songgagav/spiral_soft_arm/related-papers/README.md

# Reference paper

The PDF in this folder is an unchanged copy of:

Wang, Z., Freris, N. M., and Wei, X. “SpiRobs: Logarithmic spiral-shaped robots for versatile grasping across scales.” *Device* 3(4), 100646 (2025). https://doi.org/10.1016/j.device.2024.100646

The article is distributed under the [Creative Commons Attribution-NonCommercial-NoDerivatives 4.0 International license](https://creativecommons.org/licenses/by-nc-nd/4.0/). It is provided for non-commercial research reference and is not relicensed by this repository's `LICENSE` file. See the [publisher's article page](https://www.sciencedirect.com/science/article/pii/S2666998624006033) for the published version and license details.
