songgagav/spiral_soft_arm/hardware/reference/README.md

# Third-party hardware references

The STEP models and C610 user guide in this folder are reference material for component fit and system planning. They remain subject to their original vendor copyright and terms. The repository's root `LICENSE` does not grant rights to redistribute or modify these third-party files; check the source vendor terms before reuse.
