songgagav/spiral_soft_arm/local/spiral-soft-arm/hardware/README.md

# 本地样机硬件资料

本目录记录 B32 水下软体机械臂的硬件接口方案、监测接线和单台执行器验证流程。

## 当前资料

- [硬件拓扑图（PNG）](硬件连接拓扑图_2026-10-22.png)：用于快速查看岸上供电、脐带缆、头端电子仓、CAN、PWM、电机和监测支路。
- [硬件拓扑图（SVG）](硬件连接拓扑图_2026-10-22.svg)：可缩放的源图。
- [硬件拓扑与接口补充清单](硬件拓扑与接口补充清单_2026-10-22.md)：已确认参数、逐接口说明、建议补充的硬件、压降粗估和上电验证顺序。
- [4092 单台样机验证流程与记录模板](4092_单台样机验证流程与记录模板.md)：采购到货、PWM、带载、温升与水下测试记录。

## 图纸状态

图纸采用用户确认的 4S1P、每节 8 Ah、配套 mini ESC 双向 PWM 和 4 mm² 脐带动力线。电池侧电压/电流、UPS 输出母线电压/电流及电池、ESC、电源模块温度监测已加入接线拓扑。

图纸用于连接评审。实物连接器针脚、保险和接触器额定值、压力穿舱件、散热、UPS 再生回灌和整机运行时间需要按实际器件与样机试验核对。图纸不代表打印件、水密或 5 m 压力测试已经通过。
