songgagav/spiral_soft_arm/local/spiral-soft-arm/solidworks/electronics_enclosure_v24_selected_hardware/README.md

# B32 v24：选定硬件电子仓布置

## 范围

v24 沿用 v23 的 B32 三段机械臂、250 mm 六边形顶盘、三路 M3508/C620、直角传动、线轮和轴封候选。只重布直径 136 mm 的中央电子仓及其硬件占位，另存模型，不修改 v23。根据用户 2026-11-06 的确认，电池仍为 **21700 × 4**，4S1P；本轮所写的“12700”不用于模型。

电子仓外径 Ø136 mm、名义内径 Ø126 mm、仓体 Z=-230 至 -20 mm。内部件沿底盖检修方向分层：顶部为四节电芯与三只 C620；中部为主控、UPS 和原供电方案中的 9–35 V→24 V/15 A 稳压器；底部为 PD1002、理想二极管和 4S40A 保护板。M28 两芯 50 A 岸电口位于底盖中心，M12 Type-C 辅助供电口位于靠 PD1002 的侧壁。理想二极管布置在 Type-C 辅助输入后的短走线区域；实际电路连接仍须按模块端子核对。

## 按模型使用的外形尺寸

| 部件 | 数量 | 外形或安装代理，mm | 布置 |
| --- | ---: | --- | --- |
| 21700 电芯 | 4 | Ø21.55 × 70.21，沿用上一版包络 | 上层四并排座，电气为 4S1P |
| DJI C620 | 3 | 49.4 × 25.8 × 11.5，依据官方手册 | 沿三处电机线缆穿仓位置竖向贴壁 |
| 正点原子 STM32F407ZGT6 | 1 | 83 × 52 × 10，用户提供 | 右侧竖装，留可拆托板 |
| 后背式 UPS | 1 | 100 × 50 × 15，用户提供 | 中右竖装 |
| 原 24 V 稳压器 | 1 | 100 × 80 × 39，沿用之前确认的尺寸 | 左侧竖装，保留 4S 电池到 24 V 的转换空间 |
| PD1002 充放电板 | 1 | 48 × 34 × 5，用户提供 | 底层，靠 Type-C 口 |
| 理想二极管板 | 1 | 30 × 16 × 3，用户提供 | 底层，邻近 Type-C→PD 路径 |
| 4S40A 均衡保护板 | 1 | **暂按 60 × 30 × 10 占位** | 底层，独立于输入板 |
| M28 两芯 50 A 后装面板电源口 | 1 | **暂按 Ø29 开孔、Ø28 内伸 19 mm** | 底盖中心；实际安装图待核 |
| M12 防水 Type-C 母座 | 1 | **暂按 Ø15.4 开孔、内伸 18 mm** | 侧壁靠近 PD 区；实际安装图待核 |

STM32 使用用户提供的 83 × 52 × 10 mm；正点原子产品有不同尺寸的核心板/开发板，最终孔位和接口朝向须以手中那块板子的实测为准。每块板目前以实心包络建模，未虚构 PCB 固定孔、插头高度或排线半径。托板和边轨为位置候选，仍需在实物测量后增加可靠的紧固与拆装结构。

## 几何检查与使用界限

- 已生成中央电子仓 STEP、整机 STEP、半透明预览、分层俯视图和 `装配空间审查.json`。
- 13 个主要硬件包络及 14 个托板/轨道代理全部位于仓内，未与仓壁实体相交；主要硬件之间未发生实体重叠。
- 电子仓和整机 STEP 均已回读为有效 BREP，分别含 33 和 227 个实体。该检查仅证明当前代理几何可摆放，并未证明端子、插头、导线、螺丝和装配工具能进出。
- 三只 C620 的尺寸来自[大疆官方手册](https://cdn-hz.robomaster.com/robomasters/public/document/RoboMaster%20C620%20Brushless%20DC%20Motor%20Speed%20Controller%20V1.0.pdf)。M28 后装结构参考[50 A 产品系列](https://www.sunshineconnector.com/product/ew-m28mpr/)，M12 Type-C 的 Ø15.4 面板孔仅参考[同类产品说明](https://www.kinsun.com/zh-CN/product/Waterproof-M16-USB-C-90-degree-PCB-mount.html)，均不能替代所购物料的正式机械图纸。

## 打印前仍需解决

1. 实测 4S40A 板的外形、最高元件和端子位置；核对 PD1002、理想二极管、UPS、STM32、稳压器的固定孔和插头弯线空间，再定可拆托架。
2. 获取确切 M28/M12 料号和面板安装图，按实物修改开孔、壁厚、O 形圈压缩与内伸深度；当前 Ø29/Ø15.4 仅为占位，尚未证明 5 m 防水。
3. 两芯 M28 只能传送岸电正负极。岸端 CAN 通信还缺一条确定的密封走线；不得把 CAN 线无密封地从电源孔挤入。
4. STM32F407 板不能直接接 24 V，还需在仓内明确 24→5 V 降压模块、走线和接地。当前模型没有这块模块的外形和插头空间。
5. PD1002 的具体充放电协议、4S 16.8 V 充电路径、Type-C 供电能力、4S40A 保护板电流余量、UPS 切换与回灌行为都需拿到接线图并做台架验证。Type-C 仍只作为辅助输入。
6. 托架的最终螺钉、接线应力释放、三只 C620 的散热及整仓水压/漏水测试尚未完成。

## 文件

- `B32_v24_选定硬件电子仓.step`：中央电子仓和硬件占位，可单独审核。
- `B32_v24_三路M3508与选定电子仓总装.step`：整机装配候选。
- `B32_v24_电子仓半透明装配预览.png`：透视和侧视。
- `B32_v24_电子仓分层布局图.png`：分层俯视位置。
- `parameters.json`、`generate_selected_hardware.py`、`render_layout.py`：参数与再生成脚本。
- `装配空间审查.json`：这次运行的几何检查结果。
