songgagav/spiral_soft_arm/docs/superpowers/specs/2026-11-07-v26-arm-electronics-integration-design.md

# B32 V26 原机械臂与 V25 电子仓整合设计

## 意图

建立独立的 V26 整机候选，把当前 V25 电子仓与原 B32 机械臂、燕尾分段、根部顶盘和三路 M3508 驱动明确整合为一套可审查总装。V26 用于整机空间与接口复核，不取代原机械臂、V23 机械接口基线或 V25 电子仓候选。

## 目标

- 保留原 B32 机械臂的五个实体、现有燕尾分段和坐标系，机械臂根面继续位于 `Z=0 mm`。
- 完整复用 V25 的电子仓、M28 后装接口、21700×4、STM32、UPS、稳压器、PD1002、BMS、理想二极管和 5 V 降压模块。
- 保留三路 M3508、直角传动、轴封、湿侧线盘及现有直线拉索入口。
- 输出独立的 V26 整机 STEP、全高半透明预览、根部接口近景和整合审查 JSON。
- 验证机械臂、根部顶盘、三路拉索入口、驱动干仓和电子仓仍处于同一坐标系，新增整合不产生非预期体积干涉。

## 非目标

- 不修改原 B32 软臂单元、燕尾榫尺寸或拉索通道。
- 不重新设计 V25 电子仓内部硬件位置。
- 不把 STEP 可回读或静态无干涉描述成打印、水密、承载或运动验证。
- 不覆盖现有 V23、V25 STEP、预览和审查记录。

## 方案选择

1. **新建 V26 独立整机候选（已选择）**：版本边界最清楚，可单独审查和回退；代价是新增一套约 85 MB 的整机 STEP。
2. 在 V25 内增加整机预览：文件较少，但电子仓版本与整机整合证据混在一起。
3. 覆盖原机械臂总装：文件最少，但会破坏原始基线和追溯关系，因此排除。

## 结构与文件

新目录：`local/spiral-soft-arm/solidworks/integrated_assembly_v26_arm_and_v25_electronics/`

- `parameters.json`：记录 V26 来源、坐标约束和验证边界。
- `generate_integrated_assembly.py`：调用 V25 `build_v25_components()`，筛除仅用于观察的服务包络，构建并导出 V26 总装。
- `render_integrated_assembly.py`：生成整机全高预览和根部接口近景。
- `test_v26_integration.py`：检查必需部件、原机械臂边界、坐标关系、接口空间和 STEP 回读。
- `B32_v26_原机械臂与V25电子仓整合总装.step`：独立整机装配。
- `B32_v26_整机半透明预览.png`、`B32_v26_根部与电子仓接口近景.png`：审核图。
- `整机整合审查.json`：实体数量、边界、接口和未验证项。

## 验证方法

- 原机械臂部件必须为 `B32_v10_arm_sections_and_dovetails`，保持 5 个实体，包围盒约 `59.445×66.656×550.014 mm`，根面 `Z=0 mm`。
- V25 电子仓、M28、三路驱动及根部顶盘的必需命名部件必须全部存在。
- 机械臂与电子仓必须分处顶盘两侧，电子仓最高点不得进入机械臂主体空间。
- 三路拉索入口仍按 60°、180°、300°对应原机械臂三路通道；不改变既有切线出线与斜孔几何。
- V26 STEP 导出后必须重新导入为有效 BREP，并记录实体数量与整机包围盒。
- 审查结果必须继续列出：M28实物端子、PCB孔位、线束、散热、O形圈、水压、拉索动态摩擦和燕尾受力均未通过实物验证。

## 成功边界

V26 完成表示“原机械臂、三路驱动和当前电子仓已形成坐标一致、STEP 可读的静态总装候选”。它不表示可直接打印，也不表示机构运动、密封、供电或5 m水深运行已经验证。
