songgagav/spiral_soft_arm/docs/superpowers/specs/2026-11-06-v25-power-input-and-m28-design.md

# B32 v25 电源输入与 M28 接口设计

## 目的

在 v24 电子仓基础上加入 42×24×5 mm、输入 5–35 V、额定 20 A 的 STM32 降压模块，并按用户提供的 M28-2 芯/50 A 后装面板插座图更新底盖接口。模型继续沿用 v23 的三路 M3508 机械结构和 v24 的选定电子硬件。

## 已确认约束

- 电池为 21700×4、4S1P。
- PD1002 支持 4S 16.8 V 充电、Type-C 双向充放电、岸电与 Type-C 同时接入，以及外部供电时同步给电池充电。
- 30×16×3 mm 理想二极管用于阻止输入支路回灌。
- STM32 降压模块外形为 42×24×5 mm，输入 5–35 V，额定 20 A；模型将其作为 24 V 母线至 STM32 5 V 支路的模块包络。
- M28 插座采用用户图片尺寸：面板异形孔 26.2×28 mm、安装圆柱名义 Ø27.8 mm、后装内侧法兰名义 Ø36 mm、安装面板厚度不超过 5 mm、插座轴向包络按 38.5 mm、配套公插头按 Ø33×71.5 mm。

## 设计

建立 `electronics_enclosure_v25_power_input_and_m28`，不覆盖 v24。M28 保持在底盖中心；在原 10 mm 底盖内侧加工局部沉台，使连接器夹持区剩余 5 mm，Ø36法兰位于仓内侧，沉台外围保留原厚材料作为承力环。开孔用 Ø28 mm 圆与 26.2 mm 宽平面相交形成异形孔。模型加入插座、保护盖系带和外接公插头包络，用于检查插拔与电缆空间。

降压模块放在 STM32 与 UPS 邻近的独立托架上，避免占用 M28、PD1002、理想二极管和 BMS 的底层接线区。更新分层布局图和说明，固定以下逻辑：岸电与 Type-C 经各自防回灌路径进入 PD1002/UPS 电源路径；外部供电可同时带载和给 4S 电池充电；24 V 控制母线经新增降压模块向 STM32 提供 5 V。

## 验证边界

几何检查需证明新增降压模块、托架、M28 插座和公插头包络不与仓体及既有硬件发生非预期干涉，沉台剩余厚度为 5 mm，电子仓和整机 STEP 均可回读。用户图片没有给出 M28 密封圈沟槽、螺母精确外形和端子尾部尺寸；这些仍需用到货件测量后定型。额定 20 A 仅按用户提供信息记录，不在本轮证明温升或持续输出能力。
