songgagav/spiral_soft_arm/local/spiral-soft-arm/hardware/M3508_C620_供电拓扑重规划_2026-10-25.md

# M3508 / C620 供电拓扑重规划

日期：2026-10-25；修订：2026-10-26（增加 Type‑C 电池充电输入）。本文配套[供电拓扑图 PNG](硬件供电拓扑图_M3508_C620_2026-10-25.png)和[SVG 源图](硬件供电拓扑图_M3508_C620_2026-10-25.svg)。它针对当前三台 DJI M3508 P19、三只 C620、岸上隔离 24 V、5 m 双芯电缆、4S1P 8 Ah 电池、24 V/15 A 电池升压器和 UPS 候选重新安排供电路径，并加入岸电与 USB‑C PD 两种电池充电输入。

## 设计目标与采用的结构

采用**岸电直供电机主路、UPS 单独保持控制、备电限流后提供可选低功率电机动作**的分级结构。这样电机额定电流不必穿过额定值未知的小型 UPS 板；UPS 只承担控制母线及限流应急支路。

```text
岸上隔离 24 V (+ / 0 V)
  └─ 5 m 脐带缆 → 水密入口 → F_MAIN / 反接与浪涌保护 → 24 V 主输入
       ├─ K1 常开直流接触器 → 电机配电母线 → F1/F2/F3 → C620 ×3 → M3508 ×3
       ├─ UPS MAIN → UPS OUT 控制母线 → F_LOGIC → 24→5 V 降压 → STM32 / CAN / 传感器
       └─ J12 输入 A（24 V）┐
                            ├→ 岸电优先选源 → 单级 16.8 V CC/CV → BMS 充电端
USB‑C PD → J7 / 20 V 受电 → J12 输入 B ┘

4S1P 8 Ah → BMS → F_BAT → 9–35 V→24 V/15 A 升压（EXT_PWR_GOOD互锁，备电总限流 ≤10 A）
       └─ UPS BACKUP → UPS OUT
                └─ K2 互锁 + ≤5 A 限流 → 电机母线（可选单台低功率应急动作）

USB‑C PD → PD 受电协商 20 V → 限流分支 ┬→ UPS AUX（电压匹配后接入）
                                        └→ J12 输入 B（作为 4S 备用充电源）
```

岸电存在时 K1 闭合、K2 断开，电机由岸上 24 V 直接供电；UPS 同时维持 STM32 和传感器。岸上 24 V 与 Type‑C PD 都能给 4S 电池充电：两路分别进入带反灌隔离和限流的选源级，优先选岸电，岸电不可用时选 Type‑C，然后共用一个 16.8 V CC/CV 充电级接 BMS。两路输入不直接并联，也不把 24 V 或 USB‑C VBUS 直接接到电芯。Type‑C PD 还可分一路给 UPS AUX，但 AUX 与充电器合计功率不得超过 PD 合同额度；充电电流应随 AUX 负载限额。

同一时刻禁止“电池充电”和“电池升压给 UPS 供电”：J12 的 EXT_PWR_GOOD 检测到岸电或有效的 Type‑C PD 输入时关闭备电升压；两个外部输入都失效后才启用电池升压。J12 选源不将两路输入并联；岸电与 Type‑C 同时接入时岸电承担充电，Type‑C 可为 UPS AUX 供电。这样避免电池一边充电、一边升压回供 UPS。岸电主路电流或 Type‑C PD 总功率接近限值时，先降低或暂停充电，控制和动力负载优先。

岸电消失后 K1 释放，UPS 接管控制母线。只有在电池、BMS、UPS 余量满足时才允许 K2 接通，且备电总输出保持在 10 A 以内，K2 支路限制在 5 A，并一次只驱动一台电机。K1/K2 必须有电气或机械互锁，避免电池备电回灌到岸电主路。若总电流、低电压或温度越限，K2 断开，控制与监测继续运行。

## 接口与走线

| 编号 | 连接 | 线与保护要求 |
|---|---|---|
| J1 | 隔离岸上 24 V ↔ 脐带缆 | 两芯分别为 +24 V 和 0 V 回流；两根都走水下线缆。岸上 AC PE 按电源说明接 FG/机壳，不接水体。 |
| J2 | 4S1P 电芯组 → BMS | B−、B1–B3、B+ 电压采样；电池温度探头接 BMS。 |
| J3 | 脐带缆 → 头端输入保护 | 正极设置总保险；加入反接、浪涌/瞬态保护和岸电电压/电流采样。保护后分给 K1、UPS MAIN 与 J12 输入 A。 |
| J4 | BMS P+/P− → 电池升压器 | 正负线都经 BMS；电池正极按升压器输入和线径配置 F_BAT；J12 输出的 EXT_PWR_GOOD（岸电或 PD 有效）控制升压器使能。 |
| J5 | 24 V/15 A 升压器 → UPS BACKUP | 岸电或 Type‑C PD 任一有效时升压器关闭，二者都失效后启用；备电总输出限在 10 A，禁止充放电循环。约需 20–24 A 电池侧电流，需确认 BMS、电芯与导线持续能力。 |
| J6 | UPS OUT → 控制电源 | UPS 输出经 F_LOGIC 到 24→5 V 降压模块，再到 STM32G474VET6；控制地接本机 DC 0 V。 |
| J7 | Type‑C PD → UPS AUX 与 J12 输入 B | PD 受电端请求 20 V；经过独立支路保护与总功率限流，分别供 UPS AUX 和 4S 充电选源输入。若 AUX 接受 PD 电压则直入，否则只增加一块匹配电压的 DC/DC。 |
| J8 | 电机主母线 → C620 电源支路 | K1 为岸电主路；K2 是互锁的备电支路。母线设置总电流采样，C620 各自设置 F1–F3。 |
| J9 | 配电母线 → C620 ×3 | 24 V 正负电源分别到三只电调；按所购线束、接插件和 C620 输入要求制作。 |
| J10 | C620 ×3 → M3508 ×3 | 每台同时接三相 U/V/W 与配套 7‑Pin 数据线；三相线与信号线分束固定。 |
| J11 | 岸上 NC 急停回路 → K1/K2 线圈 | 急停、断线或控制电源故障时释放动力接触器，UPS 控制输出继续供电。接触器触点需为直流额定。 |
| J12 | 岸电保护 24 V / Type‑C PD 20 V → 4S 充电级 → BMS 充电端 | 双输入选源，岸电优先、PD 备用并防反灌；共用 16.8 V CC/CV 输出。J12 同时给出 EXT_PWR_GOOD；PD 总功率由 AUX 与充电支路分配，充电电流按输入余量、电芯和 BMS 规格设定。 |
| J13 | 电压、电流、温度 → STM32/BMS | 采集岸电、主母线、备电、电池电流/电压；测电池、升压器和三只 C620 温度。电芯温度优先接 BMS。 |

岸上隔离电源的 0 V 是 +24 V 回流线，不需要另找水下地线。不得让水体、拉索、屏蔽层或塑料舱体承担回流。若使用屏蔽通信缆，屏蔽层与 PE 的接法按接口隔离方案处理；岸端 CAN 应与本机电源地隔离。现有两芯动力缆不含 CAN 双绞线，岸端 CAN 需另走通信双绞线，或另选复合脐带缆。

## 减少变换级与电力损耗

- 电机动力直接使用岸上 24 V 主路，不经过 24→12→24 或 UPS 输出级。
- 逻辑电源从 24 V 控制母线通过单级 24→5 V 降压供电，不再串接 12 V 中间级。
- 岸电 24 V 与 Type‑C PD 20 V 经反灌隔离和岸电优先选源，共用一个 4S CC/CV 充电级；不安装两套并联充电器，也不把输入电源直接并接。充电器应能承受实测岸电最高输入电压。
- Type‑C PD 受电端请求 20 V，以便单级降压至 4S 满充 16.8 V；若 PD 电源只能提供低于充电器所需的电压，则必须用升降压充电器，会增加转换损耗。USB‑C PD 同时供 UPS AUX 和电池充电时，按 PD 合同总功率限流，优先保证控制负载。
- UPS AUX 能直接接受所协商 PD 电压时不再转换；不能接受时只增加一块匹配电压的 DC/DC，不串接多级模块。控制板仍从 24 V 控制母线经单级 24→5 V 降压供电。
- 主动力、充电、逻辑三路分开；电源总线采用短粗线、单点 0 V 星形回流和匹配电流的接插件。岸电高负载或 Type‑C AUX 负载增大时降低充电电流，任一外部电源有效时关闭备电升压以减少静态损耗。

若要把 4S 充电级与 4S→24 V 备电升压级合成一个双向 DC/DC，模块必须同时支持 4S CC/CV 充电、24 V 反向输出、输入优先与反灌保护，并满足备电功率。当前备电上限 24 V/10 A 为 240 W 连续功率；常见小功率双向充电板不能直接视为满足该额定值。先核对现有 UPS/转换器铭牌，不用低功率板替代已确认的 24 V/15 A 升压级。

USB‑C 方案要求带 PD 受电协商的输入模块，而非只引出 5 V 的 Type‑C 插座板。USB‑IF 的 PD 资料列有 20 V 固定电源档；TI 的 [TIDA‑050047 参考设计](https://www.ti.com/tool/TIDA-050047)示例了 20 V/5 A PD 输入为 2–4 串电池充电。该参考设计仅说明可实现性，并不代表当前已经选定其板卡；实际 PD 电源须支持所请求的档位，UPS AUX 与充电支路还要共用该 PD 功率预算。[USB‑IF PD 说明](https://www.usb.org/usb-charger-pd)。

## 粗略功率预算

大疆 M3508/C620 手册的参考额定点为 24 V、3 N·m 时约 10 A/台，三台同时工作约 30 A、720 W，尚未计控制和监测负载。[官方手册](https://rm-static.djicdn.com/robomasters/public/document/RoboMaster%20M3508%20P19%20Brushless%20DC%20Gear%20Motor%20V1.0.pdf)。因此建议岸上隔离 24 V 电源和 K1 主电机路径至少按 35 A 连续能力设计，并以 C620、电机、连接器和实际电流中最低的额定值作为最终上限。

现有 4 mm² 铜导体、5 m 单程形成约 10 m 回路。按铜电阻率约 0.0175 Ω·mm²/m 粗算，回路电阻约 0.0438 Ω：

- 30 A 时压降约 1.31 V，线缆发热约 39 W，未计接插件；
- 若保留 4 mm² 线，建议先把岸电主路总电流限制在约 15 A，并实测线温与端电压；
- 若要支持三台约 30 A 的额定点，建议将动力缆提升到约 10 mm²，并重新确认柔性、浮力、接插件和弯曲半径。

4S1P、14.8 V、8 Ah 标称能量约 118.4 Wh。备电总输出限制为 24 V/10 A 时，15 分钟约消耗 60 Wh（不计损耗）；这为 UPS 控制负载和少量低功率动作留出能量空间，但仍须用实际电池、BMS 和变换器验证。三台电机在额定点连续运行 15 分钟约需 180 Wh，当前电池不能支持这一满负载备电工况。当前 UPS 的输出电流与切换时间、BMS 放电电流、各保险/接触器、导线温升均须按实际铭牌确认。

## 保护与运行策略

1. 岸电与电池备电正极分别保护；电机三路分别保护；保护器件按线材、接插件、电调和测得峰值电流选择，不在本候选图中预设保险丝安培数。
2. K1/K2 执行先断后合，阻断主路与备电路之间的反向电流。急停硬接线切断电机动力，STM32 与记录数据由 UPS 保持。
3. 岸电有效时优先用岸电充电；岸电失效但 Type‑C PD 有效时，由 Type‑C 在 UPS AUX 负载预算之外给电池充电。任一外部输入有效时备电升压关闭；两路都失效时才启用。断岸电后固件切换为低功率模式：默认停止电机，仅在有明确安全动作时单台低速点动；全系统备电输出不超过 10 A。
4. 监测过流、低电压、升压器过温、C620 过温与电池温度。触发阈值按电芯、BMS、UPS 和电调资料设定，并在台架测试中验证。
5. C620 电机制动可能造成母线能量回灌；按 C620 手册确认回灌处理和过压保护方案后再定型。

这是供电结构候选，不代表现有 UPS、BMS、充电器、线缆或接插件已经满足目标额定值，也不构成 30 分钟运行或 15 分钟备电的试验结论。
