songgagav/spiral_soft_arm/local/spiral-soft-arm/hardware/M3508_C620_干式驱动拓扑候选_2026-10-25.md

# M3508/C620 干式驱动连接拓扑候选

本页对应 CAD v16。电机改为大陆可采购的 DJI RoboMaster M3508 P19，原厂 19:1 减速箱与电机作为一件维护；电调改为与之配套的 C620 ×3。电机、电调、STM32、UPS 和电池位于共用干仓，湿侧仅有线盘和穿过轴封的短段轴。

## 最新供电拓扑

供电改为主动力与备电控制分级，避免让外形较小、额定值待核对的 UPS 板直接承受三路电机主电流。请看[供电拓扑图 PNG](硬件供电拓扑图_M3508_C620_2026-10-25.png)、[SVG 源图](硬件供电拓扑图_M3508_C620_2026-10-25.svg)和[供电设计说明](M3508_C620_供电拓扑重规划_2026-10-25.md)。旧 4092/mini ESC 图仅作历史记录。

核心连接关系：

```text
岸上隔离 24 V → 双芯脐带缆 → 输入保险/反接与浪涌保护 → 24 V 电机主母线
                                                     ├─ K1 主电机接触器 → 三路保险 → C620 ×3 → M3508 ×3
                                                     └─ UPS MAIN → 控制与监测母线
                                                     └─ J12 双输入选源（岸电优先）→ 16.8 V CC/CV → BMS
4S1P 电池 → BMS → 保险 → 24 V / 15 A 升压（任一外部电源有效时关闭）→ UPS BACKUP → 控制母线
USB-C PD → 20 V 受电 / 限流分支 ┬→ UPS AUX（电压匹配）
                                └→ J12 第二充电输入（岸电失效时）
岸电故障 → K1 断开；控制、CAN 和监测继续由 UPS 供电；可选 K2 仅允许限流的单电机应急动作
```

岸电和 USB‑C PD 都可为电池充电：两路经反灌隔离与选源功能进入同一充电级，岸电优先，岸电断开后由 Type‑C 作为充电输入；两种电源不可直接并联。单级 16.8 V CC/CV 输出接 BMS 充电端。岸电有效时电机主路仍由 24 V 直接供电。任一外部输入有效时关闭电池升压器，仅在岸电与 Type‑C 均失效时启用备电，避免一边充电一边从电池升压供电。

USB‑C PD 输入同时分支给 UPS AUX 和电池充电选源级；建议请求 20 V，且两个支路之和不得超过 PD 协商的功率。充电器应动态限流，避免 UPS AUX 启动或负载上升时 USB‑C 过载。20 V 可用单级降压充到 4S 的 16.8 V；若 PD 源不给 20 V，则改用升降压充电级，会增加损耗。UPS AUX 可直收协商电压时不再加 DC/DC，否则只加一块匹配电压的模块。STM32 控制电源从 24 V 控制母线经单级 24→5 V 降压供电，省去 24→12→5 V 级联。

C620 接收 CAN 指令，也支持 PWM；当前建议用本地 CAN，因为 C620 可返回电机温度、位置和转速。电机与电调之间必须同时连接三相功率线和 7-Pin 数据线，不能仅连接 CAN。C620 的 49.4 × 25.8 × 11.5 mm 尺寸不含线束，CAD 中三块电调是本体包络；接插件朝向和线束弯曲半径需要拿到实物后补画。[大疆 M3508/C620 产品页](https://www.robomaster.com/zh-CN/products/components/general/M3508)、[M3508 官方手册](https://rm-static.djicdn.com/robomasters/public/document/RoboMaster%20M3508%20P19%20Brushless%20DC%20Gear%20Motor%20V1.0.pdf)。

**功率约束：** DJI 手册给出的 M3508/C620 额定工作点约为 24 V、10 A/台；三台约 30 A、720 W，另需计入控制器等负载。[M3508 官方手册](https://rm-static.djicdn.com/robomasters/public/document/RoboMaster%20M3508%20P19%20Brushless%20DC%20Gear%20Motor%20V1.0.pdf)。因此岸上电源及电机主路径按至少 35 A 连续能力预留；现有 5 m、两芯各 4 mm² 铜线在 30 A 时往返压降粗估约 1.31 V（未计接插件），建议若保留该线缆先把主路限在约 15 A，若需要 30 A 工况则换更粗线并复核水下柔性、接插件和温升。

4S1P、14.8 V、8 Ah 的标称能量约 118.4 Wh。即使忽略损耗，三台在额定工作点运行 15 分钟需要约 180 Wh；所以当前电池不应被画成三台电机满额备电源。默认断岸电策略为 K1 断开、控制/通信/监测继续运行，备电总输出限流至 10 A；只有 UPS/BMS 实际额定值和温升允许时，才启用 K2 单台电机低功率动作，且电机动作电流包含在 10 A 总预算内。电池侧升压输入约需 20–24 A（随电池电压和效率变化），需核对电芯、BMS、导线与保险的持续能力。

4S 电池可由岸上 24 V 或 USB‑C PD 充电：两路分别接入带反灌保护的选源充电级，岸电优先、Type‑C 备用，随后共用 16.8 V CC/CV 和 BMS。USB‑C PD 请求 20 V，并将协商总功率分配给 UPS AUX 与电池充电；PD 电流不足时优先控制负载、降低充电电流。电池升压器由岸电或 PD 任一有效信号关闭，两个外部输入都失效时才开启。

本拓扑仍未冻结保险丝、K1/K2 线圈与触点额定值、UPS 直通电流、主电源型号、接插件、BMS 型号和 STM32 引脚号。若现有 UPS 的 24 V 主路不能连续通过 35 A，电机主路应旁路该 UPS，UPS 只带控制母线；装配前按实物手册核对端口，单台验证电流和温升，再接入三机与拉索。
