songgagav/spiral_soft_arm/docs/superpowers/specs/2026-10-23-b32-shared-dry-motor-chamber-design.md

# B32 共用隔水电机仓设计

## 目的

将三台不防水的 DJI M2006 完全置于一个与水隔离、可检修的干侧空间。三只线盘留在湿侧，拉索从线盘切线出口直达六边形顶盘和机械臂线孔。

## 约束与边界

- 保留 250 mm 六边形顶盘、三条径向拉索路线、关节内部燕尾榫分段、根部固定区护罩和半透明外罩预览。
- 电机水平放置，电机轴线可在俯视面内旋转；线盘切线与对应拉索孔、机械臂牵引方向共线。
- 仅线盘及拉索路线允许接触水；M2006、C610、电池和主控均在干侧。
- 共用密封仓可在打印机 350 × 350 × 320 mm 平台上分件制造；机械臂分段仍按 250 mm 有效成型高度约束。
- 本轮产物是几何和装配候选，不代表 5 m 水深下的压力认证或可打印放行。

## 考虑的方案

1. 三个独立密封电机筒：每台电机单独检修，但有三套端盖和静密封接口，仓间布线复杂。上一版外伸筒体也使干湿边界不直观。
2. 共用干侧电机仓：三台电机收拢于顶盘下方，三处轴封通向各自的开放湿侧线盘区；后盖通过干侧管路连通中央电子仓，清楚显示干湿分界。用户选择此方案。

## 布局

- 将线盘中心从约 96 mm 径向位置向内移动到约 55 mm，缩短其至顶盘线孔的直线路径。
- 三台水平 M2006 沿各自线盘轴线向外/切向放置，全部位于半透明保护外罩及共用干仓投影内；每处由独立轴承承担线盘载荷，再穿过骨架油封与迷宫前室。
- 中央电子舱下移，腾出顶盘下的电机层；干侧电机层与中央电子舱连通，不通过开放孔暴露于湿侧线盘凹位。
- 共用仓体的三个电机舱瓣采用可拆检修后盖，标示静密封界面、三处旋转轴封界面以及开放湿侧线盘区。外部面板仍保留观察和排水开口，但这些面板不作为隔水边界。

## 交付与检查

- 新版本参数、生成脚本、STEP 总装、半透明预览、俯视/剖视图、布局说明和几何审计；保留 v11 文件作为前一候选。
- 核对电机包络与仓壁、顶盘、线盘、电子舱及外罩的相交/间隙；核对三条出线路径的共线性、线盘至线孔长度和主要分件打印包络。
- 油封型号、旋转轴表面、仓盖 O 形圈、螺栓和受压性能仍须依据实物及台架验证选定，不在本轮宣称已验证防水。
