songgagav/spiral_soft_arm/local/spiral-soft-arm/hardware/M2006_C610_干式驱动拓扑候选_2026-10-23.md

# M2006/C610 干式驱动的连接拓扑候选

更新：2026-10-23。此文件替代 4092/mini ESC/PWM 作为**当前驱动设计方向**；旧拓扑文件保留为历史版本。器件仍需按实际接口和供电能力定型。

```text
岸上隔离 24 V + / 0 V ── 脐带缆 ── UPS 主输入
4S1P 电池 14.8 V 标称 ── BMS ── 9–35 V→24 V 稳压/升压 ── UPS 备用输入
USB-C PD ── 辅助升压与防反灌 ── UPS 辅助输入
UPS 24 V 输出 ── 总保险/急停接触器 ┬─ 支路保险 1 ─ C610-1 ─ 三相线+编码器线 ─ M2006-1
                                ├─ 支路保险 2 ─ C610-2 ─ 三相线+编码器线 ─ M2006-2
                                └─ 支路保险 3 ─ C610-3 ─ 三相线+编码器线 ─ M2006-3
UPS 24 V 输出 ── 逻辑支路保险 ── 降压模块 ── STM32G474 控制板
STM32 ── 本地 CAN 收发器 ── CANH/CANL ── C610-1/2/3（各自 ID）
岸上隔离 USB-CAN ── 脐带 CANH/CANL/CAN_REF ── STM32 岸端通信接口
```

三台 C610 位于中央密封电子仓，三台 M2006 位于各自干式电机筒。**每台电机的三相线和编码器线**须从中央仓经过静态密封穿舱件、水下额定电缆、再经过电机筒静态穿线件；不能让线束从敞孔穿过。各轴只有线盘处于湿侧，轴穿出处由迷宫和骨架油封组件处理。电机筒后盖、中央仓穿线口、油封座的静密封以及润滑均尚未选定实物。

DJI 将 M2006 P36 与 C610 列为配套系统：24 V 额定，C610 采用 CAN 指令，单台最大持续电流标称 10 A。三台驱动不能凭现有 24 V/15 A 稳压模块的铭牌直接判定满载可用；需要在设定 C610 电流限幅后测量岸电、UPS 和电池支路的实际输入峰值。岸上通信 CAN 与 C610 本地 CAN 的物理总线、速率和终端应分别设计；若板卡只有一路可用 CAN，需要增加另一接口或网关，不应直接把两路未经核对地并线。

来源：[DJI RoboMaster M2006 动力系统](https://www.robomaster.com/en-US/products/components/general/M2006)。
