songgagav/spiral_soft_arm/local/spiral-soft-arm/hardware/4092_单台样机验证流程与记录模板.md

# ApisQueen 4092 单台样机验证流程与记录

**状态：** 未执行；当前项目目录未提供样机或供应商尺寸图。此模板不代表已经采购或通过验证。

**目的：** 在决定从 1 台扩展到 3 台前，记录实际接口、带载能力、温升、闭环控制与水下验证证据。

## 安全与适用边界

- 测试前固定电机和线轮，给旋转部件加防护；用限流电源和已校准的测力/扭矩装置。不得徒手约束输出轴或腱线。
- 水下测试只使用适用于该电压和环境的电源/接插件。记录水温、水体、深度/压力、持续时间、线缆和密封边界。
- 5 m 表压约 49–50 kPa。普通水桶浸泡不能作为 5 m 验证；5 m 测试须在经核验的压力设备中进行，先完成整个安装组件的结构审查。MuJoCo 结果不作压力舱或密封通过证据。
- 海水测试后按供应商说明以淡水冲洗并记录腐蚀/残留检查。

## 测试顺序与通过门槛

1. **来料检查：** 记录型号、序列号、包装、铭牌、线缆、Mini ESC 版本、照片和供应商批次；发现损伤即停止。
2. **接口测量：** 测量主体外廓、安装面/孔位、输出轴直径与伸出量、允许径向/轴向载荷、电缆出线与弯曲空间。与安装件图逐项对照；没有书面公差或实测记录时标为未确认。
3. **空载基线：** 在 12 V、24 V（以铭牌范围和驱动器限制为准）测正反转转速、停止/反转响应、空载电流、噪声/振动和温升。保留原始采样数据。
4. **带载曲线：** 用制动器/测功机测输出端扭矩、转速、电压、电流和温度；分开标记短时峰值和连续稳定工况，逐点记录持续时间、环境温度与冷却状态。不能用齿轮箱宣传峰值替代连续曲线。
5. **反馈与限幅：** 验证输出角度编码器、位置/速度闭环、限流/限矩、急停与线轮 `0…20π rad` 行程保护。若 Mini ESC 不支持，另记驱动器、传感器和接口成本及待集成项。
6. **水下检查：** 先按批准的 1 m 工况做淡水与海水试验，检查进水、绝缘、温升和输出变化；5 m 压力测试单独安排并记录压力设备校准和总装状态。任何渗水、异常电流或温度超限均为失败。
7. **拆检与复测：** 记录轴承/减速器阻力、锈蚀、润滑和密封变化；淡水冲洗海水样机后复测空载转速与电流。

**通过原则：** 接口图/实测尺寸相符；带载曲线覆盖仿真需求并留有明确裕度；连续温升、限流/限矩、编码器闭环、线轮全行程和规定水下试验均通过。任一项缺资料、未测或失败，候选仍保持“未通过单台验证”，不得直接按三台采购或标为最终选型。

## 单台记录表

| 项目 | 记录 |
|---|---|
| 样机型号/序列号/批次 | 待填写 |
| 测试日期/人员/仪器校准编号 | 待填写 |
| 外形与安装接口测量/图纸版本 | 待填写 |
| 电压/ESC/控制信号 | 双向 PWM（用户确认）；实物刷新率、中位与失控默认值待记录 |
| 正反转空载转速、电流与温升 | 待填写 |
| 带载输出曲线文件及连续/峰值定义 | 待填写 |
| 编码器型号、分辨率、闭环误差 | 待填写 |
| 限流/限矩/急停/行程测试 | 待填写 |
| 淡水 1 m 测试装置、深度、时长、结果 | 待填写 |
| 海水 1 m 测试装置、深度、时长、结果 | 待填写 |
| 5 m 压力设备、压力、时长、总装审查编号 | 待填写 / 未执行 |
| 进水/绝缘/腐蚀/拆检照片或数据 | 待填写 |
| 总结：通过 / 失败 / 待补测 | **待测** |

## 供应商待确认项

- 0–100 rpm 与 0–200 rpm 的具体型号/电压条件；网页“2V: 54 rpm”是否为录入错误。
- 8 N·m、24 V 最大 4.5 N·m 与速度—扭矩表的关系；输出测试位置、持续时间和连续/峰值定义。
- 310 g 对应的电机+减速器+线缆/ESC范围；外形尺寸、轴端公差和允许轴载荷。
- 电流、温升、占空比、寿命、Mini ESC 限流/闭环能力及海水维护要求。
- 单台样机的淡水/海水与 5 m 压力测试条件和书面记录。
