songgagav/spiral_soft_arm/docs/superpowers/specs/2026-10-10-spiral-soft-arm-prototype-design.md

# 550 mm 三缆对数螺旋软臂 V2 几何与样机设计说明

**状态：** 阶段 A 本地几何已冻结为 B32 `cut_off`；首轮打印前机械包已由 Blender 5.2.2 LTS 生成并完成网格/STL往返检查。TPU 工艺、真实装配间隙、材料强度和抓取性能仍需实物验证。  
**目标：** 形成可参数化建模、可外包打印、可由三台 M2006 驱动并进行轻型物体抓取试验的三缆连续软臂方案。

## 1. 设计目标与暂定输入

| 项目 | V2 起点 | 状态/说明 |
|---|---|---|
| 机构 | 三根腱线相隔 120° 的连续软臂 | 三路独立输入；按欠驱动系统处理，不预先声称末端有三个独立可控转动自由度 |
| 名义长度 | 550 mm | 无载直线状态下软臂主体中心线长度；不含刚性底座和端部附件；装配总长另报 |
| 基部直径 | 68 mm 目标值 | 指软臂本体基部截面的最大实体外接直径，不含安装法兰、电机座和电缆 |
| 软端直径候选 | 5 mm、7 mm | Blender 实测后首打样选 B32；软端约 7.359 mm，端部帽为独立低轮廓件 |
| 主体材料 | TPU 95A | 外包打印；记录品牌、型号、批次和工艺 |
| 弹性轴 | 参考三缆论文的局部厚度比约 10% | 现有工具的 `elastic_percent` 不是该厚度比，必须测量生成实体截面 |
| 腱线 | 约 0.5 mm UHMWPE | 参考原论文；确认供应线实际直径、强度与伸长率 |
| 腱线孔 | 1.2 mm 名义起始值 | 仅为穿线样条候选值，须同时检查壁厚、孔间距、磨损和弯曲卡线 |
| 电机与电调 | 3× DJI RoboMaster M2006 P36 + 3× C610 | 保留论文原型依据；每根腱线由一路驱动 |
| 收线轮 | 单层螺旋线槽，有效半径约 6.5 mm | 理论单层收线约 408.4 mm；实际行程由运动学和打样校准确定 |
| 负载目标 | 首轮不超过约 100 g | 试验目标，不构成承载保证；记录物体尺寸、表面和保持时间 |
| 主体制造 | 一体式 TPU 95A，名义长 550 mm | 外包厂须确认有效成型高度≥560 mm；先打短样条，不合格再考虑分段 |

CAD 几何目标按中心线长度 550±5.5 mm、基部最大实体外接直径 68±1 mm、候选尖端直径 ±0.5 mm、整数单元数精确匹配设定；Blender 网格验收已完成，实际打印件公差仍需外包厂确认。最小可制造壁厚、收线行程、工作张力和抓取性能需由工艺样条及实测确定。

## 2. 文献结论、计算值与工程假设

### 2.1 原论文能够直接支持的结论

Wang 等人的 SpiRobs 论文报告了一种 1 m 三缆样机：软端/基部直径约 5/120 mm，42 个离散单元，三根腱线沿周向均匀分布，中心弹性轴厚度为 10%；样机因超出打印机工作空间而分为四段，并用燕尾连接。论文使用 TPU 95A，并展示了三缆样机沿物体表面展开、缠绕和抓取的行为。这些信息支持机构路线，但不能直接证明本设计 550 mm TPU 样机的负载能力或制造质量。

原论文给出对数螺旋关系 `r(θ)=a·exp(bθ)`、相邻单元比例 `β=exp(b·Δθ)`，并说明螺旋几何、锥度和可变形性彼此耦合。论文的三缆样机与双缆抓取演示应分开看待，不能将双缆实验中的负载成绩直接当作本机性能。

### 2.2 550 mm 几何初算与整数单元审查

以下估算令名义中心线长度 `L=550 mm`、基部直径 `D_b=68 mm`，并采用理想锥体近似：

`φ = 2·atan((D_b − D_t)/(2L))`

再用论文的螺旋参数—锥角关系反求 `b`：

`φ = 2·atan(b·tanh(πb)/sqrt(1+b²))`

| 软端直径 `D_t` | 连续模型锥角 `φ` | 连续模型 `b` | 连续等效单元数 | 整数候选单元数 |
|---:|---:|---:|---:|---:|
| 5 mm | 约 6.56° | 约 0.139924 | 35.625 | 35 或 36 |
| 7 mm | 约 6.35° | 约 0.137524 | 31.574 | 31 或 32 |

连续公式的等效单元数不能四舍五入后直接当作离散模型尺寸。追加审查按原论文理想中心线公式，为四组整数单元候选重新求得以下输入。第一轮固定 `p=0.5` 和 `Δθ=30°`，将它们作为 Blender 建模种子：

| 候选 | 尖端目标 | 单元数 `N` | `a` (mm) | `b` | `theta_max_pi` 起始值 | 理论尖端直径 | 理论长度 / 基部直径 |
|---|---:|---:|---:|---:|---:|---:|---:|
| A35 | 5 mm | 35 | 3.74959 | 0.139608 | 7.9 | 5.265 mm | 550 mm / 68 mm |
| A36 | 5 mm | 36 | 3.43438 | 0.140105 | 8.0 | 4.848 mm | 550 mm / 68 mm |
| B31 | 7 mm | 31 | 5.37465 | 0.137107 | 7.3 | 7.345 mm | 550 mm / 68 mm |
| B32 | 7 mm | 32 | 4.90484 | 0.137820 | 7.4 | 6.755 mm | 550 mm / 68 mm |

用原论文的理论式 `D_tip=a·(e^(2πb)−1)`、`D_base=D_tip·e^(bNΔθ)` 和中心线弧长式复核，四组参数在表中精度下均给出约 550 mm 长度、68 mm 基部直径和表列尖端直径。这是理论计算，不是 Blender 网格测量或打印结果；实际模型必须逐项重新测量，并按几何公差判断是否通过。

在仓库当前 `DesignTool.py` 中，`theta_end=π·theta_max_pi`，有效截止角为 `theta_end−2π`；`Δθ=30°` 时，正常采样下单元数关系为：

`N = floor(6·(theta_max_pi − 2))`

因此 `theta_max_pi=7.3` 或 `7.33` 生成 31 个单元，`7.4` 生成 32 个，`7.9` 生成 35 个，`8.0` 生成 36 个。每个候选都要导出并核对实际单元数，避免浮点边界和轮廓裁切造成偏差。

上表 A35/A36/B31/B32 是理想理论种子，不等于当前实际候选 JSON。为使本地离散轮廓满足目标，已将 `p=0.5`、`Δθ=30°` 固定，并对 `a,b,N` 作本地轮廓拟合；Blender 实测如下：

| 实际候选 | 目标尖端 | 单元数 | `a` (mm) | `b` | `theta_max_pi` | 实测尖端 (mm) | 基部×高度 (mm) | 估算最小壁厚 (mm) | 结论 |
|---|---:|---:|---:|---:|---:|---:|---:|---:|---|
| A36 | 5 mm | 36 | 3.77948 | 0.139610 | 8.00000 | 5.564 | 68×550.026 | 0.48 | 尖端超 ±0.5 mm，且薄壁较弱 |
| A37 | 5 mm | 37 | 3.45919 | 0.140130 | 8.25000 | 5.355 | 68×550.027 | 0.39 | 尺寸通过，壁厚低于 0.8 mm 目标 |
| B32 | 7 mm | 32 | 5.43678 | 0.136990 | 7.40000 | 7.359 | 68×550.014 | 0.80 | **首轮打印候选；尺寸/网格通过** |
| B33 | 7 mm | 33 | 4.95625 | 0.137740 | 7.58333 | 6.764 | 68×550.001 | 0.79 | 尺寸通过，壁厚略低于 0.8 mm 目标 |

上述壁厚为解析截面估算，不能替代打印工艺试验。首轮主体 STL 使用 B32 `cut_off`（关闭额外第三腱切除构造），外壳最小几何厚度目标为 0.8 mm。B32 理论 100% 实体质量约 840.6 g（按 1200 kg/m³ 假设密度）；这不是切片质量，禁止乘填充率估算实物质量。

第一阶段实际使用 A36/A37/B32/B33 四份 JSON。不得直接使用工具默认 `a=4.95 mm`、`b=0.1764` 或 `theta_max_pi=6.0`。

候选 5 mm 和 7 mm 软端需比较小物体缠绕能力与制造强度。若 5 mm 方案不能满足孔边或弹性轴最小实体厚度要求，优先评估 7 mm 方案和局部低轮廓加强，不直接把软端扩大为 10–12 mm 刚性端帽。

### 2.3 弹性轴与现有生成器的差异

原论文给三缆结构的弹性层厚度参考为单元局部宽度的约 10%，即检查 `s(θ)/d(θ)`。现有 `DesignTool.py` 的 `elastic_percent` 参与弹性轮廓角度计算：

`elastic_angle = (elastic_percent / 100) · (taper_angle / 2)`

所以将工具值设成 10 并不能证明生成实体满足论文的 10% 厚度比。CAD 必须在多个代表性单元截面上报告局部弹性厚度、单元宽度和比值；还要检查末端实际最薄处的绝对厚度、层间受力方向和打印疲劳风险。最小可制造厚度由供应商工艺样条确定，不能只靠比例缩放。

### 2.4 三腱通道与最小剩余材料

孔径 1.2 mm、软端 5 mm、孔中心半径约 1.25 mm 时，简单圆截面估算的外侧名义材料约 0.65 mm；这只是示意估算，实际结果须用各截面 CAD 截面计算。每个截面至少报告：

- 腱孔到外表面的最小壁厚；
- 腱孔到弹性轴的最小距离；
- 腱孔之间的最小实体宽度；
- 生成的螺旋缺口、斜截面及末端锚固对壁厚的影响；
- 完全卷曲和代表性三维弯曲状态下是否出现孔边碰撞、挤压或夹线。

通道在直臂状态下连通，不足以证明卷曲时不会卡线。最小壁厚阈值由短段样条、外包工艺和静态拉伸/循环试验共同确定。

### 2.5 Blender 模型和三缆模式参数追踪

Blender 是本方案三维建模、装配、网格检查和 STL 导出的主环境；本机使用 Blender 5.2.2 LTS。设计参数以版本化 JSON 为输入，Blender Python 脚本据此生成模型。阶段 A 已生成四组主体候选，首轮机械包以 B32 为主，另含独立刚性底板、轴承座、线轮、C610 托架、导向轮支架、末端锚固件和工艺短样。现有 OpenSpiRobs 生成器只用于公式与数据交叉核对，不替代本地 Blender 主模型。

参数 JSON 使用明确带后缀的单位字段：长度用 `_mm`，角度用 `_deg`，孔位置及切除比例用 `_pct`，质量用 `_kg`，腱线行程用 `_mm`。例如 `tip_hole_pos_pct: 50.0` 表示 50%，只在生成器入口转换为归一化小数 0.5；内部统一用无量纲小数，禁止同名字段跨模块分别表示百分数和小数。每个候选还记录 `p=0.5`、`delta_theta_deg=30`、整数单元数、`two_cable=false`、派生 `cable_count=3`、`tip_hole_diameter_mm`、`base_hole_diameter_mm`、`tip_hole_pos_pct`、`base_hole_pos_pct`、`cone_angle1_deg`、`cone_angle2_deg`、`cable3_cut_enabled`、`cable3_cut_pos_pct`、`cable3_cut_size_pct`、弹性层参数、坐标轴、单位制和脚本版本。

本地工作目录没有 `.git` 元数据，不能声称有本地 Git 提交号。生成清单需记录本地关键源文件的 SHA-256、Blender 版本和 Blender 生成脚本版本；当前上游 `main` 参考提交为 `f563e69f292a6b8cac1946dc45ad9e60d8795391`。本地副本与该上游版本存在差异，必须分别记录，不能将上游提交号冒充本地版本号。`cone_angle1_deg/2_deg` 是三维切割参数，与整体螺旋锥角 `φ` 分开记录；当前本地代码三缆额外切除默认启用、`cable3_cut_size_pct` 默认 14%，第一阶段比较开/关两种结果并检查薄弱截面。

本地 `DesignTool.py` 未找到 `teardrop_holes`，而记录的上游版本含该字段且默认 `false`。上游另有 `num_cables` 字段；本地副本没有，且 `cable3_cut_pos` 的本地/上游默认值分别是 25%/0%。首打样 STL 使用 `cut_off` 变体，不含额外第三腱切除，参数清单注明版本差异，避免误用上游功能。

坐标和单位约定为：Blender 场景及 JSON 的几何坐标使用 mm，STL 按 mm 坐标导出；STL 重新导入 Blender 后，三轴包围盒相对导出前误差不超过 0.1 mm。MuJoCo 等 SI 模型将 mm 转为 m（乘 `0.001`），例如 550 mm 必须成为 0.550 m；质量使用 kg、转动惯量使用 kg·m²、腱线行程用 mm 记录并在写入 SI 模型时转换为 m。所有转换需由自动检查报告覆盖。

## 3. 三缆驱动、行程和力的闭环

### 3.1 M2006/C610 接口

每根腱线对应一台 M2006 和一块 C610，电源标称 24 V，CAN 速率按官方资料配置。M2006 规格页给出 6 mm D 形输出轴、36:1 减速比和 1 N·m 持续最大扭矩；输出轴不应承受较大轴向力。线轮前设置导向轮或轴承支承，使腱线偏转产生的载荷由刚性机架承担。电机编码器为转子端增量式传感器，软件位置控制需在启动时校准参考位置。

C610 的电流/力矩指令本身不构成上层速度闭环。上位控制器要限制电流和速度，并处理 CAN 失联超时、软件行程限制、卡线/松线、过流与急停释放。编码器角度只代表电机侧转动，不代表腱线张力或软臂末端姿态。

工作张力采用分级边界管理：电机侧理论张力、腱线实测允许张力、TPU 弹性连接/孔壁实测允许张力、系统正常工作张力和软件限值分别记录；软件上限不得超过已验证的正常工作范围。在腱线、锚固和 TPU 结构强度尚未由样件试验确定前，只允许低速、低电流调试，并串接物理测力计/拉力传感器逐根监测，不根据电机理论扭矩设置工作张力。

### 3.2 可换线轮的理论上限与行程

忽略损耗时，线轮理论张力 `T=τ/r`，每转收线量为 `Δl=2πr`。按电机 1 N·m 持续最大扭矩估算：

| 有效半径 | 理想张力上限 | 每转收线量 |
|---:|---:|---:|
| 6.5 mm（当前首打样线轮） | 约 154 N | 40.8 mm |
| 8 mm | 125 N | 50.3 mm |
| 10 mm | 100 N | 62.8 mm |
| 12 mm | 83.3 N | 75.4 mm |

这些是理想传动上限，不是工作张力或 TPU 安全张力。当前线轮为有效半径约 6.5 mm、单层 10 圈，几何收线容量约 408.4 mm；B32 直臂 CAD 腱线路径约 550.765 mm。最大弯曲时三根路径差值尚未由运动学模型求出，不能把线槽总容量当作工作行程。正式工作限值须由电机指令—实测线张力标定、腱线强度、锚固强度、摩擦、弹性恢复力和温升共同确定。100 g 物体在水平伸臂、距基部 550 mm 的简化静态重力矩约为 0.54 N·m，尚未计入软臂自重、运动惯性、接触几何和摩擦；它不能直接换算成单根腱线的力。

### 3.3 必须计算的腱线行程

要确定工作行程，对三根腱线分别计算直臂、最大允许卷曲、典型平面弯曲和典型三维弯曲状态下的路径长度：

`Δl_i(q)=l_i(straight)−l_i(q)`

当前直臂通道中心路径和线轮容量已按 CAD 报告。最大允许弯曲下的路径差、收放量、线轮转数 `n_i=Δl_i/(2πr_eff)` 和电机转角仍待建立运动学/接触模型及实测；路径长度必须考虑弯曲接触和潜在松线，不能只用“每个单元乘一个理论弧长”替代 CAD 路径检查。

### 3.4 初步运动分配与抓取动作

三根腱线均匀布置并不自动等同于三个独立可控的末端转动自由度。V2 将系统描述为三路腱线输入的欠驱动三维连续体软臂。不同输入可能产生平面弯曲、空间弯曲或扭转；可控运动模式、扭转刚度和重复精度需运动学建模及实验辨识。

低速方向性控制可先试验简化张力分配：

`T_i = T_0 + A·cos(φ_i − ψ)`, 且 `T_i ≥ 0`

其中 `φ_i` 为三根腱线安装角（0°、120°、240°），`ψ` 为目标弯曲方向，`T_0` 为共同预张力，`A` 为差动幅度。这是标定起点，不是完整逆运动学。抓取动作可参考“预卷曲—伸展接近—沿物体表面缠绕—增张力保持”的阶段，但原论文这套完整定量策略是双缆实验；本机需建立并验证三缆三维状态机，不直接复用双缆张力曲线。

## 4. 打印、锚固与摩擦

### 4.1 主体一体式与分段备选

550 mm 一体式主体已作为首打样路线输出。送厂前要求供应商确认有效成型高度≥560 mm、TPU 长件的变形稳定性、打印方向和内部孔道质量；若无法稳定一体打印，需另开分段设计，不得直接拿 `splitter_generator.py` 的裁切结果当作可装配接头。

### 4.2 外包工艺记录

由外包厂针对选定 TPU 95A 品牌和结构提供可行工艺，并记录：品牌/型号/批次、喷嘴直径、层高、壁数、填充方式与比例、打印方向、干燥与送丝方式、实测关键尺寸、孔道通畅度及穿线摩擦。2026 年小型 SpiRob 研究中记录的 0.2 mm 层高、30% 填充、220°C 喷嘴和 60°C 热床只能作为该研究的工艺记录，不能直接指定给本机 550 mm 结构。

正式打印前先做局部工艺样条，包含 5/7 mm 软端、弹性轴、三腱孔和一个锚固节点；测量尺寸、拉伸/循环损伤、孔道摩擦和通线情况。若供应商不能稳定打印一体件，再冻结分段版本。

### 4.3 低轮廓腱线锚固

首打样取消 10–12 mm 实心端帽，改用外径约 9.6 mm 的低轮廓可拆式末端锚固帽，三根 0.5 mm 腱线分别穿过锚固孔。STL 已生成，但腱线打结、端帽配合和弯曲干涉仍要用工艺样条检查。基座电机和线轮载荷由独立刚性件承受，TPU 法兰通过三个 M3 螺钉与底板连接。

### 4.4 区分外部和内部摩擦

外部电机到基部的导向路径应减少且稳定可控的摩擦。内部腱线与螺旋单元孔壁的摩擦可能影响逐段展开和运动轨迹，因此先测量线力、位移和形态滞后，再决定是否改变孔道材料或增加衬管；不在首版全长腱道默认加入 PTFE 内衬，以免改变原结构的摩擦行为。

## 5. 仿真、测量与安全

- 现有 XML 生成器默认 `gravity="0 0 0"`。若做自重验证，必须设置与模型坐标一致的重力向量；至少比较零重力、水平安装自重和不同腱线张力三类工况。
- Blender 对每个候选自动报告封闭网格体积、假设 100% 实体时按 TPU 数据表密度估算的理论质量、各单元质量分布和重心；密度来源与估算不确定度一并记录。该值不代表切片打印件质量；实际打印质量使用供应商切片器报价或实物称量，不得将理论质量直接乘以填充率。实验比较垂直悬挂、水平伸出及弯曲状态的自重下垂。
- 仿真刚度、阻尼和摩擦参数不能沿用默认值来宣称验证成功。先由短段和整臂试验辨识材料与摩擦，再用于仿真，并报告参数来源。
- 设计中为三根腱线的张力测量、软臂姿态标记/视觉记录和后续末端传感器预留接口。至少在标定时能够逐根测量拉索张力；整臂测试记录姿态、位移、回弹、滞后和自重下垂。
- 三块电调与线轮设置防护罩，电源设总断开和支路保护；软件包含上电校准、速度/行程限制、通信超时、过流/卡线处理和可恢复的急停逻辑。

## 6. 验证里程碑与验收输出

| 阶段 | 工作内容 | 记录/验收输出 |
|---|---|---|
| A. Blender 几何候选冻结 | **已完成**：使用 A36/A37/B32/B33 本地离散轮廓参数；首打样选 B32 `cut_off` | 四候选生成/验证完成；B32 实测 550.014×68×7.359 mm、32 单元、三腱道贯通、CAD/STL 网格闭合；估算最小壁厚 0.80 mm。报告位于本机工作区 `local/spiral-soft-arm/stage-a/` |
| A2. 打印前机械装配包 | **已完成 CAD**：三电机 radial drive、支承轴/轴承、单层线轮、导向轮、C610 托架和低轮廓末端锚固 | Blender `.blend`、10 个 STL（含两种工艺短样）、中文 BOM/打印/装配调试文件、装配图和 STL 往返闭合检查；C610 及电机为简化外形包络，购买后仍要试装 |
| B. 打印工艺样条 | 打印末端、薄弹性区、三腱孔和锚固样段 | 实测尺寸和供应商工艺记录；孔道可全程穿线且不堵塞；测量穿线力、张力/位移、循环后裂纹/磨损和残余变形。打印尺寸公差及最小可制造壁厚依据样条确定 |
| C. 腱线与结构测试 | 静态拉伸、逐步卷曲和重复循环 | 张力—位移曲线、磨损/卡线情况、回弹与失效位置 |
| D. 驱动验证 | 逐个标定线轮、归零、限速限力、测试急停与失联 | 电流/力矩指令—腱线张力、行程、保护动作和温升记录 |
| E. 整臂形态测试 | 无载三维弯曲、水平自重下垂、重复弯曲 | 标记点轨迹、重复定位误差、姿态滞后、回弹和自重变形；重复试验先统一测量方法，再用样机基线确定性能阈值 |
| F. 抓取试验 | 对候选物体尺寸与形状逐级测试 | 每种条件记录物体质量/尺寸/表面、尝试次数、成功率、保持时间、滑移和失效模式 |

首轮物体矩阵建议包含直径 20、40、60 mm 圆柱体，直径 40–60 mm 球体，以及后续选定的不规则物；各物体尽量不超过约 100 g。每个测试条件可先做 10 次抓取，并记录是否保持 10 s、成功次数和失败模式。这是实验方法建议，不代表机械臂已具有该工作范围或性能。短段循环次数与允许残余形变需在样条阶段定义为筛查指标，不把筛查结果表述为寿命保证。整臂自重下垂试验应先于抓取实验。

## 7. 建模与制造交付物

阶段 A 与打印前机械包已交付至 `local/spiral-soft-arm/preprint/v1/`：

- Blender Python 参数化生成脚本、版本化候选参数 JSON，以及可编辑 `.blend` 场景；
- 四份独立 JSON、记录本地文件哈希和上游参考提交的版本清单；
- A36/A37/B32/B33 四组主体 `.blend`/STL 和报告；首打样包含 B32 主体、刚性机械件、末端锚固件以及 tip/base 两个 80 mm TPU 工艺短样 STL；全部已导出零件重导入后均为闭合单体，尺寸回读与清单一致；
- 可编辑整机 `.blend`、总装预览、底部传动细节图、中文验收报告、BOM、打印说明和装配/低电流调试流程；
- 已打包为 `local/spiral-soft-arm/preprint/B32_打印前交付包_v1.zip`，含 10 个 STL、可编辑 Blender 场景、冻结参数、源文件哈希和全部中文制造资料；压缩包完整性与内部文件数已核对；
- Blender 场景和 STL 均按 mm；B32 主体高度回读 550.0136 mm；MuJoCo XML、控制固件、MuJoCo 动力学和实际切片质量估算尚未包含。

### 实物打印后阶段

打印前 CAD 机械包已生成；实物打印后再修订尺寸配合并开展 TPU 性能验证。控制固件、三路 CAN 电流/位置控制、MuJoCo 动力学模型及 STEP/3MF 制造交付不在本轮包内。Blender 5.2.2 当前默认有 STL 导出操作，不把 STL 改扩展名冒充 STEP/3MF；STEP 如需要需使用专用 CAD 工具并与 Blender 尺寸核对，3MF 可由外包厂按实际设备生成。

阶段 A 几何和打印前机械包均在用户本机 `D:\SteamLibrary\steamapps\common\Blender\blender.exe` 执行。生成脚本及测试已保存在 `design-tool/blender/`；外包下单前按交付包中的验收清单让供应商确认成型空间与切片保持所有薄壁和通道。

## 8. 风险与边界

- `a,b,Δθ,theta_max` 联立影响锥度、软端/基部尺寸、单元数和弯曲包络；当前固定 `p=0.5` 与 `Δθ=30°`，若改变 `p`，须重新推导对应几何公式并作为独立研究变量。
- 5 mm 软端可能让孔边和弹性连接过薄；7 mm 可能牺牲小物体缠绕范围。通过两套候选、逐截面检查和样条打印再选。
- 当前 6.5 mm 线轮对应的理想电机最大扭矩线拉力约 154 N，远高于未知的 TPU/腱线安全值；必须用测力计校准，不能按电机最大扭矩运行。
- 一体式长 TPU 打印依赖供应商设备和工艺，须保留模块化备选。
- 三缆摩擦、重力和材料滞后会使电机侧角度不能直接预测末端形状；需进行形态和张力测量。
- Blender 可提供可复现的建模、网格和质量属性报告，但本身不能验证 TPU 的材料强度、摩擦、疲劳寿命或实际抓取能力。
- 仓库 `hardware/` 当前没有电机座/线轮 CAD；已有 `splitter_generator.py` 不负责生成接头。
- 仓库设计工具声明 PolyForm Noncommercial 1.0.0。样机研究使用前仍应保留许可证要求；商业使用或分发前需另行核对许可。

## 9. 参考资料

1. Z. Wang, N. M. Freris, X. Wei, “SpiRobs: Logarithmic spiral-shaped robots for versatile grasping across scales,” *Device*, 3(4), 100646, 2025. [DOI 页面](https://doi.org/10.1016/j.device.2024.100646)，并见本地论文 PDF。用于螺旋方程、锥角关系、三缆 1 m 样机、弹性轴和抓取动作依据。
2. H. Huang et al., “Grasping by spiraling: reproducing elephant movements with rigid-soft robot synergy,” *npj Robotics*, 3, 18, 2025. [DOI 页面](https://doi.org/10.1038/s44182-025-00038-z)。可参考前向运动学、重力姿态与形态测量；其机器人/复合刚柔平台和模型假设与本机不同。
3. Z. Wang, N. M. Freris, “Exploiting Frictional Effects to Reproduce Octopus-Like Reaching Movements with a Cable-Driven Spiral Robot,” RoboSoft 2024. [OpenReview 页面](https://openreview.net/forum?id=Y3Yb366MEH)。用于理解腱线—结构摩擦、张力分布及分阶段运动；其研究对象以双缆行为为主。
4. M. Ramalho, L. Silva, “Kinematic Modeling of a Tendon-Driven Soft Spiral Manipulator,” CBA preprint, 2026-10-05. [会议论文页面](https://ojs.sba.org.br/index.php/cba/article/view/6261)。其 20 段 PVC 样机报告较大的仿真—实物位置差异，只作为建模误差提醒，不向 TPU 结构转移误差数值。
5. P. Cavadas, “Characterization of Deformation and Pressure Fields in SpiRob Soft Grippers for Delicate Manipulation,” *Engineering Proceedings*, 145(1), 9, 2026. [论文页面](https://www.mdpi.com/2673-4591/145/1/9)。该研究的材料、尺寸、线材和打印机与本机不同；其打印参数只作为制造记录案例，不作为本机默认设置。
6. D. Sanin-Villa, V. Botero-Gómez, A. F. Martínez Pérez, “Contact-Aware Predictive Control of a Logarithmic-Spiral Soft Gripper: A Control-Oriented Reduced-Order Numerical Study,” *Robotics*, 15(8), 153, 2026. [DOI 页面](https://doi.org/10.3390/robotics15080153)。该研究明确为降阶数值研究，不视为真实样机的实验验证。
7. DJI RoboMaster [M2006 动力系统官方规格](https://www.robomaster.com/zh-CN/products/components/general/M2006)。用于电机轴、供电、扭矩、C610 通信和轴向载荷边界。
8. 本地 Open-Spiral-Robots 仓库：`design-tool/DesignTool.py`、`design-tool/xml_generator.py`、`design-tool/README.md`、`fabrication/README.md` 与根目录 `LICENSE`。
