songgagav/spiral_soft_arm/docs/superpowers/specs/2026-10-11-b32-paper-physical-simulation-design.md

# B32 论文式三缆软臂物理仿真与打印前复核设计

## 目标

以 Wang 等人的 SpiRobs 三缆构形作为打印几何基线，修正旧卷曲预览，并增加可复现的驱动仿真。用户要求的三轴机构在本设计中解释为三根相隔 120° 的腱索输入，不宣称三个独立末端自由度。

## 采用的模型

- 打印实体：沿用 B32、550 mm、32 个离散螺旋单元、三腱孔和中央弹性轴的一体 TPU 95A 实体；刚性底座和电机支架另件打印。
- 仿真实体：32 个刚体计算单元，用三维转动弹簧—阻尼关节等效中央弹性轴，三根空间腱索通过各单元的导向点连接末端锚点并由独立执行器拉动。
- 渲染：仅从仿真求得的单元姿态生成直立与受力姿态图。禁止沿理想对数螺旋中心线直接摆放零件并称为物理结果；不使用 Blender。
- 输出：SolidWorks 可导入的中性 STEP 保持为未受力打印实体；卷曲姿态图和仿真结果明确标为计算姿态，不作为打印 STL。

## 物理边界

当前没有该批次 TPU 95A 的打印后应力—应变曲线、滞回、线缆摩擦或锚点强度数据。仿真须把关节刚度、阻尼、腱索力和接触摩擦作为显式假设，并做参数范围敏感性分析；不能据此认证强度、疲劳寿命或 100 g 抓取能力。几何无碰撞结论仅对仿真碰撞代理有效，需另外对 STL 网格做尺寸、闭合和局部壁厚检查。

## 验收

1. MuJoCo 模型可加载，包含 32 个单元、31 个柔顺关节、3 条独立腱索和 SI 单位重力。
2. 三个单缆驱动方向均可复现，数值积分稳定；腱索长度随收线单调减小。
3. 记录模型输入、软件版本、关节刚度/阻尼、控制力、每步状态、接触及几何检查结果。
4. 渲染图能清楚对照未驱动直臂和至少一个受力卷曲姿态，且不把理论姿态冒充仿真。
5. 更新中文打印说明和机器可读清单；旧 Blender/刚体摆位文件标为历史无效文件，新的仿真渲染不能放进打印 STL 清单。

## 已查明的旧问题

旧刚体摆位代码直接将各段对齐到解析中心线，没有计算腱索力、关节弹性、材料恢复或接触，因此出现穿模。论文式 STEP 是单一未受力实体，只有几何闭合检查，没有仿真。当前 STEP 回读尺寸也记录为 66.656 × 59.500 × 550.014 mm，不能把三向切削前 68 mm 的目标值写作最终实测尺寸；打印前复核必须分别报告三轴包围盒和径向外接直径。
