songgagav/spiral_soft_arm/docs/superpowers/specs/2026-10-11-b32-underwater-simulation-design.md

# B32 三缆软臂水下仿真与参数推导规格

**状态：** 待用户审阅  
**日期：** 2026-10-11  
**范围：** MuJoCo 水下运动仿真、B32 参数复核与 v3 推导论文

## 1. 目标

在现有 B32 三缆软臂模型上加入静水浮力、流体阻力、目标物浮力，以及有扭矩和行程约束的电机—线轮驱动。覆盖淡水/海水和 1 m/5 m 四种环境标签，复核并筛选一组满足几何、仿真任务和驱动边界的参数。保存可复现的输入、结果、参数表和中文论文。

仿真引擎采用 MuJoCo。其多刚体、关节、腱索和执行器机制可以表示本任务；浮力由每个刚体的排水体积显式计算并施加，流体阻力使用 MuJoCo 的现象学流体力模型。仿真不是连续体 TPU 有限元，也不包含压力舱结构校核、密封结构验证或渗漏试验。

## 2. 已知基线与待复核参数

| 参数 | B32 当前基线 | 说明 |
|---|---:|---|
| 对数螺旋初始半径 `a` | 5.436777 mm | 本地离散轮廓拟合参数；连续理论参数不可直接代替 |
| 螺旋增长系数 `b` | 0.136990 | 无量纲；中心线按 `ρc(θ)=ac·exp(bθ)` |
| 每单元角步长 `Δθ` | 30° = π/6 | 32 单元 |
| 总离散角跨度 | 16π/3 = 5.333π | `N·Δθ`，约 2.667 圈 |
| `theta_max_pi` | 7.4π | 生成器截止参数，不是总离散圈数 |
| 螺距/剖面形状参数 `p` | 0.5 | 项目代码用 `c=(1-p)+p·exp(2πb)` 插值构造中心螺旋尺度；它控制单元剖面形状，不是标准螺纹的轴向螺距 |
| 单元数、主体高度 | 32；550.014 mm | 来自 B32 打印实体/仿真配置 |
| 主体体积 | 357146.451 mm³ = 0.357146 L | 网格名义体积；按 TPU 1200 kg/m³ 估算主体质量 0.428576 kg |
| 弹性层 | 开启，占比 10% | 几何基线；仿真用中央锥形弹性轴等效为关节柔顺性 |
| 尖端腱孔 | 半径位置 50%；孔径 1.2 mm | 位置百分比相对局部半径，沿用 CAD 定义 |
| 根部腱孔 | 半径位置 90%；孔径 3.0 mm | 同上 |
| 缆绳数 | 3 | 方位角 0°、120°、240° |
| 第三缆局部切割 | 开启；轴向位置 25%；尺寸 14% | 沿用 B32 参数；几何变化后重新做壁厚/碰撞代理检查 |
| 关节刚度、阻尼 | 由 TPU 名义参数推导，逐关节输出 | 当前 E=33.6 MPa、ν=0.49、阻尼比 ζ=0.8 均非本批打印件实测值 |

连续对数螺旋参数和本地裁切实体尺寸采用不同测量定义。参数推导须同时记录连续解、离散拟合解和打印网格读数，不得把三者混作同一组“实测值”。对任一候选，保存每个关节的弯曲/扭转刚度和阻尼，而不只给单一平均值。当前候选关节刚度模型沿用 `k=Eπr⁴/(4L_eff)`；扭转刚度沿用各向同性近似 `GJ/L_eff`、`G=E/[2(1+ν)]`，阻尼按约化惯量和指定阻尼比计算。上述关系是模型假设，待打印 TPU 试片标定。

## 3. 水体和深度工况

以 20°C、静水、淡水/典型海水作为名义对照。海水采用标准海洋盐度附近的代表值，实际海域的温度、盐度和压力会改变物性，必须在配置中可替换。

| 工况 | 密度 `ρ` | 动力黏度 `μ` | 表压 `p=ρgh`，`g=9.81 m/s²` |
|---|---:|---:|---:|
| 淡水，1 m | 998.2 kg/m³ | 1.002 mPa·s | 9.79 kPa |
| 淡水，5 m | 998.2 kg/m³ | 1.002 mPa·s | 48.96 kPa |
| 海水，1 m | 1025 kg/m³ | 1.08 mPa·s | 10.05 kPa |
| 海水，5 m | 1025 kg/m³ | 1.08 mPa·s | 50.28 kPa |

对每个运动刚体按从网格获得的体积 `V_i` 施加 `F_b,i=ρgV_i`，方向竖直向上；刚体重力按其材料质量计算。目标球使用 40 mm 直径、100 g 质量的现有 v2 基线，按球体积单独施加浮力。该球体完全浸没时，淡水名义表观重量约 0.65 N，海水约 0.64 N。

主体总量只作初步核算：0.357146 L、TPU 密度 1200 kg/m³ 时质量约 0.4286 kg；淡水浮力约 3.50 N、净向下约 0.71 N；海水浮力约 3.59 N、净向下约 0.61 N。实现阶段必须从各仿真刚体网格重算质量和排水体积，核对分配总和与 STL 总体积一致。

5 m 表压作为工况元数据和报告值记录。对于当前不可压缩刚体近似，深度不会直接改变浮力；因此同一水体在 1 m 与 5 m 的运动差异预计为数值噪声范围。仿真显式比较该预期。均匀静压导致的壳体应力、软臂压缩/渗水、密封腔进水、材料随压力变化等均不在 MuJoCo 模型范围内，必须另做压力舱结构校核和渗漏试验。

## 4. 流体阻力和接触

- 设定 MuJoCo 流体密度和黏度，开启其椭球/惯量近似的现象学阻力与黏性阻力；采用适用于阻尼系统的隐式积分选项，并记录 MuJoCo 版本和实际求解器设置。
- 给细长各段和目标球设置合理的流体形状代理。保存代理尺寸/惯量与源网格的对应关系；不得将结果描述为高保真 CFD。
- 对流体系数、流速（名义静水为 0）、材料刚度和阻尼执行敏感性分析。名义模型以静水为主，不把未测海流悄悄并入结果。
- 保持目标球/软臂的接触几何、摩擦系数和初始条件明确，并对摩擦系数做范围扫描。目标球/支架和软臂间接触须可从日志区分。

## 5. 电机、线轮和缆索边界

沿用项目中的 3 × RoboMaster M2006 P36 + C610 作为驱动候选，不声称电机组件可直接浸水。仿真默认电机和控制器位于干燥密封舱，外部仅有线轮、腱索和软臂；密封舱的水压设计不在范围内。

- 每路驱动建立线轮转动自由度，模型控制量为线轮轴扭矩。使用官方规格中的 1 N·m 连续最大扭矩作为绝对扭矩上限，并以官方空载转速和 1 N·m 负载转速构造可配置的近似转矩—转速包络；标注其是简化规格包络，不是实际控制器电流闭环模型。
- 基准有效线轮半径取已有设计的 6.5 mm，基准单层 10 圈，行程 `0…20π rad`，理论收放线长度 `2πr·10≈0.408 m`。行程通过关节限位实施；需要给出缆索张力、卷线角、剩余行程和限位触发时间序列。
- 线轮扭矩产生的理论腱力为 `F=τ/r`；1 N·m / 6.5 mm 约 154 N，远高于既有 0.15 N 理想力执行器试验。不得把电机扭矩上限误当作 TPU/缆索安全张力。模型另设独立可调腱力上限，并在输出中标为未由实物拉伸/破坏试验标定。对安全张力未知的候选只可做数值筛选，不能给物理放行结论。
- 腱索长度与线轮角用可审计的约束/映射关系耦合。验证收线、放线方向、力矩符号、行程边界和三路独立性；避免只有理想恒力执行器而无卷线器约束。
- 同时输出线轮扭矩、角速度、线速度、电机包络是否限幅、张力和行程余量。初始参数不能直接转成真实 C610 电流命令，实机前需张力计与位移标定。

## 6. 参数筛选定义

B32 是目前四个打印几何候选（A36、A37、B32、B33）中唯一通过原几何筛选条件的候选，不称为全局最优。第一轮搜索在本地生成器和已有验证范围内开展：保留 3 缆、`p=0.5`、30° 离散角和 550 mm × 68 mm 尺寸目标；比较当前可复建的整数单元候选，并对 `a,b` 重新拟合；凡改变尖端/根部孔、弹性层比例或第三缆切割参数，必须重做轮廓、最小壁厚、体积及腱索通道检查。

筛选顺序：

1. 几何门槛：轴向高度 550±5.5 mm、基部参考直径 68±1 mm、尖端目标 7±0.5 mm、几何最小壁厚不小于 0.8 mm，三缆通道贯通且无网格退化。
2. 物理任务门槛：在四种水环境标签的名义模型中，从相同初始姿态完成目标球接触/保持任务；明确任务成功定义、保持时间、末端误差、目标滑脱和仿真失稳判据。
3. 驱动门槛：全过程不超过电机扭矩—转速包络、线轮角行程和单独设定的仿真张力上限；报告每个门槛的裕度。
4. 在满足以上条件的候选中，以较低峰值扭矩、张力和收线行程为优先目标；通过材料、阻尼、摩擦与流体阻力敏感性分析排序。如果没有候选达到全部门槛，结论须是“当前搜索范围内无可行解”，不得人为挑选为最佳。

任务默认沿用 v2 的 40 mm / 100 g 目标球、2 s 时长和目标位姿。若具体目标物密度、尺寸、抓取方向或最低保持时间与 v2 假设不符，需在最终论文中把当前结果标作该基准工况，而不能外推。

## 7. 实施交付物

实施获批后，保留 v1/v2 历史，在下列位置添加独立 v3 结果：

- `local/spiral-soft-arm/simulation/v2/`：可生成/加载的 MuJoCo 模型、四工况配置、运行脚本、每步 CSV/JSON、参数敏感性与约束检查报告。
- `local/spiral-soft-arm/preprint/v3/`：中文参数推导与水下仿真论文 `.docx`、可审阅 Markdown、机器可读最终参数表和图表；论文写明仿真与实物试验边界、软件版本、输入散列/来源和参考文献。
- `docs/superpowers/plans/`：规格审阅通过后再添加实施计划。

最终参数表必须逐项回答：初始半径、增长系数、每单元角步长、总圈数（同时列 `N·Δθ/π` 与生成器截止 `theta_max_pi`）、螺距相关参数、是否启用弹性层及其占比、尖端/根部孔位置和孔径、缆绳数量、每个关节的刚度和阻尼、第三缆切割位置和尺寸、电机转矩限制、线轮半径及最大行程、淡水/海水 1 m/5 m 的工况结果。

## 8. 验收

1. 模型与配置可在固定 MuJoCo 版本下加载，四种环境都能自动运行并留下输入配置、每步状态和摘要结果。
2. 逐段浮力、目标物浮力、重力、拖曳与网格体积/质量守恒检查通过；浮力总和能由 `ρgV` 独立复算。
3. 三路线轮均有有界扭矩和 10 圈行程，腱索收放方向正确；触发任何扭矩/速度/张力/行程限制时日志指出对应通道和时间。
4. 同一水体 1 m/5 m 的运动结果相符，除非输入显式引入与压力相关的模型；淡水/海水差异可由物性变化解释。
5. 最终结论将现有筛选候选和新搜索得到的候选区别开，报告最佳可行候选的适用搜索范围；不将数值可行性称作打印强度、寿命、密封或实机抓取认证。
6. 论文与图表完成文档渲染检查；可复算公式和参数有单位、来源和不确定性说明。

## 9. 数据与参考依据

- 本地冻结基线：`local/spiral-soft-arm/preprint/v1/B32参数.json`、`三缆软臂参数推导论文.md`，以及 `local/spiral-soft-arm/simulation/v1/B32参数.json`。
- MuJoCo 官方流体力说明：<https://mujoco.readthedocs.io/en/3.15.0/computation/fluid.html>。其中阻力/黏性项为简化的现象学模型，不能等同于 CFD。
- MuJoCo 官方 MJCF 参考：<https://mujoco.readthedocs.io/en/latest/XMLreference.html>，用于核对关节限位、腱索、等式约束和执行器表达。
- RoboMaster M2006 官方产品页：<https://www.robomaster.com/en-US/products/components/general/M2006>；型号参数仍须以实际采购批次和电调配置核对。
- NIST 水物性参考：<https://nvlpubs.nist.gov/nistpubs/jres/048/jresv48n1p1_A1b.pdf>；淡水名义参数以约 20°C 为参考。
- 海水热物性相关式：<https://web.mit.edu/lienhard/www/Thermophysical_properties_of_seawater-DWT-16-354-2010.pdf>；海水名义盐度约 35 g/kg。
- TEOS-10 海水状态方程手册：<https://www.teos-10.org/pubs/TEOS-10_Manual.pdf>；用于说明海水密度会随盐度、温度和压力而变。
