songgagav/spiral_soft_arm/docs/superpowers/specs/2026-10-11-b32-wet-side-actuator-redesign.md

# B32 湿侧电机与水下驱动重构规格

**状态：** 已获用户批准（2026-10-11）
**日期：** 2026-10-11  
**设计决策：** 采用湿侧水下电机架构；ApisQueen 4092 减速电机作为成本优先的单台验证候选，Blue Robotics M200 作为规格资料较完整的后备候选。两者都须通过接口、载荷和驱动验证后才可冻结为最终选型。  
**依据：** 用户批准方案 C，并授权按性价比选择具体路线。

## 1. 目标

将 B32 三缆软臂的三路驱动改为湿侧水下电机，移除电机压力舱假设，重做电机座、减速传动、线轮和走缆布局，并更新 MuJoCo 模型。对淡水/海水、1 m/5 m 四种工况重新执行运动仿真。保存可复现的配置、模型、结果，以及包含电机与安装推导过程的新版中文论文。

该工作验证运动学/动力学模型和驱动边界，不构成承压结构、密封或实机性能认证。5 m 对应约 49–50 kPa 表压；MuJoCo 运动仿真不能替代压力舱结构校核或渗漏试验。

## 2. 性价比选型决策

### 2.1 成本优先样机候选：ApisQueen 4092

先评估一台 ApisQueen 4092 12–24 V 低速减速无刷电机，不直接按页面宣传采购三台。供应商页面声称其为 IP68、适用淡水和海水、标称可用于 100 m 水深，内置 50:1 减速器；页面列出 310 g、80 W、约 0–100/0–200 rpm 等数据，并提供电机单体或电机加 mini ESC 选项。页面所示价格为电机约 118.46 美元、含 ESC 约 138.46 美元；三路带 ESC 的页面价合计约 415.38 美元。供应商页当次显示缺货，价格和供货状态须在实施前复核。

此候选的成本优势来自现成低速减速组件，可能省去 M200 路线的定制减速器。现有任务的线轮目标为 8 rad/1 s，平均线轮速度约 76.4 rpm；供应商给出的 24 V 空载速度为 108 rpm，理论上有约 1.4 倍空载速度余量，但是否能在实际张力下达到目标须实测。按旧线轮半径 6.5 mm，108 rpm 对应理想线速度约 73 mm/s，8 rad/1 s 的平均收线速度约 52 mm/s。

页面数据必须视为供应商声明，不是已验证的连续工作能力。其标题出现 0–100 rpm 与 0–200 rpm 两种表述；页面“扭矩测试”列出 24 V 下 20 rpm / 4.5 N·m 至 100 rpm / 0.23 N·m，但未说明测试时长、温升、效率或连续/峰值定义。页面的 80 W 也不能替代经核实的负载曲线。供应商只说明 mini ESC 为 PWM 双向调速，未说明线轮位置闭环、输出力矩闭环或可配置电流上限；页面也没有提供可直接采用的 CAD/STEP 接口数据。该电机必须先做单台来料、尺寸、输出轴支承、转速/力矩/电流/温升及水下测试，再决定是否扩展到三路。

### 2.2 低价但高集成风险选项：F3130 SeaDrive

另记录 F3130 170 KV 水下无刷电机作为最低电机单价的台架备选：零售页价格约 35.90 美元，标称 IP68、5 m/24 h、214 g、3.17 mm 轴径和 2480–3200 rpm。它没有集成适合线轮的减速器；另需减速器、轴承支承、输出角度反馈和合适驱动。公开页面未给出可核验的连续扭矩曲线和海水腐蚀测试资料。因此它只用于做价格下界比较，不作为本规格的默认湿侧样机。

### 2.3 规格更完整的后备：Blue Robotics M200

若 ApisQueen 单台样机的负载、温升、寿命或浸水验证不合格，改用 M200 作为水下电机后备。制造商说明其为浸水式三相无刷电机，定子封装并与水隔离，转子有防腐涂层并用水润滑衬套，最大测试深度标为 300 m。规格为 7–20 V、470 RPM/V、理论堵转力矩 0.5 N·m、外形 Ø40 × 73.6 mm、空气中含 1 m 电缆质量 282 g、水中质量 217 g。理论堵转力矩不得当作连续额定力矩；M200 仍需减速器、反馈和有约束的驱动器。

按 2026-10-11 页面价格，三台 M200 约 555–585 美元；三只 Basic ESC 另约 120 美元。Basic ESC 只作为价格参照，不纳入合格的闭环力矩驱动方案：它公开为 PWM 调速器，没有给出满足本项目要求的线轮位置闭环或力矩闭环保证。M200 路线金额不含减速器、编码器、合格驱动器、电缆接头、机加工/打印、运输和税费，不能表述为整套执行器成本。

按页面单价，4092 的三路“电机+ESC”合计约 415.38 美元；M200 加 Basic ESC 的三路电机/电调合计约 675–705 美元，前者页面价约低 260–290 美元（约 39–41%），且 4092 已含 50:1 减速器，M200 尚未计入外置减速器。这是当前可查网页价对比，不是整机 BOM 报价；编码器、张力/电流约束、安装件、物流和税费尚未计入，且 4092 页面当次显示缺货。

### 2.4 完整驱动结构

- 三台通过样机验证的水下电机直接位于水体中，不为电机本体建干式压力罐。
- 4092 候选使用其集成的 50:1 减速器驱动独立腱线线轮；如选 M200，则每台另配湿侧减速器。两种路线都须按负载实测确认减速后的线轮速度和力矩，不得把电机空载转速/理论堵转力矩直接作为线轮能力。
- 每路线轮提供角度反馈。驱动器使用可限流/限矩的闭环方案，电调、控制器与电池先放在干燥电子舱，通过额定穿舱件接出电机线。控制器仍需闭环速度/位置或张力控制；湿侧电机方案不意味着未额定电气件也可浸水。
- 减速器、轴封/轴承、紧固件和接插件应适用于淡水与海水。优先评估浸水/压力平衡的机械结构；任何保留干燥空腔的部件都需单独声明耐压与密封方式。
- 以实测或制造商负载曲线构造力矩—转速—电流/热约束。经过减速比和效率映射后，对线轮轴施加连续/峰值力矩、转速、行程及温升/占空比边界；没有数据的量标成待测输入并做范围分析。

### 2.5 备选比较

保留 maxon 水下驱动作为工程集成备选。成本比较须基于含减速器、编码器、驱动器和安装件的完整 BOM 与供应商报价；不能只比较电机单价。所有候选的扭矩值须核实连续/峰值定义、测试条件和对应转速，实测曲线与样机数据未获得前不用于最终参数冻结。

## 3. 对 B32 几何和浮力的影响

沿用既有 B32 几何参数作为软臂基线：`a=5.436777 mm`、`b=0.13699`、32 单元、每单元 30°、总离散跨度 `5.333π`（约 2.667 圈）、`p=0.5`、主体长度约 550.014 mm、主体体积约 0.357146 L、弹性层开启且占比 10%、三缆、尖端孔位置/孔径 50% / 1.2 mm、根部孔位置/孔径 90% / 3.0 mm、第三缆切割位置/尺寸 25% / 14%。这些值是几何基线，不表示湿侧驱动已通过验证。

旧布局按 M2006 P36 的 Ø24.4 × 64.8 mm 占位设计，电机中心半径 55 mm、切向轴线、中心高度 z=-25 mm，不能直接沿用。底板下表面为 z=-8 mm。4092 页面没有提供可直接用于 CAD 的 STEP/接口图，必须先向供应商取得尺寸图/轴端和安装接口，或对单台样机实测，再完成三座安装、轴线和线轮接口设计。若转入 M200 后，其 Ø40 × 73.6 mm 外形在旧中心高度会与底板相交，也须重做布局。所有方案均须检查电机/减速器互相干涉、电机与底板/软臂/腱线、紧固件、电缆最小弯曲半径的间隙；不得把外廓占位描述为已验证的接口装配。

浮力模型需包括三台电机/减速器、线轮、支架、电缆可见段和软臂。4092 页面列出 310 g，但未给出对应排水体积或水中重量，先用实测外形排水体积和称重数据建模；不得把标称 310 g 当作水下表观重量。若转用 M200，则页面的空气质量/水中重量可作初始浮力代理，但也要以实物复核。B32 TPU 主体仅约 0.06–0.07 kg 净负浮力，因此必须报告完整驱动组件的整机配平，不能继续只报告裸软臂浮力。

## 4. 新版 MuJoCo 模型

保留现有 `simulation/v2`、v3 论文和 `motor_mount_v1` 作为历史基线；新工作放在 `simulation/v3`、`preprint/v4` 与 `solidworks/motor_mount_v2`，避免覆盖已交付结果。确切目录可在实施计划中拆分，但版本边界不得混用。

新 MuJoCo 模型应包括：

1. B32 的 32 个单元、31 个柔顺关节、3 条独立腱索，以及淡水/海水浮力和流体阻力。
2. 三套湿侧电机/集成减速器和线轮的质量、转动惯量、浸水排水体积与阻力代理；干侧控制器与电池留在水下压力环境模型之外，线缆穿舱点作为明确边界。按 4092 建模时使用实测数据；M200 备选模型需显式增加独立减速器。
3. 每个电机实际可用的速度/力矩/电流限制映射到线轮侧。4092 若没有可信的输出端曲线，则用实测的减速器输出曲线；M200 路线按外置减速比和效率换算。分别记录连续和峰值限制、限幅发生时刻、线轮角度、速度、剩余行程、腱线张力、估算电流和占空比。
4. 线轮有效半径与卷绕层数/有效行程。旧基线 `r=6.5 mm`、10 圈、`0…20π rad`（理论线长约 0.4084 m）作为对照输入；若新线轮结构改变，应以 CAD 和实际腱线重新定义半径、层间变化和限位。
5. 目标物质量、几何排水体积和浮力；继续输出 1 m 与 5 m 的表压元数据。未建立压力影响材料/密封的验证模型时，同一水体的 1 m/5 m 运动差异应仅来自明确声明的输入，不得人为添加压力效应。
6. 使用真实执行器约束重新运行四种水环境工况和既定抓取/保持任务，并对摩擦、材料刚度/阻尼、拖曳、电机曲线、减速效率、张力上限进行敏感性分析。若仍无候选通过任务门槛，结论继续为“当前搜索范围内无可行解”。

驱动器的控制接口按可实现的硬件闭环方式建模，禁止沿用 v2 的理想线轮力矩控制并仅替换电机名称。仿真可用经标定的电流—力矩近似，但必须公开公式、限幅和数据来源。线轮扭矩除以线轮半径得到的腱力不能当作 TPU、腱线或锚点的安全许用力；许用张力未通过拉伸/破坏试验确定前，只能用于数值敏感性分析。

## 5. CAD 与装配推导

先获取 4092 供应商尺寸/轴端资料，或对通过初测的单台样机进行尺寸测量，再重做底板下方三路减速电机安装件和线轮装配。若 4092 未通过样机验证，切换为 M200 并在 CAD 中加入外置减速器。输出参数化源文件、独立零件 STEP/STL、总装 STEP、干涉/间隙报告、零件质量与浮力核算、线缆/腱线走向图，以及与模型对应的配置快照。

布局优化次序：先确保 B32 根部固定、三路腱线从线轮到根部导向孔无交叉/磨边；再满足电机/减速器/线轮互不干涉与装配工具可达；最后控制外径、轴向长度、重心和浮心偏置。底板可在 180 mm × 8 mm 旧基线附近调整，但修改必须写明尺寸、打印/机加工方式和结构验证边界。不得只按电机外径开一个孔就判定装配完成。

## 6. 参数与筛选结果

新版参数报告必须逐项保留原用户要求的参数：对数螺旋初始半径、增长系数、单元角步长、总圈数（同时区分 `N·Δθ/π` 与 `theta_max_pi`）、螺距相关参数、弹性层开关和占比、尖端/根部孔位置和孔径、缆绳数量 3、各关节刚度与阻尼、切割位置和尺寸，并新增电机/减速器型号、安装姿态、传动比、效率、力矩/速度/电流限制、编码器和线轮行程、整机质量/排水量/净浮力。

几何候选仍按尺寸、最小壁厚、通道贯通和网格有效性筛选。物理候选须先达到定义清楚的目标接触/保持判据，再同时满足电机连续/峰值包络、转速、线轮行程、张力上限和热/占空比约束。参数排序要列出搜索空间、可行性和裕度；不可将仿真最优外推成材料强度、寿命或实物抓取认证。

## 7. 交付物

- 新版可复现 MuJoCo 输入、模型生成器、仿真运行脚本、测试、四工况 CSV/JSON、敏感性结果和约束/浮力审计。
- 新版参数化 CAD 源文件、可导入装配 STEP、打印/加工零件文件、间隙及质量/浮力报告。
- `preprint/v4` 中文推导论文 Markdown 与 DOCX，记录从旧基线到新驱动架构的筛选过程、假设、失败候选、成本比较、来源、版本和可复算数据。DOCX 需渲染并检查页面布局。
- 独立的 5 m 结构/密封风险清单和后续实物验证建议；明确压力舱结构校核与渗漏试验尚未由本次仿真完成。

## 8. 验收

1. 三套水下驱动的电机、减速器、线轮和支架几何可在 CAD 中装配；无未解释干涉，腱线走向和线轮行程明确。
2. MuJoCo 可加载新 MJCF，并自动运行淡水/海水 1 m/5 m 四工况；刚体质量、排水体积和浮力可独立复算。
3. 电机模型使用有来源的负载/连续数据或明确标记的参数范围；不会把理论堵转值当作连续扭矩。驱动器的扭矩、速度、电流/张力、线轮行程和控制限制均有日志。
4. 电机与附件浮力进入整机配平，模型结果能区分裸软臂和完整湿侧驱动装配。
5. 四工况的任务结果、参数裕度和敏感性报告完整；1 m/5 m 的差异可由显式建模输入解释。
6. 中文 v4 论文和图表渲染检查通过；论文区分供应商标称深度、实测/额定条件与整机部件验证，不把电机页面深度声明误当作总装耐压认证。
7. 不以 MuJoCo 结果替代打印件强度、材料标定、压力舱结构校核、连接器密封或渗漏试验。

## 9. 来源与历史基线

- 原水下仿真规格与 B32 基线：[`2026-10-11-b32-underwater-simulation-design.md`](2026-10-11-b32-underwater-simulation-design.md)、`local/spiral-soft-arm/simulation/v2/configs/B32水下基线.json`。
- 原底侧电机安装：`local/spiral-soft-arm/solidworks/motor_mount_v1/README_电机底侧布局.md`、`parameters.json`。其 Ø24.4 × 64.8 mm 占位、中心半径 55 mm、z=-25 mm 布局仅对应 M2006 P36。
- ApisQueen 4092 产品页（供应商标称深度、传动比、转速/扭矩表及当前售价）：<https://www.waterproofmotor.com/products/apisqueen-12-24v-0-200rpm-4092-ip68-brushless-dc-waterproof-motor-gear-motor-for-rov-boat-underwater-thruster>。页面标价可能变化，页面规格相互不一致且当前显示缺货；规格冻结前必须取得供应商书面确认并完成样机测量/测试。
- ChatRobotic, F3130 SeaDrive 产品页（低单价、5 m/24 h 声明和转速/轴径数据）：<https://www.chatrobotic.com/product/detail/f3130-170kv-seadrive-waterproof-brushless-motor.html>；只作为价格下界参考，不作最终湿侧选型。
- Blue Robotics, M200 Motor 产品页（后备规格、测试水深、价位、外形和水中质量）：<https://bluerobotics.com/store/thrusters/t100-t200-thrusters/m200-motor/>。
- Blue Robotics, Basic ESC 产品页（M200 后备路线的参考价、PWM 输入和电流规格）：<https://bluerobotics.com/store/thrusters/speed-controllers/besc30-r3/>。
- maxon, Underwater Drives 产品页（替代架构调研入口）：<https://www.maxongroup.com/en/market-solutions/mobility-solutions/underwater-drives>。
- MuJoCo 官方流体力说明：<https://mujoco.readthedocs.io/en/3.15.0/computation/fluid.html>；该模型是现象学流体模型，不等同 CFD。
- 历史水下报告和参数论文保留在 `local/spiral-soft-arm/preprint/v3/`，本规格不覆盖这些文件。
