songgagav/spiral_soft_arm/local/spiral-soft-arm/solidworks/electronics_enclosure_v20/README_轴套与线轮驱动模组.md

# B32 v20：M3508 D 轴套双轴封与线轮模组

v20 是 M3508 单通道传动布局的后续评审模型。它保留 v19 的官方电机参考、直角齿轮包络、水平线轮轴、线轮 D 孔、端面压片和直线切线出线，并按本轮澄清新增电机 D 轴套外圆油封及配套座孔。v19 文件不覆盖；本目录仍是本地候选，不代表打印、加工或水下运行放行。

## 本轮更改

电机输出轴为 D 形。D 轴先插入 D 孔轴套，轴套的圆柱外圆作为油封工作面；油封不直接压在裸露 D 平面上。v20 将 16 × 22 × 7 mm 骨架油封包络放在轴套 Ø16 mm 外圆，位置为轴向 Z = -80.5 至 -73.5 mm，并在透明驱动舱下部加入 Ø22 mm 座孔及环形支承隔板。

湿侧线轮仍位于舱外，因此横向线轮输出轴处原有的 10 × 22 × 7 mm 主油封、轴承和迷宫结构保留。v20 表达两个不同轴线位置的密封界面：电机 D 轴套外圆处的电机侧密封，以及横向线轮轴处的主干湿隔离密封。

## 主要接口

- M3508 官方 STEP 沿用 v18 references/official 中的 DJI_M3508_P19_official.stp；生成报告记录了参考文件 SHA-256。
- 电机 D 轴套：D 孔套在 Ø10 mm、AF9.0 mm 的电机轴上；轴套外径 Ø16 mm，轴套总长 20 mm，其中电机 D 轴插入 12.3 mm，延长轴插入 7.7 mm。配合间隙仍是初始值，须按实物测量和试片确认。
- 电机侧油封：16 × 22 × 7 mm 尺寸包络候选；油封唇口对准轴套圆柱外径，不接触 D 平面。型号、唇形、材料、弹簧、过盈及压力方向尚未选定。
- 横向输出侧：KHK MMSA1.5-20R/L 依据目录尺寸建立无齿形包络，输入和输出轴为 Ø10 mm。该齿轮包络不能用于确认真实啮合、背隙或齿面强度。
- 线轮：Ø10.3 / AF9.8 mm D 孔配 Ø10 / AF9.5 mm 输出轴，端面压片与 M4 螺钉限制轴向脱出。配合间隙是打印拟合初值。
- 拉索沿线轮外层切线直达倒角导孔；本模型的理想中心线长度约 12.641 mm。线轮外挡边与迷宫环的模型间隙为 0.35 mm。

## 本轮 CAD 检查

- 36 个命名零件通过 CadQuery 实体有效性检查。
- STEP 模型导出为毫米单位；请在实际 CAD 软件中继续复核分组件、座孔和紧固件可达性。
- 电机 D 轴套与新增油封包络最短距离为 0 mm、交叠体积为 0；油封外径与驱动舱座孔也是 0 mm 间隙、0 交叠体积，表示名义贴合。
- 横向输出轴与现有骨架油封包络名义间隙为 0.02 mm；该环形包络没有实际唇形，不能视为真实油封的工作间隙或密封结果。
- 线轮切线至导孔长度及既有齿轮、轴承、迷宫相关几何结果记录在装配审查.json 和物理合理性审查.md。

## 文件

- B32_v20_M3508_轴套线轮双轴封传动模组.step：评审装配 STEP。
- B32_v20_M3508_轴套线轮双轴封效果图.png：总装效果图。
- B32_v20_线轮切线近景.png：线轮切线和导孔近景。
- B32_v20_D形线轮与压片剖视.png：线轮 D 孔与端面压片剖视。
- B32_v20_电机D轴套油封剖视.png：电机 D 轴、轴套外圆与油封的剖面说明图。
- generate_shaft_sleeve_reel.py：可复现的 CadQuery 生成脚本。
- parameters.json：名义尺寸、假设与未确认项。
- 装配审查.json、物理合理性审查.md：几何检查数据和边界。

## 尚未验证

1. 16 × 22 × 7 mm 只是尺寸包络候选，尚未选定可采购的油封，也未确认是否有适合 5 m 水深、淡水/海水和 30 分钟运行的产品。
2. 真实油封唇口接触、轴套表面粗糙度/硬度、轴跳动、偏心、润滑、压力方向及材料耐水性没有建模或试验。
3. 电机侧底盖与完整电机压力壳、M3508 引线出线和电缆密封结构仍需纳入完整总装；本单通道模型没有证明电机整体已处于水密仓内。
4. 横向主油封、迷宫、隔板及壳体支承的最终连接、装配公差和维修拆装空间仍须按实体方案检查。
5. KHK 齿轮齿形、扭矩、轴/轴承强度、线缆实际直径和弯曲半径、卷绕行程、打印配合及 5 m 水压测试均未完成。

因此，v20 适合评审轴套外圆与油封的相对位置，不能作为加工图、打印放行件或水下密封证明。

## 资料来源

- DJI M3508 官方产品资料与 STEP：[RoboMaster M3508 产品页](https://www.robomaster.com/zh-CN/products/components/general/M3508)。
- KHK 2025 Miter Gears 目录：[目录 PDF](https://khkgears.net/pdf/2025/miter-gears.pdf)，用于 MMSA1.5-20R/L 尺寸、安装距与孔位说明。v20 仍未取得该齿轮的真实齿面 STEP。
