songgagav/spiral_soft_arm/local/spiral-soft-arm/solidworks/electronics_enclosure_v23_cable_and_seal_interfaces/README_拉索过渡与轴封接口.md

# B32 v23 拉索过渡与轴封接口审查

## 本版状态

v23 从 v22 另存，未覆盖 v22。此版重做了三路输出轴的密封跑道和共用干仓的轴封座，并做了 BREP 几何检查、总装 STEP 导出与回读。当前仅为接口几何候选，尚不是打印发布、压力容器或水下运行放行。

## 轴封与轴套

| 接口 | 当前设计 | 核查结果 |
| --- | --- | --- |
| 电机 D 轴轴套 | v21 CNC 轴套，内孔配 M3508 输出轴，外圆 Ø16；在 v23 中作为扭矩联轴套保留 | 其 Ø16 外圆不再当作水下密封跑道。M3508 与该轴套都在共用干仓内，原 16×35×7 浮动密封圈没有配合座，也不是干湿边界，已从功能总装移除 |
| 水侧输出轴封 | SKF HMSA10 RG，10×22×7 mm 尺寸候选，位于三路水平输出轴 | 密封唇下方的 Ø10 圆柱跑道连续完整；原 v22 的长 D 平面会削掉约 1.87% 的截面，已缩短到线轮和齿轮需要的传扭区 |
| 轴封座 | 直接集成到干仓隔板的 Ø25.8 加厚座体 | Ø22 H8 名义孔，深 7.3 mm；相对 7 mm 密封宽度多 0.3 mm；入口倒角为 0.6 mm 轴向、0.3 mm 径向；密封由干侧肩部限位 |

为避开中部电子筒，三路驱动及线轮中心相对 v22 外移 0.8 mm。轴封座外径缩到 Ø25.8，密封座周边名义材料厚度为 1.9 mm；CAD 中座体与电子筒保持至少约 1 mm 间距。这里需在打印后精加工，孔壁强度、压装变形和制造公差仍要用材料样件确认。

SKF 对该系列给出的壳体孔建议为 H8，Ø22 的范围为 22.000–22.033 mm；金属骨架密封座深至少为密封宽度加 0.3 mm。轴封座要在打印后加工到尺寸和表面要求，打印出的 Ø22 孔不能直接当作 H8 成品。轴表面要求需按所购密封的当前资料执行；SKF 资料给出的典型建议是 Ø10 h11、低粗糙度并要求较高表面硬度。模型使用自制输出轴的名义 Ø10 圆柱面，尚无实物轴的公差、硬度、粗糙度和跳动测量结果。

## 水下适用性限制

HMSA10 RG 产品资料将用途描述为油或脂润滑，并给出最大工作压力 0.05 MPa。按 5 m 水深估算，淡水静压约 0.049 MPa，海水约 0.050 MPa；海水已略高于该上限，淡水也没有留出设计裕度。当前尺寸候选不能据此认定为适用于 5 m 淡水或海水运行。采购前需要 SKF 对连续旋转、海水介质和压力差给出书面确认；若不能确认，应更换有明确水下旋转工况额定值的密封形式，再改座孔尺寸。

模型验证只说明密封环占位与整体轴封座名义几何相容：三路密封环与干仓实体无体积干涉，密封跑道均为完整圆柱面。它没有证明压装量、密封摩擦、寿命、耐盐雾、干仓强度或 5 m 不漏水。

## 拉索进入顶盘线孔

三路线轮选择上侧切线放线。拉索从线轮最外层切点到机械臂根部入口始终处于同一条直线，其俯视投影保持对应拉索的径向方向，线轮转轴与该直线垂直。每路切点到根部入口的轴线长约 55.25 mm。线轮中心仍处于半径 81.8 mm 的工位；向内继续移动会消耗线轮与直径 136 mm 电子筒之间的间隙。

原顶盘的竖直孔已在 v23 几何中封闭，改切一条 Ø4.2 mm 的斜向直通孔，孔口按 Ø5.8 mm 名义直径倒角。直线在 8 mm 厚顶盘底面的入口位于半径约 62.61 mm，顶面的出口位于原软臂根部腱道中心半径 30.6 mm；孔轴在顶盘内约长 33.0 mm。Ø4.0/Ø2.2 mm 的独立导管沿直线进入斜孔，距根部入口中心 9 mm 处结束，给根部转向留出空间。选择上侧切线后，拉索越过电子筒外径半径 68 mm 处的高度约为 Z=-9.35 mm，高于电子筒顶面 Z=-20 mm，名义竖向净距约 10.65 mm。

原 B32 软臂内腱道接近轴向，与从线轮来的斜向直线不能共轴。v23 只在第一段机械臂根部切出三条平滑导入通道：从顶盘出口接入，在 Z=60 mm 处与原腱道相切衔接；导入通道名义直径 Ø4.2 mm，拉索模型直径 Ø1.6 mm。进入根部后中心线方向累计改变约 73.0°，曲线最小弯曲半径按参数化中心线约 9.06 mm。这仅说明几何上连续，不代表所购拉索允许该弯曲半径。拉索从线轮切点穿过顶盘保持直线，进入软臂根部后才开始平顺转向。

顶盘斜孔为浅角度长孔，需做单独打印样件检查孔壁、导管穿入及倒角品质。根部曲面导入段需要拉索样件在张力下做往复运动和磨损检查，确认不会卡在与原腱道的交接处。

## 检查记录

- v23 定向几何检查：通过，三路 Ø10 密封跑道完整，三只 10×22×7 占位环与集成座孔无实体干涉。
- 继承的干仓几何测试：通过。
- STEP：已导出并回读为有效 BREP；173 个命名组件、273 个实体；总装边界沿用 B32 外形。
- 全局实体干涉审查：14,878 对组件中 959 对包围盒相交并作精确计算；新增部分只有 9 对预期紧固/拉索接触，无新旧结构穿透。三路线盘仍完全位于湿侧凹位，电子筒与上方包覆板无新增实体干涉。
- 预览：外观图与 Y=0 剖视图，1600×1120 px。
- 尚待完成：拉索导入段与线缆最小弯曲半径的实物确认；打印后精加工验证；材料、固定件、密封压缩、旋转寿命和压力舱试验。

## 交付文件

- `B32_v23_M3508三路拉索与轴封接口总装.step`
- `B32_v23_M3508三路总装预览.png`
- `B32_v23_轴封与拉索接口剖视.png`
- `B32_v23_拉索直线与根部过渡尺寸图.png`
- `parameters.json`
- `装配审查.json`
- `装配冲突审查.json`

## 官方尺寸依据

- [SKF HMS5/HMSA10 产品资料](https://cdn.skfmediahub.skf.com/api/public/0901d196802a343c/pdf_preview_medium/6234_5_EN_Maximizing_performance_pdf_preview_medium.pdf)
- [SKF Industrial Shaft Seals 目录](https://cdn.skfmediahub.skf.com/api/public/09433a92e9164581/pdf_preview_medium/09433a92e9164581_pdf_preview_medium.pdf)
- [Freudenberg B2PT 16×35×7 产品页](https://products.fst.com/global/en/categories/radial-shaft-seal-simmerring-b2pt/products/40412791)（只用于核对原电机侧密封候选尺寸；该密封未作为 v23 水下密封使用）
