songgagav/spiral_soft_arm/docs/superpowers/plans/2026-10-23-m2006-sealed-drive.md

# M2006 干侧电机与湿侧线盘候选

本计划依据用户确认的 M2006 P36、迷宫结构加骨架油封、仅线盘处于湿侧的方案。沿用 v10 的三段软臂、250 mm 六边形顶盘、线盘切线出线与线孔倒角。

1. 建立独立的 `electronics_enclosure_v11` 参数及生成脚本，引用 v10 的软臂与顶盘几何，不修改 v10 基线。
2. 每轴建立 M2006 外形、干侧电机筒、端盖、独立 Ø8 mm 圆轴、联轴器、支承轴承、可更换油封座、迷宫间隙及湿侧线盘的几何代理。电机筒的静密封、轴封型号和实物公差均标为待定。
3. 保留三轴切线出线与顶盘孔对齐，输出总装 STEP、俯视与轴封剖面预览、参数与状态说明。审阅基本实体和明显干涉，不作打印、水密或耐压放行。
4. 将硬件连线候选由 4092/mini ESC/PWM 更新为 M2006/C610/CAN，并列出需按实物复核的接口。

本轮不选择采购用骨架油封尺寸或宣称打印件本身可承受 5 m 水深。CAD 中的 Ø8 mm 独立轴、8×16×5 mm 油封包络等只用于布置评估。
