songgagav/spiral_soft_arm/docs/superpowers/plans/2026-10-10-spiral-soft-arm-preprint-package.md

# 550 mm 三缆软臂打印前交付计划

**状态：** 本计划的 CAD、STL、装配和文字交付已完成；进入外包厂确认、短样打印和实物验证阶段。未把任何 TPU 性能写成已验证结果。

## 目标

按已批准的 V2 基线，完成一套可送外包厂询价和首轮打印的机械设计包：冻结本地 Blender 实测几何、设计刚性三电机/线轮支架与 TPU 软臂接口，输出 STL、装配场景、采购清单、打印说明、装配及低风险调试流程。当前工作不把未打印 TPU 的力学性能或抓取成功率写成已验证指标。

## 冻结输入

- 550 mm 主体，三腱、`p=0.5`、单元角 30°；实际候选为 A36/A37/B32/B33。
- 首打样选 B32 `cut_off`（7 mm 目标尖端、32 单元）；其余候选留档对比。B32 Blender 实测：高度 550.0136 mm、基部直径 68 mm、尖端直径 7.359 mm，解析估算最小壁厚 0.80 mm。
- TPU 95A 一体主体；电机和底座由独立刚性件承载；首轮实验负载目标不超过约 100 g。
- 驱动选三套 M2006 P36 + C610；工作张力上限必须由后续样条/测力标定决定。
- 软臂基部直径、尖端及长度按本地 Blender 网格尺寸验收，不把连续论文公式的输出等同于实物尺寸。

## 执行和验收

1. [x] 更新候选输入并拟合本地离散轮廓，固定 `p=0.5`、`Δθ=30°`。
2. [x] 使用 Blender 5.2.2 生成四候选；阶段 A 验证通过，首选 B32 `cut_off`。
3. [x] 构造 B32 三电机径向驱动装配；含 M2006/C610 简化包络、支承轴/轴承、线轮、腱线导向、刚性底板及末端锚固。
4. [x] 导出 10 个 STL（含主体、7 种刚性件和 2 个 TPU 短样）；重导入后尺寸回读，均为闭合单体。
5. [x] 写入中文 BOM、打印要求、装配/调试步骤、供应商前置核对项和性能边界。
6. [x] 刷新源文件指纹；生成 `.blend`、总装预览、传动细节图和机器可读 STL 清单；新建 STL 往返验收测试并运行通过。

## 首轮打印放行门槛

- B32 主体满足 CAD 尺寸范围，三腱孔可贯通，STL 单体闭合且按 mm 导入无缩放错误。
- 刚性支架、夹环、线轮/轴承支座、马达包络和线缆路径在 Blender 装配中没有几何穿插；商业件尺寸有官方来源或明确标注为包络近似。
- **待供应商/实物验证：**确认 TPU 95A 550 mm 长件的成型空间、方向、薄壁保留、孔道和切片质量；先打短样条检查孔道、壁厚、摩擦及锚固，再决定是否下单打全长臂。
- 未完成 TPU 样条测试前不宣称安全张力、长期寿命、100 g 负载能力或抓取成功率；电机调试采用外部测力和低速/限力策略。
