songgagav/spiral_soft_arm/docs/superpowers/plans/2026-10-11-bottom-motor-mounts.md

# 底侧三电机预留位与装配预览实施计划

> **执行说明：** 用户已选择三台电机安装在底板下侧并按 120°均布。本文只覆盖可审阅 CAD 与预览；预览确认后再更新物理仿真和打印放行资料。

**目标：** 在不改动论文式 B32 软臂本体的前提下，生成三台 M2006 候选电机的底侧预留装配、固定孔位及 SolidWorks 可导入 STEP，并输出供用户检查的渲染图。

**结构：** 在独立目录创建 CadQuery 生成器和验证脚本；读取原始 B32 STEP 与 DJI 官方 M2006 STEP 作为参考。可打印的刚性底板/夹座、非打印电机外形包络和软臂分别作为装配组件，三电机围绕软臂根部按 0°、120°、240°布置。只有官方电机文件含可用实体和安装孔时才将其用于配合；若文件是爆炸曲面或无实体，则用官方总包络作占位，并明确标注固定接口待实物核对。根部保持件按 B32 首个螺旋单元的实际截面采样留隙，采用浅分体压边，避免用高夹环跨过论文单元间隙。

**技术栈：** Python、CadQuery、现有 B32 STEP/STL、DJI 官方 M2006 STEP；不使用 Blender。

**依据：** `local/spiral-soft-arm/solidworks/paper_v1/` 中的冻结 B32 几何和 `preprint/v2/驱动与装配安全说明.md`。

## 全局约束

- 软臂仍为论文式 B32 一体几何，名义长度 550 mm；不得添加刚性假铰链或修改其 STEP/STL。
- 参考电机为 M2006 P36，官方外形规格 Ø24.4 × 64.8 mm；电机仅作装配参考，不并入打印 STL。
- 新增电机固定结构为独立刚性打印件；孔型、间隙和孔位都必须在参数文件中明示。
- 电机相位为 0°、120°、240°；底板位于软臂根部的下侧。
- 在用户审阅并确认装配预览前，不更新抓取仿真或声明整机达到打印放行状态。

## 重点检查

- Motor 官方 STEP 为爆炸曲面或无法提供封闭实体时，不得静默退回“已验证实物”表述；可生成标注为包络占位的版本。
- 三台电机包络、相邻夹座、螺钉头和底板边缘必须无几何干涉。
- 三条腱道需能通过底板；孔位必须与 B32 基部三腱位置同相位。
- 新装配 STEP 回读有效，软臂组件数量和包围盒与基准一致。
- 可打印刚性件 STL 必须闭合；装配参考电机不得进入打印 STL。

---

### 任务 1：先建立验收测试

**文件：**
- 新建 `local/spiral-soft-arm/solidworks/motor_mount_v1/test_motor_mount.py`
- 参考 `local/spiral-soft-arm/solidworks/paper_v1/论文构形几何验收.json`

- [x] **步骤 1：** 编写测试，断言配置中恰有 3 台电机、角度为 0°/120°/240°、候选电机规格为 Ø24.4 × 64.8 mm。
- [x] **步骤 2：** 运行测试，确认因新生成器/配置不存在而失败。
- [x] **步骤 3：** 后续实现生成器接口 `build_motor_mount(config) -> AssemblyGeometry`，供测试读取电机中心、孔位和部件清单。

### 任务 2：生成底侧支架与装配 STEP

**文件：**
- 新建 `local/spiral-soft-arm/solidworks/motor_mount_v1/parameters.json`
- 新建 `local/spiral-soft-arm/solidworks/motor_mount_v1/generate_motor_mount.py`
- 读取 `local/spiral-soft-arm/solidworks/paper_v1/B32_550mm_SpiRobs_打印实体.step`
- 读取 DJI 产品页关联的官方 M2006 P36 STEP，记录来源 URL 与 SHA-256

- [x] **步骤 1：** 配置软臂基准、120°布局、电机外形、安装板、腱道通孔、螺孔/槽尺寸及打印间隙。
- [x] **步骤 2：** 运行验收测试，确认缺少生成器时按预期失败。
- [x] **步骤 3：** 实现底板、三个独立电机托座/抱箍和按首个 B32 螺旋单元实际截面留隙的浅分体根部压边；保留三条腱线穿孔和测试台固定孔。
- [x] **步骤 4：** 导出装配 STEP、安装件 STEP、九个单件闭合 STL（另打 ZIP 包）与几何验收 JSON；电机和软臂仅作为装配参考组件。
- [x] **步骤 5：** 回读 STEP，检查实体数、位置、间隙、螺孔数量、尺寸单位；检查 STL 闭合及打印件清单。
- [x] **步骤 6：** 运行测试和模型生成命令，记录实际输出及失败项。

### 任务 3：渲染并更新本轮说明

**文件：**
- 新建 `local/spiral-soft-arm/solidworks/motor_mount_v1/README_电机底座.md`
- 输出 `local/spiral-soft-arm/solidworks/motor_mount_v1/电机底侧布局预览.png`

- [x] **步骤 1：** 用 CadQuery 导出的网格生成论文式 B32 自然基态总装与底板底视合成预览；清楚标记三电机、安装板、固定螺孔、腱线孔。
- [x] **步骤 2：** 检查图片可读性、三个电机均可见、软臂显示为论文式螺旋单元外观且未被直杆占位替代。
- [x] **步骤 3：** README 记录打印件/参考件区别、孔位假设、仍需实物核对的接口及 SolidWorks STEP 导入方式。
- [x] **步骤 4：** 将 STEP 和预览交给用户审阅；用户确认前不把支架标记为最终放行件。

**审阅后续项：** 用户确认预览后，再将电机质量和底座固定关系纳入 MuJoCo 多刚体仿真，并重跑接触、干涉和打印放行检查；这些不属于本轮预览验收。
