songgagav/spiral_soft_arm/local/spiral-soft-arm/solidworks/user_3_0/几何审查与B32对比.md

# 用户自建 3.0 整体打印候选

**当前路线：** 按用户决定，先尝试整体单件打印。原始 STEP 保留不变，另有布尔融合 STEP 和经网格检查的试打 STL。资料属于几何评审/试打候选；打印机适配、三缆功能、材料强度与水下性能尚未验证。

## 文件

- 原始模型：[`spi_rob_20261012_131147.step`](spi_rob_20261012_131147.step)
- 单实体融合 STEP：[`spi_rob_20261012_131147_整体融合.step`](spi_rob_20261012_131147_整体融合.step)
- 单件试打 STL：[`spi_rob_20261012_131147_整体试打.stl`](spi_rob_20261012_131147_整体试打.stl)
- 融合/网格审计：[`融合导出审计.json`](融合导出审计.json)
- 可复现导出脚本：[`fuse_monolithic.py`](fuse_monolithic.py)
- 导出依赖：[`requirements-cad.txt`](requirements-cad.txt)
- 对照基线：[`../paper_v1/B32_550mm_SpiRobs_打印实体.step`](../paper_v1/B32_550mm_SpiRobs_打印实体.step)

重生成命令：在本目录安装 `requirements-cad.txt` 中的依赖后运行 `py fuse_monolithic.py`。脚本只读原始 STEP，输出融合 STEP、STL 和审计 JSON。

## 来源与追溯

- 用户提供压缩包：`3.0.zip`
- 压缩包内模型：`3.0/spi_rob_20261012_131147.step`
- STEP 单位：mm
- 压缩包 SHA-256：`9CDA4A6F495421BD822767270CEB905D3C60AB09F045D3EE8AFAF3B7519813AE`
- 原 STEP SHA-256：`E5870759E9A1338843797E61D72DB2CE2A285865A1657FE6D952B9022024EAF1`
- 压缩包只有 STEP 几何，没有设计说明或操作指令。

## 几何和导出检查

| 项目 | 结果 |
| --- | ---: |
| 原始实体 | 29（28 个渐变锥形单元 + 1 个轴向细长实体） |
| 融合后 STEP | 1 个有效实体；往返导入仍为 1 个有效实体 |
| STEP 包围盒 | 508.127 × 105.177 × 118.333 mm，主轴 X |
| 融合 STEP 体积 | 928,811.365 mm³ = 0.928811 L |
| 试打 STL 三角面 | 414,132 |
| STL 拓扑 | 单连通、封闭、法向一致；边界边 0，非流形边 0 |
| STL 与 STEP 包围盒最大差 | 0.000002 mm |
| STL 网格体积误差 | 0.045739% |
| 导出时清除的零面积面 | 2 个；体积变化约 7×10⁻¹⁰ mm³ |

原始 STEP 共有 29 个实体；相邻锥形单元无正间隙，细长轴向实体与单元相交。融合输出适用于先观察/试打单件几何。**封闭 STL 只说明三角网格拓扑闭合，不代表壁厚、打印强度、缆索功能或成品质量已合格。**

## 与 B32 基线对比

| 项目 | 用户 3.0 | 本地 B32 打印实体 |
| --- | ---: | ---: |
| 文件 | 本目录融合 STEP/STL | `../paper_v1/B32_550mm_SpiRobs_打印实体.step` |
| 主轴方向 | X | Z |
| 包围盒 | 508.127 × 105.177 × 118.333 mm | 66.656 × 59.500 × 550.014 mm |
| 主体体积 | 0.928811 L | 约 0.357146 L |
| 体积比 | 约为 B32 的 2.6006 倍 | 基线 |

外形较宽且主轴方向不同，不是与 B32 或现有湿侧装配接口兼容的替换件。输出模型没有旋转到 B32 的 Z 轴，保持用户原始坐标方向。

## 打印前仍需确认

1. 打印机有效成型空间至少要容纳约 **509 × 106 × 120 mm** 外包络，且还要留底板、裙边/支撑余量；若设备放不下，就需分段或缩放并重新验证，不应强行切片。
2. STEP 没有部件语义标注；三路腱索通道、120° 导向、根部/尖端锚点、孔径和局部最小壁厚还需在 CAD 中确认。未确认这些结构前，此 STL 只是整体外形试打件。
3. 先做短样或局部试打，检查薄壁连续性、翘曲、穿缆、弯曲和回弹；再确定 TPU 硬度、喷嘴、层高、填充、打印方向和支撑。
4. 按实际打印质量、材料、填充/空腔及进水状态核算浮力。若按整个融合体积均为实心 TPU、密度 1200 kg/m³ 粗估，完全浸没淡水中净向下约 **1.82 N**；这不是实际成品测量值。
5. 确认腱路和驱动参数后，再把 3.0 纳入淡水/海水、1 m/5 m 仿真。当前 B32 四工况均未达到 5 mm 抬升：保持窗抬升约 -0.002 mm，单缆上限 0.15 N、线轮峰值力矩 0.000975 N·m、收线约 0.30 mm。因此新几何还需先验证目标接触可达性和有效收线行程。[现有水下仿真评估](../../preprint/v3/水下仿真评估报告.md)
6. 5 m 水深约 49–50 kPa 表压；运动仿真不替代压力舱结构校核、保压和渗漏试验。

**放行边界：** 本目录包含可供几何评审和打印机适配检查的单件 STEP/STL；未证明可完成三缆弯曲、5 mm 抬升、长期浸水或 5 m 耐压。
