songgagav/spiral_soft_arm/local/spiral-soft-arm/preprint/underwater_prototype_v1/docs/外部模型几何与3MF预检.md

# 外部模型几何与 3MF 预检

**状态：数值网格预检完成；CAD 可视检查、切片复核与实物打印仍待完成。**

本轮只读读取参考软臂 STL、B32 原打印网格、3.0 融合试打网格和两个 3MF 工程中的模型/变换信息。没有修改或导出任何 CAD/STL，也没有运行实际切片。

## 1. 网格尺寸与坐标

| 模型 | 面数 | 原始包围盒跨度（坐标单位） | 主轴 | 最大横向跨度/主轴长度 | 网格闭合检查 |
|---|---:|---:|---|---:|---|
| 外部双缆 STL | 53,632 | `249.677 × 50.574 × 28.824` | X | 20.25% | 通过¹ |
| 外部三缆扩展 STL | 54,846 | `231.290 × 27.773 × 31.417` | X | 13.58% | 通过¹ |
| 本项目 B32 打印实体 | 416,352 | `66.656 × 59.500 × 550.014` | Z | 12.12% | 通过¹ |
| 本项目 3.0 一体试打 STL | 414,132 | `508.127 × 105.177 × 118.333` | X | 23.29% | 通过¹ |

¹ 按 `1e-5` 坐标单位合并相同网格顶点后检查三角面边：每条边均由两个三角面共享。该结果只说明 STL 网格边界闭合，不证明壁厚、腱孔、装配、材料强度或水密性。STL 自身没有单位声明；尺寸比例判断还需结合工程文件与 CAD 实物测量。

两个外部模型主轴都沿 X，而 B32 主轴沿 Z；三缆 STL 的包围盒中心约为 `(-274.582,-77.947,963.642)`，与双缆文件的 `(124.838,0,0)` 不同。若只为同屏观察，可先平移到各自包围盒中心，再将长轴 X 旋转到 Z，并让基端落在 `Z=0`。这只是显示对齐，不是零件配合或功能注册，不能据此缩放/替换 B32。

## 2. 3MF 的单位、部件与摆放变换

| 工程 | 文件内模型信息 | 切片工程保存的摆放结果 | 解读边界 |
|---|---|---|---|
| X1 Carbon TPU95A 工程 | 3MF 模型单位为 `millimeter`；内嵌网格跨度约 `249.677 × 50.574 × 28.824 mm`，与双缆 STL 包围盒一致到约 0.001；内嵌网格为 15,776 面，少于 STL 的 53,632 面。 | 变换后床面包围盒约 `202.112 × 167.495 × 50.574 mm`，模型最低 Z 约为 0。 | 支持双缆 STL 按 mm 解读及其工程中的摆放思路；三角面数量不同，未做逐面/表面距离比对，不能声称两网格完全相同。 |
| A1 仓库示例工程 | 3MF 模型单位为 `millimeter`；装配包含 25 个网格部件，未应用工程缩放时包围盒约 `464.082 × 83.704 × 50.220 mm`。 | 保存的整体均匀缩放约为 `0.516443`；摆放后包围盒约 `196.211 × 162.582 × 43.228 mm`，最低 Z 为 0。 | 工程实际按约 51.6% 尺寸摆放；不能把它的切片结果当作原尺寸 B32 或三缆 STL 的 100% 打印证明。 |

`A1_仓库示例打印工程.3mf` 与仓库中的 `spi_rob_3dprinting.3mf` SHA-256 相同，属于同一份文件。3MF 记录的是模型网格和打印摆放/工艺设置；这里解析了保存的数据，没有在对应切片器里重新切片，也没有确认打印机实际执行结果。

## 3. 轴向截面数值采样

在各网格最长轴的 10%、25%、50%、75%、90% 位置各取一张与主轴垂直的三角网格截面。下表为闭合交线环数；`a/b` 表示 `a` 个闭合环、`b` 个连通交线分量。

| 模型 | 10% | 25% | 50% | 75% | 90% |
|---|---:|---:|---:|---:|---:|
| 外部双缆 STL | 1 | 3 | 1 | 1 | 3 |
| 外部三缆扩展 STL | 4/5² | 4/5² | 1/2² | 4/5² | 4/5² |
| B32 打印实体 | 1 | 4 | 1 | 1 | 1 |
| 3.0 一体试打 STL | 1 | 1 | 4 | 1 | 4 |

² 三缆 STL 的部分交线图在顶点焊接后出现度数为 4 的分支节点；报告环数时保留为未闭合分量，不把这些截面推断成腱孔。其余模型在这些采样站的交线节点度数为 2。所有环数都只是网格截面轮廓的拓扑计数，轮廓可能来自螺旋单元、外壳边界或孔道；不能仅靠计数判定哪一条是绳路。

## 4. 对原项目的可迁移结论

- **B32：** 外部三缆模型的归一化外包络比例约为 13.58%，与 B32 网格的 12.12% 接近，可用于形态对照；两者截面轮廓结构不同，且没有孔道/壁厚测量，不构成 B32 三缆参数或几何替代依据。B32 论文基线继续作为设计依据。
- **3.0：** 可借鉴按打印机床面复核摆放包围盒、记录工程缩放和按截面查结构变化的流程。3.0 最大横向跨度相对主轴约 23.29%，明显宽于 B32 和外部三缆样例的包络比例；这只是外形差异，不能说明性能优劣或腱路有效。
- **打印：** X1 工程表明双缆模型可用倾斜摆放把最高 Z 控制在约 50.6 mm；A1 工程靠整体缩放后获得约 43.2 mm 的高度。支撑接触、绳孔堵塞、薄壁与 TPU 变形仍需在切片预览和短样中检查，不能照搬摆放或缩放到 B32。

## 5. 下一步验证门槛

1. 在 CAD 中逐个检查外部三缆网格与 B32 的截面，确认中央弹性轴、三条腱路、孔径和最小壁厚；记录单位、配准和测量位置。
2. 在目标打印机的切片器中打开 B32 基部/尖端 80 mm TPU 工艺短样，确认模型比例为 100%、TPU 材料槽、支撑接触、孔道可清理性和实际床面方向，再导出切片预览供人工复核。
3. 实际打印后填写已有的打印过程记录和电机/水下实测表；只有测量通过后再决定是否提出 B32 几何变更候选。

本轮没有 CAD 软件中的目视确认，也没有打印机、力学或水下试验数据；以上任何网格检查均不构成实物放行结论。
