songgagav/spiral_soft_arm/local/spiral-soft-arm/preprint/underwater_prototype_v1/docs/外部模型参考与迁移审查.md

# 外部模型参考与迁移审查

**状态：资料审查完成；设计迁移、CAD 改动和实物验证均未授权/未实施。**

本文记录 `E:\Spiral_Robots\新建文件夹` 中与螺旋软臂及打印有关的外部文件，给出可借鉴内容和迁移边界。外部 STL、3MF 与切分样例仅作为参考，不是 B32 或 3.0 的新设计输入；现有 B32 论文基线与 3.0 候选几何保持不变。

## 1. 文件清单与可复核信息

| 参考文件 | SHA-256 | 可直接核对的信息 |
|---|---|---|
| `OpenSpiRobs\02_原始论文与打印模型\打印模型\双缆软体臂_原始模型.STL` | `7426D49B1F8F42497EDCA1667BA9FED37859BCF905F58880E68314B7C65A8827` | 二进制 STL，53,632 三角面；包围盒原始坐标 `x=[0,249.677]`、`y=[-25.287,25.287]`、`z=[-14.412,14.412]`，跨度约 `249.677×50.574×28.824`。几何中心约 `(124.838,0,0)`。 |
| `OpenSpiRobs\02_原始论文与打印模型\打印模型\三缆软体臂_拓展模型.STL` | `BF7502129E59C00F24B9F6CC6B6F8DDEB868116C4C4F4D0826B78C41129F351B` | 二进制 STL，54,846 三角面；包围盒原始坐标 `x=[-390.227,-158.937]`、`y=[-91.834,-64.060]`、`z=[947.933,979.350]`，跨度约 `231.290×27.774×31.417`。中心约 `(-274.582,-77.947,963.642)`，与双缆模型原点不同，叠加前必须先对齐坐标系。 |
| `OpenSpiRobs\02_原始论文与打印模型\打印模型\X1Carbon_TPU95A_原始打印工程.3mf` | `B0CB1E44E4A6CFB0130C43EA600EA90A86A3789389762775517658DD79E825CB` | 工程设置记录 X1 Carbon、0.4 mm 喷嘴、0.2 mm 层高、2 圈外墙、支撑启用（`normal(manual)`）、5 mm 自动 brim、35% gyroid 填充。工程中有 PLA 与 TPU 多个材料槽；仅凭槽列表不能判断目标模型实际选用了哪个槽或材料。 |
| `OpenSpiRobs\02_原始论文与打印模型\打印模型\A1_仓库示例打印工程.3mf` | `8E4E193DA0608F56722A52F8C1FCC26A2C75160A9177741B40C13182350AA8DB` | 工程设置记录 A1、0.4 mm 喷嘴、0.2 mm 层高、2 圈外墙、支撑启用（`normal(manual)`）、5 mm 自动 brim、15% grid 填充和 eSUN TPU 95A 配置。 |
| `Open-Spiral-Robots\Open-Spiral-Robots-code\fabrication\example\spi_rob_3dprinting.3mf` | `8E4E193DA0608F56722A52F8C1FCC26A2C75160A9177741B40C13182350AA8DB` | 与上方 A1 工程 SHA-256 相同，文件内容完全一致，应视为同一份工程文件而不是独立复现。 |
| `Open-Spiral-Robots\Open-Spiral-Robots-code\fabrication\example\_split_test2\split_report.json` | `0AC3947E86EB87864B645EB83271151CACE23BDDD5BF9A3E649C73948366165A` | 报告对象是 `baselink.stl`，沿 Z 切为 4 段；报告中的各段均落在 256×256×256 mm 打印空间内。这是切分报告样例，不是软臂打印验证。 |

STL 文件本身不声明单位。X1 3MF 内嵌模型明确使用 mm，包围盒与双缆 STL 一致到约 0.001 个坐标单位；这支持按 mm 解读该 STL，但两者三角面数不同，不能据此声称网格逐面相同。制造前仍须在 CAD/切片软件中确认比例和朝向。上述哈希用于源文件追溯，不能证明几何、材料或打印结果正确。

## 2. 对 B32 可借鉴的内容

- **双缆与三缆模型用于形态对照。** 可在坐标对齐后比较软臂外轮廓、段长比例、弯曲空间和可视化表达；不能据此把双缆方案的缆线布局、孔道或结构尺寸直接移入三缆 B32。
- **论文参数仍是 B32 几何依据。** 本资料包中的 B32 目标为约 550 mm、三根缆线按 0°/120°/240°布置。外部三缆 STL 只提供定性参考；它的绝对原点远离零点，且目前没有确认它与论文尺寸、材料和驱动参数逐项一致。参见[《B32 水下驱动参数推导论文》](B32水下驱动参数推导论文.md)。
- **打印工艺应先做短样。** 3MF 中的 TPU、支撑、外墙和填充配置可作为复现实验的起点。实际采用前先确认打印机、喷嘴、耗材牌号/批次、切片版本与模型材料槽，再用已有的 80 mm TPU 工艺短样记录尺寸、挤出稳定性、孔道通畅和弯折恢复；不要把某台机器的配置当作 B32 的通用工艺参数。

## 3. 对 3.0 候选可借鉴的内容

- **借鉴切片记录方法。** 保存 3MF 时同时记录打印机/喷嘴、层高、材料、墙数、支撑、brim、填充和切片版本；每轮打印用打印记录表对应到模型哈希，便于复现和比较。
- **借鉴先算打印空间、再决定分件的流程。** `split_report.json` 展示了逐段包围盒与打印空间核对；但它切的是 `baselink.stl`，不能证明 3.0 软臂或一体打印候选能打印。
- **分件样例没有连接结构。** 配套 `fabrication/README.md` 明确说明当前切分只做几何裁切，没有定位销、键槽、燕尾或卡扣。它能启发分件边界与空间审查，不能作为可装配接头或承载能力的证据。
- **不把外部 STL 并入 3.0。** 3.0 的一体化网格/STEP 审查仍按自己的结构、绳路、壁厚、锚点和打印方向分别验证；外部模型与本项目的功能边界及拓扑不同，不能替代这些检查。

## 4. 迁移边界与下一步证据

| 项目 | 当前可确认 | 尚未确认 |
|---|---|---|
| 外部软臂 STL | 网格面数、坐标包围盒和文件哈希 | STL 单位、论文参数对应关系、内孔/绳路尺寸、可制造性及实物性能 |
| 3MF 工程 | 文件内保存的机器/喷嘴和切片参数；两份 A1 文件内容相同 | 外部模型是否按目标 TPU 槽切片、项目在本机切片器中的兼容性、实际打印质量 |
| 分件样例 | `baselink.stl` 分段的报告尺寸与报告内打印空间判断 | 软臂分件可装配性、接头强度、绳路连续性和水下可靠性 |
| B32 / 3.0 | 各自的既有设计基线与审查边界 | 本文没有更改或验证其几何、仿真、密封、压力性能或打印性能 |

建议下一轮先在 CAD/切片器中复核外部网格比例、坐标对齐和截面，再针对 B32 原模型打印短样并填写现有实测表；3.0 则只把切片参数、打印空间核对和分件记录方法迁入自己的验证流程。只有取得实测结果后，才讨论是否需要另开几何变更候选。本文不授权或记录任何几何迁移。
