songgagav/spiral_soft_arm/local/spiral-soft-arm/preprint/underwater_prototype_v1/docs/打印前与实物实验指南.md

# B32 水下三缆软臂打印前与实物实验资料包

版本：1.1  日期：2026-10-14  长度单位：mm

本资料包汇集了既有 B32 连续 TPU 臂体、两个 80 mm 工艺短样和三路湿侧安装件包络模型，供打印前核对、样件打样和后续实物实验记录使用。B32 臂体保持原模型；湿侧电机托座按 ApisQueen 4092 的外形包络估算。当前资料适用于原型尺寸评审，不是生产放行文件。

## 当前模型状态

| 项目 | 当前状态 | 关键尺寸或限制 |
|---|---|---|
| B32 软臂主体 | 原有一体式 TPU 模型，未修改 | STL 包围盒约 66.656 × 59.500 × 550.014；打印工艺仍需先通过短样 |
| TPU 工艺短样 | 基部和尖端各 80 mm | 建议先切片、打印、穿线、低张力弯折并记录回弹 |
| 湿侧电机布局 | 3 台，120° 均布 | 电机包络代理为直径 42、长度 92；电机安装接口尚未实测 |
| 湿侧打印件 | 9 个闭合 STL 网格 | 1 块底板、2 个根部压环、6 个电机托座；闭合网格不表示水密或承载合格 |
| 装配 STEP | 完整包络装配 19 个实体；安装件 STEP 9 个实体 | 电机、线轮和部分间隙是代理几何，STEP 用于检查布局，不要把整装模型当单件切片 |
| 线轮及输出轴 | 未形成可打印的实物接口模型 | 轴端、键/花键、轴承、联轴器、固线方式需按实物重新设计 |
| 水下抓取仿真 | 四工况均未完成目标抬升 | 仿真末端未接触目标；单根缆绳限力 0.15 N 是仿真设定，不是实物安全额定值 |

## 资料包目录

- `models/arm/`：550 mm B32 臂体 STL/STEP 和两个 80 mm TPU 工艺短样 STL。
- `models/wet_side/stl/`：底板、根部压环和六个电机托座的独立 STL。
- `models/wet_side/step/`：湿侧安装件和完整包络装配 STEP。
- `models/wet_side/preview/`：布局预览图。
- `models/wet_side/source/`：安装件参数和 CAD 生成脚本，供测量电机后更新尺寸。
- `docs/`：打印工艺说明、水下驱动论文、最终参数、仿真评估报告和 CAD 验收记录。
- `forms/`：电机接口实测表、打印过程记录表、水下试验记录表和打样 BOM。

## 打印和装配顺序

1. **先打 TPU 短样。** 按 `docs/打印工艺要求.md` 检查切片预览、三条腱道、薄壁连续性和支撑设置。短样文件按毫米导入，比例保持 100%。按该批 TPU 的数据表干燥；使用外置/后置料盘时确认转动顺畅，并记录切片软件与配置、模型 SHA-256、实际尺寸、冷却后无载尖端偏移和逐路穿线力。尖端孔道较紧时用细钢丝作牵引引导，穿线失败或损伤须先处理短样工艺。
2. **先量电机，再决定托座是否能直接试装。** 将实测外径、长度、安装面、轴型、轴径和轴伸填写到 `forms/电机接口实测表.csv`。4092 的当前 STEP/STL 只按 42 × 92 mm 包络建模；实测不符时应修改 `models/wet_side/source/parameters.json` 并重新生成托座。
3. **托座仅作配合打样。** 湿侧 STL 可按 100% 比例导入切片器。先打印一组或局部托座核对实物外壳和底板孔位，再决定是否打印整套。当前尚未指定托座材料、层向、壁数或螺钉长度；应按打印机、材料和实际装配厚度记录，不能从包络模型推断水下强度。
4. **按实物完善传动。** 当前没有经过轴端核验的线轮打印件。电机轴、独立轴承、线轮、联轴器、出线导向、缆线锚点和防松方式需要按样机尺寸完成 CAD 校核后再制造。
5. **先做干式低速台架试验。** 对每条腱线分别建立刚好消除松弛的无负载零点，再以测力计逐路校准命令、线轮角度、收线行程和实际缆绳张力。用短样进行可重复的低张力分步收线/释放，记录每路初始松弛、回差、实际行程和回弹；稳定重复后再采用该路的实测补偿量。设置硬件行程限位、过流保护、急停和线轮防护。MuJoCo 的 0.15 N 是模型限力输入，实物张力限值须经传感器和台架试验确定。
6. **再进入水下工况。** 记录淡水/海水及 1 m/5 m 条件。5 m 约为 49–50 kPa 表压；运动仿真不代替压力舱结构校核、保压和渗漏测试。建议先完成 1 m 受控浸水，再按已验证的压力试验规程进行 5 m 验证。

## 布局与紧固件参考

- 电机中心半径约 64 mm，三路夹角 120°；当前电机包络质量代理为 310 g/台。
- 底板外径 180 mm、厚 8 mm；底板有 6 个 M4 夹具孔。
- 6 个电机托座共 12 个 M3 通孔；根部压环分为 A/B 两片，共 4 个 M3 固定孔。
- CAD 包络检查记录的最小间隙：电机间 28.48 mm、电机到板 4.50 mm、电机到臂体 24.42 mm、根部压环到臂体 1.75 mm。根部间隙较小，应在实物配合时重点检查打印公差和臂体变形。
- 螺钉长度、螺母/垫片组合和螺纹啮合长度尚未冻结；按实际叠层量取并记录。

## 实物试验记录

请使用 `forms/打印过程记录模板.csv` 记录打印参数；每次水试验单独填写 `forms/水下试验记录模板.csv`。模板预置了淡水/海水与 1 m/5 m 四种计划工况，状态均为“未执行”。将电机型号、样机编号、测力计校准、实际压力、漏水观察、线缆张力、线轮行程、温升、接触和抬升结果一并记录。

现有四工况仿真没有实现目标接触和 5 mm 抬升，所以应把第一次实物动作当作低能量、可急停的台架标定；确认路径和张力之后再尝试抓取。真实压力和密封验证需独立记录，不能用 MuJoCo 结果替代。
