songgagav/spiral_soft_arm/local/spiral-soft-arm/preprint/underwater_prototype_v1/docs/打印工艺要求.md

# B32 论文式主体与工艺短样打印要求

## 文件和方向

- 主体：`model/B32_550mm_SpiRobs_打印实体.stl`，名义尺寸 66.656×59.500×550.014 mm。
- 先行短样：`process_coupons/B32_基部80mm_TPU工艺短样.stl`、`process_coupons/B32_尖端80mm_TPU工艺短样.stl`。
- 材料：TPU 95A。基部在 Z=0，尖端在 +Z；短样按文件坐标放置，不额外缩放。
- 先让供应商检查短样切片，再决定全长竖直打印的稳定性。全长件需要覆盖约 551 mm 高度并留裙边/固定余量；请确认有效成型空间、长时打印稳定性和 TPU 送丝能力。

## 切片验收

1. 切片器比例保持 100%，单位按 mm 解释。
2. 检查三条腱孔全程贯通；不得放置内部支撑或让自动修复填塞腱道。
3. 检查尖端细轴和各离散单元薄壁在预览中连续可见；若切片器丢失薄壁，不可通过加“实体填充”掩盖，应先评估该打印机和喷嘴能否实现。
4. 供应商提供短样切片预览、预计打印时间、切片重量与关键工艺参数；不得用 CAD 实体质量乘填充率估算打印重量。
5. 首先完成 80 mm 短样。检查尺寸、孔道、穿线力、低张力弯折和回弹，再决定全长打印。

## 材料数据和工艺起点

Polymaker 的 PolyFlex TPU95 数据表给出 XY 打印拉伸试样的杨氏模量 33.6±0.9 MPa、密度 1.20–1.24 g/cm³，并给出材料干燥 70°C/8 h 的建议。数据表明确典型值仅供参考，且基于特定试样和测试方向；它不是本机械臂中央细轴的实测刚度或承载许用值。喷嘴温度 210–230°C、热床 25–60°C、30–50 mm/s 等也只是该数据表的参考范围，须由供应商按实际设备与材料批次确认。

打印记录至少包括材料品牌/批次、烘料条件、打印方向、喷嘴、层高、线宽、外墙数、速度、温度、风扇、支撑策略、切片重量和打印时长。无内部支撑时仍应检查悬垂/桥接区域。

## 参考研究可迁移的工艺检查

以下内容只转化为 B32 的制造检查点，不复制不同软臂的几何尺寸、打印参数或控制系数。

- **TPU 供料与干燥：** 按本批 TPU 的制造商数据表干燥，并记录实际温度、时长和批次。参考论文的 eSUN eTPU95A 打印采用外置/后置供料，不经 AMS，并要求料盘能够顺畅转动；这是该论文的工艺经验，不代表所有 TPU 的通用烘料设定。开打前观察挤出是否连续，并记录拉丝、吐料等异常。
- **短样穿线：** 原论文补充材料中的 0.5 mm UHMWPE 腱线是两缆样机的参考值；B32 腱线直径和材质仍须依据实际孔道尺寸、线材磨损和短样穿线结果选择。分别检查三条路线。尖端孔道较紧时，可先用细而挺的钢丝作引导，再牵引候选腱线；不要硬推腱线，也不要直接扩孔。用测力计逐路记录穿线峰值力，堵塞、刮伤或线材明显起毛均判为短样未通过。
- **打印偏斜基线：** 样件完全冷却并脱离支撑后，在无腱线张力的规定摆放方向测量尖端偏移和侧弯，先记录打印本身形成的形状基线，再进行弯折试验。TPU 的流动和冷却可能产生小的几何不对称，长件的重力也会影响静态形状。
- **逐路松弛校准：** 2025 年相关研究发现，打印材料弹性会带来腱线残余松弛，并通过逐根测量松弛量改进收放线校准。B32 应先在短样上逐路建立“刚好消除松弛”的无负载零点，再用低张力、可重复的分步收线/释放记录命令行程、实际行程、回差和回弹。只有重复测量稳定后，才记录并应用该路线自己的补偿量；不直接移植论文的数值或系数。

来源边界：SpiRobs 原始论文及补充说明（补充材料 S1）提供 TPU 供料和导引穿线经验；2025 年《Grasping by spiraling》提供材料变形、打印不对称和腱线松弛的校准经验。两者的软臂结构和任务与 B32 不同，数值只作为检查方法的来源。

## 重要限制

本 CAD 几何闭合只说明文件拓扑可用，不证明 0.78 mm 量级的尖端中央弹性轴能在指定打印工艺下连续成形，也不证明 100 g 负载、循环寿命或抓取能力。当前全长实体暂缓放行，先完成短样和张力安全校准。
