songgagav/spiral_soft_arm/local/spiral-soft-arm/solidworks/electronics_enclosure_v23_cable_and_seal_interfaces/README_三路M3508共用干仓.md

# 已由 v23 说明替代

本目录的当前设计、界面尺寸和限制请查看 [`README_拉索过渡与轴封接口.md`](README_拉索过渡与轴封接口.md)。

v22 的说明与审查结果保留在原 `electronics_enclosure_v22_m3508_three_channel` 目录，不应套用于 v23。
