songgagav/spiral_soft_arm/local/spiral-soft-arm/solidworks/electronics_enclosure_v16/README_大陆可采购减速电机与直角传动.md

# B32 v16：大陆可采购的原厂减速电机与干式直角传动

更新：2026-10-25。当前装配候选改用 **3 × DJI RoboMaster M3508 P19 原厂 19:1 减速电机 + 3 × C620 电调**。大疆有[中文产品页](https://www.robomaster.com/zh-CN/products/components/general/M3508)和大陆销售入口；大陆电商也有[同型号商品索引](https://www.jd.com/jiage/6527725327a5ec7ba41.html)。购买前仍要核对店铺、实时报价和库存。v15 的 M2006/C610 不是本版采购清单。

## 选型与尺寸

| 部件 | 本版选择 | 建模依据 |
| --- | --- | --- |
| 减速电机 | M3508 P19，24 V，原厂行星减速箱，3 N·m 持续最大输出扭矩（配 C620，25 °C 与正常散热） | [大疆产品页](https://www.robomaster.com/zh-CN/products/components/general/M3508)、[官方手册](https://rm-static.djicdn.com/robomasters/public/document/RoboMaster%20M3508%20P19%20Brushless%20DC%20Gear%20Motor%20V1.0.pdf) |
| 电机安装 | Ø42 mm 机身；机身段 66.7 mm；总长 98.4 mm；前端 4 × M4、孔深 10 mm、孔圆 Ø35 mm；Ø10 mm D 形输出轴 | 同一官方手册第 10 页；CAD 使用保守圆柱包络，不复制厂家齿形 |
| 电调 | C620 ×3；49.4 × 25.8 × 11.5 mm（不含线）；24 V，CAN 指令或 PWM，最大持续电流 20 A | [大疆产品页](https://www.robomaster.com/zh-CN/products/components/general/M3508) |
| 直角齿轮 | KHK MMSA1.5-20R + MMSA1.5-20L，模数 1.5、20 齿、1:1，成对反旋向；Ø10 mm 孔，外径 31.9 mm，安装距 28 mm | [KHK 齿轮目录](https://khkgears.net/pdf/2025/miter-gears.pdf) |
| 输入轴、输出轴 | 独立 Ø10 mm 金属轴；两轴均在干式齿轮舱内安装齿轮，电机输出经 Ø10→Ø10 夹紧联轴器连接输入轴 | 布置尺寸候选；轴材、键/紧定方式和公差待实物定型 |
| 输入轴承 | SKF 6000-2RS1，10 × 26 × 8 mm | [SKF 规格](https://www.emarketplace.in.skf.com/deep-groove-ball-bearing/6000-2rs1) |
| 输出轴承 | SKF 3200 ATN9，双列角接触，10 × 30 × 14 mm；用于水平线盘轴的径向和轴向支承 | [SKF 目录](https://cdn.skfmediahub.skf.com/api/public/0901d196802809de/pdf_preview_medium/0901d196802809de_pdf_preview_medium.pdf) |
| 湿侧旋转轴封 | 10 × 22 × 7 mm HMSA10 RG 作为骨架油封**尺寸候选**，前侧保留迷宫缝 | [SKF 尺寸资料](https://cdn.skfmediahub.skf.com/api/public/0901d196802a343c/pdf_preview_medium/6234_5_EN_Maximizing_performance_pdf_preview_medium.pdf) |

M2006/C610 的厂家标称持续最大扭矩为 1 N·m；本版 M3508/C620 为 3 N·m。这个数字是驱动能力上限，**不是**软臂或拉索允许张力。Ø6.5 mm 卷芯如果直接用满 3 N·m，理论张力会很高，必须根据实测软臂载荷设定电流和拉索张力上限。

## 装配路线

电机、C620、两只直角齿轮、联轴器和轴承位于共用干仓；只有线盘及其短段 Ø10 mm 轴暴露在水中。三台电机竖装，减速电机前端通过 Ø35 mm 孔圆的四颗 M4 螺钉固定在顶盖的可拆安装座。Ø10 mm D 轴经独立夹紧联轴器驱动竖直输入轴；成对 1:1 伞齿轮把旋转转至水平切向线盘轴。水平轴从干仓依次穿过双列角接触轴承、骨架油封座与外侧迷宫缝后连接线盘。

线盘轴在俯视图中与机械臂对应拉索的径向投影垂直。卷芯切点至 250 mm 六边形顶盘倒角线孔为单段直线，当前几何长度约 **13.76 mm**；三处线孔与臂根通道方向保持一致，无导向轮。第 6、第 13 关节内部的燕尾榫分段沿用现有 B32 几何。

顶盖连三只齿轮舱作为一个打印件；每舱上盖独立拆卸，前端电机在共用干仓内拆装。线盘可从湿侧卸下，再更换轴封与输出轴承。现有 STEP 中齿轮只给出商品**最大外形包络**，没有假造可打印齿形；采购后应导入厂家 STEP 并确认齿侧隙、旋向、轴向定位及润滑。

## 电气与功率边界

C620 需与 M3508 以三相线及 7-Pin 数据线成套连接；STM32 可以通过本地 CAN 或 PWM 控制 C620。岸上 CAN 与舱内 C620 总线应分别配置收发器、终端及故障隔离。供电采用岸电直供电机主路、UPS 保持控制、备电限流的结构：三台电机在厂家额定工作点约需 30 A，因此岸上电源及主路建议至少 35 A 连续；原 24 V/15 A 稳压器位于电池备电支路，不足以承担三台满额电机负载。当前供电拓扑将备电总输出限制在 10 A，K2 应急电机支路限制在 5 A，且一次只允许单台低速动作；现有 4 mm²、5 m 脐带缆若保留，主路还应限流。详见[供电拓扑与接口说明](../../hardware/M3508_C620_供电拓扑重规划_2026-10-25.md)。电源额定、总线限流和动作时序仍需按实物核定，并进行 30 分钟温升与 15 分钟断岸电试验；当前 CAD 不证明这些功能。

4S 电池支持岸上隔离 24 V 与 USB‑C PD 两路充电输入：通过岸电优先的防反灌选源级，共用 16.8 V CC/CV 充电级与 BMS。Type‑C PD 还分支接 UPS AUX；两个负载共用 PD 协商功率并动态限流。岸电或 Type‑C 任一有效时关闭电池升压器，外部电源均失效才启用备电升压。

## 文件及验证状态

- [总装 STEP](B32_v16_减速电机直角传动总装.step)：独立零件装配，包括三台电机、三块 C620、传动轴、轴承、轴封、齿轮包络、共用干仓与机械臂。
- [半透明总装预览](B32_v16_半透明总装预览.png)：显示干仓内部与湿侧线盘。
- [线盘线孔俯视](B32_v16_线盘线孔俯视.png)：检查转轴方向与三条直线切线出线。
- [参数](parameters.json)、[布置审计](装配布置审计.json)、[生成脚本](generate_gearmotor_drive.py)和 [SHA-256 清单](SHA256SUMS.csv)用于复核版本。

脚本输出确认当前**电机、关键电子件及仓筒**未出现体积相交，三根切线与预定线孔对齐，所有指定打印件处于 350 × 350 × 250 mm 有效包络内。模型尚未完成商品齿形、轴承寿命、油封压装公差、5 m 淡/海水静压、潮湿腐蚀、热管理、线缆弯曲半径和切片工艺验证，不能据此直接放行打印或水下使用。

轴封的 10 × 22 × 7 mm 型号仅为安装空间基准。此处约 5 m 水深接近[普通径向油封产品范围所列的 0.5 bar 压差上限](https://www.trelleborg.com/seals/-/media/tss-media-repository/tss_website/pdf-and-other-literature/catalogs/product_range_en.pdf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)，海水还会影响弹簧和轴表面；最终需要厂家确认材料、压差、旋向及安装方向，并做静态与旋转浸水试验。
