songgagav/spiral_soft_arm/local/spiral-soft-arm/solidworks/electronics_enclosure_v14/README_物理布置优化.md

# B32 v14：电机、线盘与电子仓物理布置候选

本版延续三台 DJI RoboMaster M2006 P36 共用一个干仓的方案。三只电机竖装在可拆顶盖下方，线盘位于顶盖与 250 mm 六边形顶盘之间的开放湿侧。卷筒切点、顶盘线孔及机械臂根部拉索通道在俯视图中沿同一条径向线；三处线孔均为 Ø4.2 mm 通孔，双面 1.5 × 45° 倒角。软臂仍在第 6、第 13 关节**内部**用燕尾榫分段。

## 本版修正的实体冲突

- 将原电子堆栈整体下移 20 mm，并把干仓直筒延长至 211 mm。旧版 21700 电池及电池架穿入顶盖的冲突已消除。
- 将电机中心半径由 70.5 mm 调整为 72.5 mm，给 STM32 板件留出空间；转接板外径收至 38 mm，避免与干仓内壁相交。电机主体、安装转接板和所有关键电子件之间无实体相交。
- 原电池支撑柱穿过稳压器空间，现移到电池托盘外侧，经加宽的两处托盘耳与电池架相连。托盘、支柱和底部服务板形成可见的载荷路径。
- Type-C 接口包络移至仓壁开口。岸上供电缆由底盖偏心格兰头进入，服务板留有过线孔，按 Ø10 mm 通道代理绕开电子件接至 UPS 附近。
- 六根独立顶盘支柱连接可拆顶盖和顶盘，每根预留 M3 螺钉通道；此前悬空的顶盘现在有装配支撑。
- 控制板一处上支柱与第三台电机转接板冲突，现用短偏置连接片将该支柱移向中心，并在顶盖底面预留盲孔固定。

## 电机、轴系和检修

M2006 按厂商最大包络 Ø24.4 × 64.8 mm、Ø6 mm 输出轴、19 mm PCD 的三处 M3 安装孔建模。电机经三孔转接板和三根间隔柱固定在顶盖干侧。每台电机经干侧分阶联轴器驱动独立 Ø8 mm 线盘轴；独立轴由顶盖中的 8×22×7 mm 轴承代理定位，穿过 8×16×5 mm 骨架油封和迷宫结构，连接湿侧线盘。卷筒径向载荷的设计路径是线盘→独立轴→轴承→顶盖，避免直接由电机输出轴承担侧载。

顶盖上另预留轴承压板、骨架油封座、静密封圈座和螺钉孔。轴封及 O 形圈均为**尺寸占位**，未确定实际型号、槽公差、预压量、轴表面状态、轴向止推及 5 m 水深的密封能力。装配顺序候选：先在顶盖安装电机/转接板、轴承与轴封，再安装独立轴和联轴器，固定顶盖及支柱，最后装湿侧线盘和顶盘。底盖单独打开可检修电子件。拆装时仍须实物确认工具可达性、紧固扭矩及防松。

## 电子件位置

CAD 中保留四节 21700 电芯、电池架、三只 C610、电压稳压器、STM32 板、UPS 板、升压和 Type-C 输入模块的占位包络及相应支撑件。它们仅表示已给出的外形尺寸与安装空间；接线端子、实际散热器、接插件弯曲半径、BMS/保险和线束固定件尚须按购买件核实。端子朝向和线束长度不应从简化包络推断。

| 项目 | 本版几何尺寸/位置 |
| --- | --- |
| 顶盘 | 六边形，对角最大 250 mm |
| 干仓直筒 | 外径 200 mm、内径 188 mm、高 211 mm；法兰最大约 212 mm |
| 电机中心 | 俯视中心径向 72.5 mm、切向偏移 6.5 mm |
| 线盘切点至线孔 | 俯视约 41.9 mm；按当前高度差三维约 42.9 mm |
| 顶盘支柱 | 半径 95 mm 处 6 根，长 28 mm，Ø10 mm 外形/M3 通孔 |
| 机械臂分段 | 183.48、185.12、200.05 mm |
| 打印机边界 | 用户提供 350×350×320 mm；按 250 mm 有效高度核对各独立打印件 |

## 自动几何核对范围

`装配布置审计.json` 记录顶盘孔与真实臂根孔的探针结果、线盘切线误差、关键实体包络碰撞、线缆预留通道与支撑件碰撞、以及各打印件包络。当前脚本对这些指定对象要求交叠体积为零；支柱与托盘、托盘与电池架等为有意的结构连接，不作为冲突。STEP 总装中同时保留黄色线缆空间代理，便于进一步审查。

这些结果仅证明**当前简化几何模型**的静态空间排列。线盘实际排线、卷索直径与张力、材料强度、榫卯承载、密封、水压、浮力、散热、可制造公差及实际硬件接插件仍未验证。本版不能作为打印放行或下水放行。

## 文件

- `B32_v14_物理装配优化总装.step`：包含软臂、干仓、轴系、电子件、安装支撑和线缆空间代理的总装。
- `B32_v14_半透明总装预览.png`：整机和根部近景，仓壁及包覆件半透明。
- `B32_v14_线盘线孔俯视.png`：三路线盘切线、线孔、支柱和顶盘方位。
- `B32_v14_线孔双面倒角剖面.png`：通孔及双面倒角尺寸。
- `parameters.json`、`generate_physical_layout.py`：可再生成的参数与建模脚本。
- `装配布置审计.json`：审计结果；`SHA256SUMS.csv`：文件校验值。

电机尺寸来源：[RoboMaster M2006 P36 官方产品页](https://www.robomaster.com/en-US/products/components/detail/1277)和[官方使用说明书](https://cdn-hz.robomaster.com/tem/RM%20M2006%20P36%E7%9B%B4%E6%B5%81%E6%97%A0%E5%88%B7%E5%87%8F%E9%80%9F%E7%94%B5%E6%9C%BA%E4%BD%BF%E7%94%A8%E8%AF%B4%E6%98%8E%20%E5%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)。
