songgagav/spiral_soft_arm/local/spiral-soft-arm/solidworks/electronics_enclosure_v13/README_紧凑竖装共用干仓.md

# B32 v13：紧凑竖装共用干仓候选

本轮把三台 DJI RoboMaster M2006 P36 竖装在同一个圆筒干仓内。电机、C610、STM32、21700 电池和电源板位于干侧，三只线盘位于顶盘下方的开放湿侧。相比 v12，取消了三个外伸电机筒和三条干侧接线管；干仓主体是一只直筒，顶部为可拆安装板，底部保留检修盖。外部仅保留六片短平面观察罩和机械臂根部护罩。

## 尺寸和装配

| 项目 | v13 建模值 |
| --- | --- |
| M2006 厂商外形包络 | 直径 24.4 mm、轴向总长 64.8 mm、输出轴直径 6 mm |
| 电机安装接口 | 19 mm PCD 的三处 M3；螺纹深度以厂商图纸为准 |
| 共用干仓 | 外径 192 mm，内径 180 mm，直筒高 186 mm；顶部法兰最大直径 204 mm |
| 顶盘 | 250 mm 六边形，三只拉索孔保留双面倒角 |
| 拉索孔倒角 | 三孔均为 Ø4.2 mm 通孔；上、下孔口均扩大至 Ø7.2 mm，深 1.5 mm，45° 倒角 |
| 电机/线盘中心 | 俯视沿每条拉索方向径向 70.5 mm，切向偏移 6.5 mm，使卷筒切点落在拉索孔的径向线上 |
| 线盘到线孔 | 俯视直线约 39.9 mm；按当前高度差的三维直线约 40.95 mm |
| 分段软臂 | 原第 6、第 13 关节内部燕尾榫分段保持；三段高度约 183.48、185.12、200.05 mm |

干仓直筒、顶盖、底盖、250 mm 顶盘和软臂各段均低于现有 250 mm 有效成型高度。顶盖有八处螺钉孔和静密封座代理；每台电机通过小型安装板固定在顶盖下方，输出轴经独立轴、轴承、骨架油封和迷宫环的代理结构驱动湿侧线盘。独立轴用于承担卷筒载荷，避免将卷筒侧向力直接交给电机输出轴。拆下外部六片短平板和六边形顶盘、松开三只湿侧线盘后，可从顶部取出电机安装组件；底部盖可单独检修电源和控制板。

### 拉索直线对齐核对

每路卷筒中心沿对应孔的切向偏移一个卷芯半径（6.5 mm），使出线切点、顶盘孔中心和机械臂根部拉索开口在俯视图中位于同一条径向直线上。出线段从卷芯切点直接连到孔口；该线段对竖直卷芯圆柱面的法向点积为零，因此在三维空间也是切线。拉索在孔口之后进入机械臂纵向通道，孔口过渡处的实际弯曲半径仍须用实物确认。

本轮检查发现旧版模型的软臂根部开口相对顶盘孔偏转了 60°，已将软臂和燕尾榫锁销同步旋转至正确方位。生成脚本现在直接用软臂根部实体截面检查三处孔位：孔中心半径 1.5 mm、轴向 5 mm 的探针与实体相交体积均为 0；各孔旁偏 30° 的对照探针均与实体相交，以排除探针落在臂外的假阳性。顶盘孔探针与实体相交体积均为 0，三路卷芯切线法向误差均为 0。数值见 `装配布置审计.json`。

三处顶盘线孔在上下两侧均做 **1.5 × 45° 倒角**。模型截面另用探针检查：距中心 3.0 mm 的点在上下孔口为空，在板厚中段仍是实体，确认保留了 Ø4.2 mm 直通段。倒角减少入口锐边，但线缆在湿侧入口向臂内纵向通道转向时的实际接触半径及磨损仍需用实物检查。

厂商尺寸来源：[RoboMaster M2006 P36 官方产品页](https://www.robomaster.com/en-US/products/components/detail/1277)、[官方使用说明书](https://cdn-hz.robomaster.com/tem/RM%20M2006%20P36%E7%9B%B4%E6%B5%81%E6%97%A0%E5%88%B7%E5%87%8F%E9%80%9F%E7%94%B5%E6%9C%BA%E4%BD%BF%E7%94%A8%E8%AF%B4%E6%98%8E%20%E5%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)。模型中的电机最大外径、总长和轴径直接使用厂商值；机壳细部、接头、线束和安装板仍为简化占位。仓库中的厂商 STEP 为开放曲面参考件，未作为可加工实体直接并入。

## 文件

- `B32_v13_M2006竖装共用干仓总装.step`：可打开的整机装配候选，包括干仓、轴系、线盘、电子件包络和软臂。
- `B32_v13_紧凑竖装总装预览.png`：左右分别为整机和半透明根部近景。
- `B32_v13_线盘线孔俯视.png`：标出线盘切线、线孔、六边形顶盘和主要板件包络。
- `B32_v13_线孔双面倒角剖面.png`：三处拉索孔通用的双面倒角尺寸图。
- `parameters.json` 与 `generate_compact_vertical_drive.py`：可再生成的参数和脚本。
- `装配布置审计.json`：静态包络、间隙与打印高度数据。
- `SHA256SUMS.csv`：目录文件校验值。

## 仍需实物定型

模型审计只证明所选包络在静态 CAD 中可排开。当前电机与最近电子板的净空约 5 mm，还需实物测量线束弯曲空间和插头方向。8×16×5 mm 油封、8×22×7 mm 轴承、独立轴、联轴器、安装螺钉、O 形圈、Type-C 穿舱接头和岸上供电缆格兰头均只按包络占位。需先确定实际购买件、轴封唇口方向/配合粗糙度/压装尺寸、轴向止推、螺钉有效啮合深度、静密封槽尺寸和检修拆装次序。还需确认卷筒排线宽度及出线高度不会磨到上下挡边，再进行切片、样件、压力和水下验证。本 STEP 不是打印或 5 m 水下使用放行文件。
