songgagav/spiral_soft_arm/local/spiral-soft-arm/solidworks/electronics_enclosure_v12/README_共用隔水电机仓.md

# B32 v12：M2006 共用隔水电机仓

更新：2026-10-24。三台 DJI RoboMaster M2006 P36 不具备浸水工作条件。本版将它们收进同一套相互连通的干侧空间，三只线盘仍位于湿侧。v11 作为旧候选保留，不能用其外伸电机筒预览判断本版布置。

## 干湿边界与布置

```text
湿侧拉索、线盘 ×3
    │  每轴：迷宫前室 → 骨架油封占位 → 独立轴承/Ø8 轴
    ▼
干侧 M2006 ×3（水平，透明显示在 Ø40 电机舱瓣内）
    │  后端盖底部干侧穿线通道 ×3
    ▼
中央电子仓（C610 ×3、STM32、UPS、电池等占位）
    │
岸上电源/通信线缆穿舱件占位
```

电机舱瓣各有封闭后盖；原 v11 后盖的轴向直通孔在本版取消。后盖底部经三条 Ø12/Ø6 mm 外/内径代理管接到中央电子仓侧面原有接线口。每条管与后盖、电子仓壳体的静密封及可拆接口尚未选型。中央电子仓侧面原有观察槽已封闭；外部半透明平板面板仍可开窗观察和排水，它**不承担隔水功能**。

六边形顶盘外接圆直径仍为 250 mm。线盘中心移至约 55 mm 径向位置，电机中心约为 55 mm 径向 + 64 mm 切向偏置。三台电机水平排列；线盘切线出线、顶盘线孔与对应机械臂拉索孔继续在一条直线路径上。下方电子仓整体下移 45 mm，给电机层与湿侧拉索通道让出空间。三根带盲孔的可拆支柱把电子仓与顶盘连接，避免接线管承担仓体重量。外罩加宽后的顶盘安装耳和面板拼接片也同步延长，保留 M3 安装孔代理。外部通风观察罩上部略宽于顶盘，最大横向包络仍小于打印机 350 mm 平台；它与顶盘不是同一尺寸约束。

## 本轮文件

| 文件 | 用途 |
| --- | --- |
| `B32_M2006共用隔水仓_湿侧线盘总装.step` | 整机、三电机、共用干侧连接管、轴封/轴承及线盘的分件 STEP 总装 |
| `B32_M2006共用隔水仓_总装预览.png` | 半透明外罩和干仓、电机位置、湿侧线盘的总装与局部预览 |
| `B32_M2006共用隔水仓_俯视与轴封.png` | 三轴俯视和单轴密封堆栈示意 |
| `装配布置审计.json` | 关节分段、出线路径和主要静态间隙记录 |
| `parameters.json`、`generate_shared_dry_chamber.py`、`SHA256SUMS.csv` | 尺寸输入、可再生成脚本和文件哈希 |

## 几何检查结果

- 三段软臂高度约为 183.5、185.1、200.0 mm，低于既定 250 mm 有效成型高度。
- 中央电子仓壳体包围盒约 151.1 × 150.0 × 222.1 mm；最长外罩面板约 206.1 mm。六边形顶盘外接圆直径 250 mm，连同安装耳的包围盒约 249.6 × 262.1 × 28.0 mm；装配状态的外罩约 285.5 × 330.4 × 281.3 mm。单件均在已确认的 350 × 350 × 320 mm 打印体积内，但切片方向和支撑尚未确认。
- 每条线盘出口至顶盘线孔的示意直线路径约 32.34 mm；三条路径的点线共线误差在生成审计精度下为 0 mm。
- 三处电机舱瓣与顶盘、半透明外罩的实体交叠为 0；三条干侧接线管与电子仓有实体连接，与电机实体无交叠；三只湿侧线盘与电子仓无交叠。三根支柱与电机舱瓣也无交叠。

以上是**静态 CAD 占位检查**。拉索直径、绕线层变化及实际拉动时的接触/弯曲仍需实测。

## 实物定型前必须补齐

1. Ø8 独立轴、支承轴承、联轴器、Ø8 × Ø16 × 5 mm 油封占位均需按实际购件和电机 D 轴尺寸重新设计。电机输出 D 轴不得直接承担线盘的侧向或过大轴向载荷。
2. 三处旋转轴封必须按 5 m 水深、海水、轴表面粗糙度与转速选型。迷宫结构只用于减少颗粒/水流冲击，不能代替骨架油封压力边界。
3. 三个后端盖、三条布线管的两端、电子仓底盖与岸缆入口都缺少已定型 O 形圈槽、压缩率、螺钉预紧和采购件接口。水密性、泄漏路径和拆装后的重复密封尚未验证。
4. 电子仓下移后应复核重心、浮力、外罩与支架固定、C610 散热和湿侧腐蚀隔离。
5. 只有完成尺寸复测、切片、样件、空仓压力/浸水、旋转轴封运转及整机试验后才能打印和下水放行。本版不宣称已达到 5 m 水深性能。

厂家参考：[DJI M2006 P36 / C610](https://www.robomaster.com/en-US/products/components/general/M2006)。
