songgagav/spiral_soft_arm/local/spiral-soft-arm/solidworks/electronics_enclosure_v11/README_M2006干式驱动与轴封.md

# B32 v11：M2006 干侧驱动与湿侧线盘

更新：2026-10-23。用户决定恢复三台 DJI RoboMaster M2006 P36，采用迷宫结构加骨架油封，电机与 C610 保持在干侧，线盘在湿侧。本目录是在 v10 之上的独立布置候选；v10 的三段软臂、关节内燕尾榫、250 mm 六边形顶盘、三条拉索切线出线及线孔倒角保持为几何基线。

## 新增结构

每轴按下列顺序布置：

`干式电机筒后盖/静态电缆入口 → M2006 P36 → 联轴器 → 独立圆轴及支承轴承 → 可更换油封座 → 润滑隔腔/迷宫间隙 → 湿侧线盘`

- M2006 代理采用厂家公布的 Ø24.4 × 64.8 mm 包络；输出 D 形轴为 Ø6 mm。C610 代理采用 50 × 22 × 7.3 mm，三块留在中央干仓，不再使用旧版的 mini ESC 代理。
- 三只 Ø40 mm 电机筒包住 M2006；独立 Ø8 mm 圆轴代理承受线盘侧载，避免把线盘悬挂在电机 D 轴上。Ø8 mm 圆轴、8 × 22 × 7 mm 轴承和 8 × 16 × 5 mm 骨架油封均为**空间占位**，不是最终采购选型。
- 后端盖留轴向电缆入口占位；每台电机至中央电子仓还需要一段额定水下电缆，以及两端各自的**静态密封穿线件**。现有模型仅表示孔与接口位置，没有完成电缆弯曲空间、接头和静态密封结构。
- 油封唇口与独立圆轴接触；电机 D 轴不作为油封接触面。湿侧迷宫留 0.5 mm 径向间隙，只作遮挡污染物和保护油封的第一道结构，不承担水密保证。
- 线盘、顶盘孔及臂内入口的投影仍沿同一牵引径向，线盘轴线垂直于出线方向。线孔保留 Ø4.2 mm 通孔和双面 0.8 mm 倒角。

## 本轮输出与审阅边界

- `B32_M2006干式电机_湿侧线盘总装.step`：整机与各轴密封组件的 STEP 总装；油封、轴承和联轴器为代理件。
- `B32_M2006干式驱动_总装预览.png`：整机与三段软臂拆解预览，外罩半透明。
- `B32_M2006干式电机与轴封布局.png`：三轴俯视及单轴剖面布局。
- `B32_燕尾榫与六边形顶盘细节.png`：沿用既有榫卯与顶盘几何的局部图。
- `parameters.json`、`generate_sealed_m2006.py`、`装配布置审计.json`：候选参数、生成脚本和几何布置记录。

生成记录显示，电机筒与中央仓的最小静态间隙约 8.16 mm；电机筒与顶盘、包覆面板没有实体体积重叠；三条切线出线段的直线偏差为零。三段机械臂高度仍低于用户给出的有效成型高度 250 mm。这些是 CAD 静态结果，不能代替实际装配或水密验证。电机筒有一部分超出 250 mm 顶盘平面范围，仍需检查打印尺寸、外罩与运输空间。

## 实物定型前必须确认

1. M2006 轴伸、机身后侧出线方向、固定面与 C610 线束实物尺寸；联轴器应有足够的 Ø6 D 轴与 Ø8 圆轴啮合长度。
2. 选用标明压力、转速和水介质工况的油封，核定 5 m 水深约 0.49 bar 的压差；确定轴表面硬度、粗糙度、径向跳动与骨架油封唇口润滑方式。
3. 设计可更换的精加工油封座、后盖静态 O 形圈槽、三根电机电缆和中央干仓的静态穿舱件；打印件的座孔尺寸及承压能力不能由这个外形代理确定。
4. 检查盐水接触件材质、电偶腐蚀、线盘绕线容量、轴承侧载、断电与卡线状态。C610 为 CAN 电流控制，不能沿用 4092 mini ESC 的 PWM 固件或接线图。

状态：**CAD 布置候选；不是 3D 打印放行件，不是 5 m 水密或海水运行证明。**

官方资料：[DJI M2006 P36 与 C610 规格](https://www.robomaster.com/en-US/products/components/general/M2006)；[Parker 旋转轴封设计指南](https://www.parker.com/content/dam/Parker-com/Literature/Engineered-Polymer-Systems/5350.pdf)。
