songgagav/spiral_soft_arm/local/spiral-soft-arm/solidworks/electronics_enclosure_v3/README_中央电子仓重画.md

# B32 中央电子仓重画候选（v3）

更新：2026-10-20。电子仓仍安装在机械臂根部中央，三台 ApisQueen 4092 电机留在湿侧外圈。本版依照用户提供的控制板、电调、UPS 模块和稳压器尺寸重排内部空间，增加 USB-C PD 输入与 24 V 升压支路，并加入 M3/M4/M5 多规格固定孔。

## 本版硬件尺寸与安装位置

| 元件 | 建模尺寸 / 位置 | 状态 |
| --- | --- | --- |
| ApisQueen 4092 配套 mini ESC | 圆柱 Ø3 × 25 mm，3 个，贴近各自电机出线口 | 尺寸为用户确认；厂家电调图纸、电流、接线和散热仍待确认 |
| STM32 控制板 | 152 × 87.5 × 18 mm，竖直安装在舱内 +X 侧 | 尺寸为用户确认；实际 PCB 孔距未知，使用可调导轨 |
| UPS 模块 | 52.8 × 32 × 18 mm，位于 +Y 侧并接入辅助输入线束 | 尺寸为用户确认；输入、切换和输出能力待核对数据表 |
| 稳压器 | 100 × 80 × 39 mm，竖直安装在舱内 -X 侧 | 尺寸为用户确认；输入/输出电压、电流和散热面待确认 |
| Type-C PD 输入板 | 28 × 20 × 5 mm 建模占位，靠近侧壁 Type-C 接口 | 28 × 20 mm 参考 EKM024；5 mm 厚度为用户确认，具体采购型号未确认 |
| 24 V 升压板 | 45 × 30 × 12 mm 建模占位，位于底部服务层 | 外形及额定功率为占位，待具体型号确定 |
| 电池 | 4 × 21700，单节 8000 mAh；当前按 4S1P 放置 | 容量为用户确认；电芯型号和持续放电倍率未确认 |
| 单节标称电压 | 3.7 V | 用户确认；4S1P 估算为 14.8 V |

## 拉索与线盘位置

有预留线盘位置：沿用三台湿侧电机输出端各一只卷筒代理，分别按 120° 分布在外圈，不在电子仓内另设中央线盘。当前代理外形为有效半径 6.5 mm、法兰外半径 10 mm、轴向宽 8 mm；电机轴连接、挡线法兰细节、绳槽和可绕线容量尚未按实物确认。

拉索路线按“电机侧卷筒 → 圆盘下方外侧导向 → 圆盘三处穿线孔 → 机械臂根部”建模。圆盘孔为 3 × Ø4.2 mm，分布半径 30.6 mm、角度 0°/120°/240°。这些孔和拉索均为几何代理，最终还需按实际拉索直径、弯曲半径、磨损衬套与张紧方式校核。

## 电子仓与螺丝接口

筒身外径 136 mm、内径 126 mm，顶部 z=-20 mm、筒身底部 z=-230 mm；底盖厚 10 mm，法兰外径 150 mm。三个 M4 顶部盲孔柱将仓体固定到底板。底盖法兰设置 12 个通孔，按圆周重复布置 4 个 M3（Ø3.3 mm）、4 个 M4（Ø4.3 mm）和 4 个 M5（Ø5.3 mm）净空孔；仓内 STM32 与稳压器导轨也提供 M3/M4/M5 多规格孔位。

电子板的实际固定孔距尚未取得，因此内部采用可调安装导轨；孔位不代表对应 PCB 已有同样的孔距。使用者需取得实物后再选定具体螺钉长度、垫片和锁紧方式。

## 供电与线束

1. 岸上隔离 24 V 电源进入 UPS 主输入。
2. 4 节电芯暂按 4S1P 接入 BMS，再接 UPS 电池输入。串联后仍为 8 Ah；按 3.7 V/节估算，标称约 14.8 V、118.4 Wh。
3. USB-C PD 输入板与独立 24 V 升压板串联，输出接到 UPS 辅助输入。用户已确认该支路用于辅助供电。需验证 UPS 是否允许多个输入同时接入，以及是否具有反灌保护。
4. UPS 输出分配给三路 12–24 V 电调；STM32 信号线与电机功率线分侧布置。稳压器与主控的具体电压/电流连接等拿到器件数据表后确认。

Type-C 参考模块 EKM024 可向 PD 电源请求 5/9/12/15/20 V，最高 3 A，板外廓 28 × 20 mm，安装孔距 23 × 15 mm；这不是升压器。ADI 的 USB-C PD 转 24 V 参考设计输出上限为 24 V、1 A（30 W），因此本图将 Type-C 支路限制为 UPS 辅助输入，不将其作为三台 80 W 电机的主供电。若更换为别的 PD/升压模块，需按其持续功率、线缆和 UPS 输入规格重新核算。

## 文件

- `B32_中心电子仓_三湿侧电机总装.step`：根部总装，保留机械臂与外圈湿侧电机。
- `B32_中心电子仓_拆解与接线.step`：电子仓、板件、支架与线束代理拆解。
- `B32_中心电子仓_总装与内部接线预览.png`：根部安装位置及内部布置预览。
- `B32_中心电子仓_安装剖面与接线图.png`：横截面、轴向分层和供电关系。
- `parameters.json`、`generate_centerline_canister.py`、`布局与干涉审计.json`：生成参数、可复现脚本和本轮几何检查记录。

## 放行边界

本版是元件外形与空间布局候选，不是防水或打印放行。Type-C 侧壁开口与插座只是接口代理，不能在水下直接使用；要另行选定额定深度/压力的密封穿舱件。电调的 Ø3 × 25 mm 外形依据用户输入，但其电流和热设计没有厂家数据。底盖密封槽、公差、螺纹嵌件、PCB 孔距、连接器、保险与反灌保护、24 V 电源切换、散热、5 m 淡水/海水耐压及 30 分钟运行均未实测验证。

## 资料来源

- EKM024 USB-C PD Trigger 模块规格：<https://docs.electrokit.com/en/modules/EKM024/index.html>
- ADI MAXREFDES1283 USB-C PD 输入转 24 V 参考设计：<https://www.analog.com/en/resources/reference-designs/maxrefdes1283.html>
