songgagav/spiral_soft_arm/local/spiral-soft-arm/solidworks/electronics_enclosure_v4/README_包覆与圆滑拉索.md

# B32 根部包覆与拉索改线（v4 几何候选）

更新：2026-10-20。参考用户提供的白色包覆外观图，重画根部外壳、俯视电机方向和三根拉索。参考图只用于外观和开窗关系，不作为尺寸或内部布置依据。v3 原文件保留，本目录为独立候选。

## 本轮修改

- 三台 ApisQueen 4092 的轴线仍沿圆盘切线。俯视图现按总装 STEP 的 Ø42 × 92 mm 电机包络绘成切向长形，卷筒也按同轴外形绘制，消除视图方向矛盾。电机和线盘都位于湿侧。
- 拉索从各自卷筒的正切向输出端出发，以连续样条曲线穿过圆盘上的对应孔位。圆盘孔为 3 × Ø4.2 mm，分布半径 30.6 mm，间隔 120°。已经去掉原来带直角折线的导向块代理；三维 STEP 与俯视预览由同一组曲线控制点生成。
- 根部外壳参考附图采用上宽下窄的包覆轮廓，分为两瓣，底部开放，三处湿侧电机开窗，Type-C 接口侧留通道。它是可拆的防护/外观件，不能代替内层密封电子仓。顶部提供 6 个 Ø4.5 mm 固定通孔；分瓣接缝提供 4 对 M3 螺钉座（+Y 侧 Ø3.3 净空孔，-Y 侧 Ø2.5 导孔代理）。接缝螺钉长度、螺纹嵌件和装配工具空间尚未用实物校核。

## 已完成的数字几何核查

- 三根路线相同，离散曲率估计的最小半径均为 **9.51 mm**；该值由中心线计算，尚未与实际拉索允许弯曲半径核对。
- 拉索与已建模的圆盘、电子仓外壁、电机包络、电机鞍座无体积交叉；包覆壳与电子仓、底盖、电机、线盘和拉索无体积交叉。
- 两瓣包覆壳各为一个有效 CAD 实体；总装和拆解 STEP 回读有效。上述检查不代表可打印、耐压、防水或水下长期可靠。

## 保留的电子硬件布局

中央干仓外径 136 mm、内径 126 mm，容纳 STM32 152 × 87.5 × 18 mm、UPS 52.8 × 32 × 18 mm、稳压器 100 × 80 × 39 mm、3 个 Ø3 × 25 mm 电调代理，以及 Type-C PD 辅助输入和 24 V 升压代理。电池为 4 节 21700，用户确认每节 8000 mAh 和标称 3.7 V，当前按 4S1P 排布。线盘有效半径 6.5 mm、法兰外半径 10 mm、轴向宽 8 mm，均属未取得厂家装配图的尺寸代理。

## 打印前仍需定值

实际电机输出轴和线盘连接方式、拉索材料及其允许弯曲半径、穿孔耐磨衬套、包覆壳材料与壁厚、螺钉/嵌件配合、水流与散热，以及 5 m 水深密封件和压力试验。特别是包覆件电机窗开口和底部开放，不能视为防水壳。8000 mAh 容量目前仅为用户提供的设计输入，未据具体电芯型号验证持续放电能力。

## 文件

- `B32_中心电子仓_三湿侧电机总装.step`：机械臂、根盘、湿侧电机、曲线拉索、内仓与两瓣包覆壳。
- `B32_中心电子仓_拆解与接线.step`：仓内零件与沿 Y 方向展开的包覆壳。
- `B32_中心电子仓_总装与内部接线预览.png`：整体位置、俯视路线与内部布局。
- `B32_包覆结构_总装与拆解预览.png`：包覆壳装配与拆解特写。
- `B32_中心电子仓_安装剖面与接线图.png`：沿用现有电子仓分层与供电路径图。
- `parameters.json`、`generate_centerline_canister.py`、`布局与干涉审计.json`：输入、生成程序和审计结果。
