songgagav/spiral_soft_arm/local/spiral-soft-arm/solidworks/electronics_enclosure_v5/README_平板包覆与观察口.md

# B32 根部平板包覆与贯通观察口（v5 几何候选）

更新：2026-10-20。本版按用户审核意见，将 v4 的圆滑外罩改为可分件的平面侧板，并在预览中将包覆件显示为半透明。v4 保留供对照。附图只作为外形参考，不提供尺寸或内部接线依据。

## 结构

- 外罩为六边形截面、上下两圈，共 **12 块独立侧板**。上圈由 z=-8 至 -80 mm，下圈由 z=-80 至 -236 mm；各板宽面为平面，可单件平放导出 STL。上圈外接圆半径由 135 增至 145 mm，下圈由 145 收至 98 mm；内外轮廓相差约 5 mm 径向。面板为打印与装配审查候选，未完成材料、受力和工艺放行。
- 上圈在 0°/120°/240° 开 3 个矩形湿侧电机窗；下圈在 60°/180°/300° 开 3 个贯通观察/检修口。下圈另有 -X 方向的 Type-C 检修开口。底部保持开放，外罩湿侧空间通过这些开口与外界连通。可透过观察口检查线束、积物和连接状态；开口不应被后续密封胶、装饰盖或线束堵住。
- 每块面板有 4 个 Ø3.3 mm M3 拼接预留孔。孔位只提供通用连接界面；角连接片、上下圈接片、顶板固定支架、螺纹嵌件及螺钉长度尚未按实物定稿，不能把 12 块板视为已完成的可装配打印套件。
- 预览中的包覆板透明度约 42%，以显示湿侧电机、卷筒、内层电子仓和观察口；STEP 和 STL 是实体几何，不包含预览透明度。

## 防水与压力边界

外罩是**可进水、可排水**的机械防护件，意图避免形成封闭湿侧腔体；它不承担 5 m 水深的密封压力边界。内部电子仓仍需独立选用合适的壳体、密封件、穿舱件并做压力与漏水试验。通水路径的存在也不能代替水压计算与实物试验；需检查泥沙堵塞、滞留空气、水流阻力和检修可达性。

Type-C 的外罩检修口只是到达内仓接口区域的开孔。内仓现有 Type-C/穿舱接口仍为几何代理；不能让裸露 Type-C 接头直接浸水，实际部件须选防水穿舱方案。

## 数字核查

12 块板各为有效单实体，平放 STL 在合并重合顶点后均为闭合网格。3 个电机窗、3 个观察口和 Type-C 开口均以贯通探针核实与外界相连；底部开放。面板与现有电机、卷筒、拉索、电子仓和底盖的实体交叉检查为空。三根拉索继续沿用 v4 连续曲线，离散曲率估计最小半径均为 9.51 mm；实际拉索允许半径仍未验证。总装与拆解 STEP 回读有效。以上属于数字几何核查，不是切片、打印、装配或水下测试结果。

## 文件

- `B32_包覆结构_总装与拆解预览.png`：半透明平板包覆总装与 12 块板径向拆解。
- `B32_中心电子仓_总装与内部接线预览.png`：机械臂、根盘、切向电机及拉索俯视。
- `B32_中心电子仓_三湿侧电机总装.step`：带 12 块面板的完整几何总装。
- `B32_中心电子仓_拆解与接线.step`：面板展开、内仓与电子件布置。
- `print_panels/*_flat.stl`：12 块板单独平放导出的毫米制 STL，供切片审图；切片后应逐件检查桥接、孔尺寸、表面朝向及支撑需求。
- `generate_centerline_canister.py`、`parameters.json`、`布局与干涉审计.json`、`SHA256SUMS.csv`：生成程序、输入、审计和文件校验。
