songgagav/spiral_soft_arm/local/spiral-soft-arm/solidworks/electronics_enclosure_v6/README_三段燕尾榫与六边形包覆.md

# B32 三段燕尾榫与六边形包覆（v6 几何候选）

更新：2026-10-21。v6 保留 v5 的中心密封电子仓、三台湿侧电机、卷筒代理和平滑腱线走向，另建独立版本；原始 550 mm B32 STEP 没有被覆盖。

## 三段软臂

以根部为 0 mm，选择原模型的 `joint_06`（unit_06/07，189.947 mm）与 `joint_13`（unit_13/14，359.731 mm）为模块界面。含 9 mm 榫头的打印 STL 高度分别约 **198.95、178.78、190.28 mm**，均低于用户给出的 250 mm 有效成型高度。根部单元与安装端保持在第一段内，细小的末端留在第三段内。

每处界面在中央形成梯形截面的轴向插入榫头和相配榫槽，侧向预留 0.3 mm；另有 Ø2.7 mm 横向锁止孔及 Ø2.5 mm 锁销外形代理。锁销轴线与三条原始腱道错开。两个接头将局部中央弹性轴加厚到 R8 mm，因而会改变当地的弯曲刚度；刚度、疲劳、蠕变、锁销固定方式与运行张力尚未实测。锁销代理用于装配审图，实际销的材质、公差、防脱和耐腐蚀方案需由试样确定。

## 六边形顶盘与面板

- 原 Ø260 mm 顶盘外轮廓改为顶点半径 130 mm 的正六边形，保留原有电机、腱孔、夹圈和底部电子仓安装位置。六边形盘的打印 XY 包围盒仍有约 260 mm 的一向尺寸；目前只确认了打印**高度** 250 mm，打印平台 XY 尺寸需另行核实。
- 盘下新增 12 个与上圈面板孔同轴的连接耳。上圈面板的顶端 M3 孔移至各面板切向 ±58 mm，避开切向电机。每面两个顶端螺接位置。
- 上下圈交界处新增 12 个可拆的内侧拼接片。它们分别连接 z=-74 mm 和 z=-88 mm 的 M3 孔，使六块上圈板和六块下圈板具有连续的装配路径。孔目前是通孔；螺钉、垫圈、螺母和嵌件规格尚未定稿。
- 机械臂侧仅在根盘附近增加 **20 mm 高**的六块平板护罩。它固定在顶盘的 12 个小连接耳上，与直立机械臂留有间隙；上端开放，另有三个观察/通水小窗。护罩不延伸到整条弯曲软臂，运行全行程的扫掠间隙仍需检查。
- 所有外侧板在预览中半透明，STEP/STL 保留真实实体。外罩和根部护罩均与外界水连通，不作为密封仓或耐压边界。

## 数字核查与后续门槛

已用原始 B32 三腱切削体复核：三段新实体和两根装配锁销与腱道的交叉体积均为 0。三段、六边形顶盘、18 块面板及 12 块拼接片，共 34 个新增打印 STL，均为有效单实体，重合顶点焊接后的网格均闭合。两处装配界面无实体体积穿插；软臂直立时与根部护罩没有体积干涉。机械臂和总装 STEP 均回读有效。上述数字结果见《分段与装配几何审计.json》。

打印前仍需在实际打印平台与切片器中检查 34 个 STL 的占地、层向、孔尺寸和支撑；优先打印两处含燕尾榫和锁销孔的短试样，测量装配力、轴向抗拔、反复弯曲后的间隙和腱线摩擦。直立静态不干涉不能代替弯曲状态的动态间隙或 5 m 水深的实物验证。

## 文件

- `B32_三段机械臂_六边形包覆总装.step`：完整电子仓、湿侧电机、三段软臂、两层外罩和根部护罩。
- `B32_三段机械臂_燕尾榫装配.step`：仅三段软臂与锁销代理，便于检查模块接口。
- `B32_三段燕尾榫_六边形包覆预览.png`：半透明总装与三段拆解。
- `B32_燕尾榫接口与六边形顶盘细节.png`：两处榫头/榫槽及六边形根盘近景。
- `print_parts/*.stl`：34 个可单独审图的打印候选件；面板已平放，三段软臂保持轴向摆放。
- `parameters.json`、`generate_modular_arm.py`、`分段与装配几何审计.json`、`SHA256SUMS.csv`：参数、生成程序、几何审计与文件哈希。
