songgagav/spiral_soft_arm/local/spiral-soft-arm/solidworks/electronics_enclosure_v7/README_关节内部燕尾榫与紧凑驱动.md

# B32 关节内部燕尾榫、线轮与 250 mm 六边形顶盘（v7 候选）

更新：2026-10-21。本目录是独立于 v6 的装配几何候选。原始 B32 550 mm 实体、v5、v6 均未覆盖。

## 机械臂分段

第 6 单元覆盖根部起算 157.9625–189.9472 mm，第 13 单元覆盖 340.3716–359.7307 mm。切面分别放在约 **173.955 mm** 和 **350.051 mm**，严格位于各自单元内部。两处均将一个原有单元剖成两半，再用中央梯形燕尾榫、相配榫槽和横向锁销代理结合。切面不位于相邻单元的连接处。

三段的 STL 打印高度约 **182.95、185.10、199.96 mm**，低于 250 mm 有效成型高度。每处燕尾榫伸出 9 mm，槽深 9.5 mm，侧向标称间隙 0.3 mm，锁销孔 Ø2.7 mm，销代理 Ø2.5 mm。榫接处的中央轴局部加厚到 R8 mm；装配后该关节的弯曲刚度、疲劳和蠕变尚未测量。

## 湿侧电机、线轮与拉索

三台 ApisQueen 4092 的 **42 × 92 mm 电机外形代理**仍在湿侧，轴线沿各自的切线方向，中心半径从 v6 的 100 mm 调为 **98.5 mm**。每台电机的输出正切向安装一个带两侧挡边及 Ø4 mm 轴孔的线轮代理；线轮中心距电机中心 **52 mm**，卷绕芯半径 6.5 mm，挡边半径 10 mm，轴向宽 8 mm。电机支座安装脚相应调整，避开直径 136 mm 的密封电子仓。

预览中红色拉索以平滑曲线从线轮上缘出线，经过顶盘三孔进入原三条腱道。线轮的轴孔、挡边与卷绕芯是 CAD 候选尺寸；实际电机输出轴、键位、固定螺钉、绕线容量和耐腐蚀材料尚无供应商接口图，不能据此直接加工生产线轮。

## 顶盘和包覆件

六边形顶盘顶点半径为 **125 mm**。含 12 个面板连接耳的顶盘打印实体 XY 包围尺寸为 **221.49 × 250.00 mm**。顶端面板孔移至各板切向 ±54 mm，与连接耳同轴。外侧平板包覆上口为顶点半径 131.5 mm，局部超过顶盘轮廓，以保留湿侧电机的开窗间隙；外罩由独立面板打印。机械臂侧仅根部固定区有 20 mm 高的六块开放护罩。包覆件开窗连通外界，不承担密封或耐压功能。

## 数字核查与实物门槛

生成器复核两处切面确实位于单元内部，三段均小于 250 mm；完整顶盘 XY 最大包围尺寸不大于 250 mm。三段和锁销代理与原三条腱道的实体交叉体积均为 0；两处装配界面无实体体积穿插。电机、线轮、电子仓、顶盘、包覆件和拉索代理经过静态几何干涉检查。45 个独立 STL 候选件为有效单实体，网格焊接后闭合；机械臂及总装 STEP 回读有效。详见 `分段与装配几何审计.json`。

打印前需在实际切片器中复核平台 XY、打印方向、支撑、孔公差与嵌件位置。优先制作两个包含完整榫槽与锁销孔的短试样，测量装配力、拉拔强度、反复弯曲后的间隙和腱线摩擦；还需检验软臂全行程与根部护罩之间的动态间隙。数字几何核查不代表实物或 5 m 水深验证。

## 文件

- `B32_三段机械臂_六边形包覆总装.step`：完整总装。
- `B32_三段机械臂_燕尾榫装配.step`：三段软臂和锁销代理。
- `B32_三段燕尾榫_六边形包覆预览.png`：半透明总装和拆解。
- `B32_燕尾榫接口与六边形顶盘细节.png`：两处关节内部接口近景。
- `B32_电机线轮俯视布局.png`：三台电机、线轮中心、拉索路径和顶盘轮廓。
- `print_parts/*.stl`：三段软臂、顶盘、三只线轮、六个电机支座、两个根部夹圈及 30 块面板/拼接件，共 45 件。
- `parameters.json`、`generate_modular_arm.py`、`分段与装配几何审计.json`、`SHA256SUMS.csv`：参数、生成程序、审计与文件哈希。
