songgagav/spiral_soft_arm/local/spiral-soft-arm/solidworks/electronics_enclosure_v8/README_线轮直线出线与竖向电机.md

# B32 线轮直线出线与竖向湿侧电机（v8 几何候选）

更新：2026-10-21。本目录在 v7 的关节内部燕尾榫、三段软臂和 250 mm 六边形顶盘基础上，重新安排湿侧电机、线轮和拉索。v7、原始 B32 模型及电子仓基线没有被覆盖。

## 用户确认的出线目标

“线轮出口到顶盘线孔是一条直线”指线轮出线口到对应线孔下口的自由拉索段保持直线，**不要求拉索沿线轮转轴方向出线**。普通卷筒仍按切线方向离开卷绕芯。三条拉索各自连接一只线轮与其对应的顶盘线孔。

## 新布置

- 三台 ApisQueen 4092 湿侧电机的 **42 mm 直径、92 mm 长度外形代理**改为 Z 向竖置，中心位于半径 100 mm、沿切向偏移 6.5 mm 处，中心高度为 z=-80 mm。电机顶部的出轴代理向上连接同轴线轮。电机的实际轴端尺寸尚未取得。
- 三只线轮中心高度 z=-17 mm，外挡边半径 10 mm、卷绕芯半径 6.5 mm、轴向宽 8 mm，Ø4 mm 中心孔仍为接口代理。上挡边有与拉索直线方向相对的出口槽。每台电机用一件双圈支座固定在顶盘下方，支座上端留两个螺接孔。
- 线轮出口坐标以第 1 通道为例为 (100, 0, -13) mm，线孔下口入口约为 (30.6, 0, -8.8) mm。其余两组绕中心轴旋转 120°、240°。三段约 **69.5 mm** 的自由拉索路径都是直线，经过密封电子仓顶盖上方，并从各自线孔下方进入。线孔内部的圆滑转向、孔口耐磨衬套以及卷绕芯到出口槽的过渡尚未定型；模型中的拉索代理在孔底下方 0.8 mm 处终止。
- 外侧六面平板包覆的三处电机检修窗向下延伸，以配合竖向电机和双圈支座。外罩、根部护罩仍与外界水连通，不承担密封或耐压。

## 保留的分段和打印边界

第 6、13 单元内部的燕尾榫切面分别约在根部起算 173.955 mm、350.051 mm，三段打印高度约 182.95、185.10、199.96 mm。六边形顶盘含面板连接耳的打印实体 XY 包围尺寸为 221.49 × 250.00 mm。机械臂侧包覆仅在根部固定区。

## 数字核查与待确认项

三条出线口到线孔的直线偏离量为 0；拉索代理未穿过电机、支座、电子仓、顶盘或包覆面板。电机、支座、线轮和外罩通过静态实体干涉检查。三段软臂及锁销与原腱道无交叉体积；42 件独立 STL 候选件为有效单实体，网格焊接后闭合，STEP 总装与软臂回读有效。完整数据见 `分段与装配几何审计.json`。

实际电机轴端、线轮固定方式和绕线容量尚无供应商尺寸确认。线轮上挡边出口槽的卷绕过渡、顶盘线孔处的最小弯曲半径、支座受力、全行程腱线运动、切片公差、5 m 水深及淡水/海水运行均需进一步验证。此版是审图和短试样候选，尚非打印或水下运行放行。

## 文件

- `B32_三段机械臂_六边形包覆总装.step`：竖向电机、同轴线轮、直线拉索、电子仓、三段软臂和包覆件总装。
- `B32_三段机械臂_燕尾榫装配.step`：软臂三段及锁销代理。
- `B32_三段燕尾榫_六边形包覆预览.png`：半透明总装和拆解。
- `B32_电机线轮俯视布局.png`：三组线轮出口至线孔直线段的俯视位置。
- `B32_线轮到线孔直线路径侧视.png`：第 1 通道直线从电子仓顶盖上方越过的径向投影。
- `B32_燕尾榫接口与六边形顶盘细节.png`：两处关节内部榫接与顶盘近景。
- `print_parts/*.stl`：三段软臂、顶盘、三只线轮、三个电机支座、两个根部夹圈及 30 块面板/拼接件，共 42 件。
- `parameters.json`、`generate_modular_arm.py`、`分段与装配几何审计.json`、`SHA256SUMS.csv`：参数、生成代码、静态审计与文件哈希。
