songgagav/spiral_soft_arm/local/spiral-soft-arm/solidworks/electronics_enclosure_v9/README_水平转位与线轮切线对孔.md

# B32 横向电机、线轮切线出线和顶盘对孔（v9 候选）

更新：2026-10-22。此目录单独保存本轮 CAD，不覆盖 v7/v8 或原始 B32 模型。用途是总装审图与局部试样设计；尚未放行整机打印和水下运行。

## 三处对齐

- 三台湿侧电机保持**横向平置**，轴线分别沿顶盘平面内的切向。电机外形仍按 Ø42 × 92 mm 代理建模，实际轴端接口未核实。每台电机有两个带 M3 预留孔的鞍座。
- 顶盘 250 mm 六边形外形保持不变。三只顶盘线孔在俯视角度 `60°/180°/300°`、半径 `30.6 mm` 处。原始 B32 CAD 的三条基部腱道方向由几何生成器的 `+Y/120°` 构造得到，即 `90°/210°/330°`；机械臂实体绕 Z 轴旋转 `-30°` 后，腱道入口与三只顶盘孔同心。顶盘孔相对旧布局转位 `+60°`，机械臂与顶盘孔的转角不同是为了校正原始 CAD 的 90° 方位差。
- 电机与线轮均沿原切向轴布置，没有竖装，也没有倾斜顶盘。线轮距电机中心沿轴向 52 mm；电机中心沿切向平移约 -25.50 mm，使线轮出线切点、顶盘孔、软臂腱道入口在**俯视方向**对齐。第 1 通道的线轮中心约 `(106.5, 26.5004, -33) mm`，顶盘孔中心约 `(15.3, 26.5004) mm`，自由拉索段沿俯视 X 方向。
- 线轮转轴与拉索自由段垂直，拉索从卷绕芯的计算切点直达顶盘孔下口。三通道的孔中心偏差与轴线点积在模型数值精度内为零。电子仓顶盖上方的最小**静态几何间隙**约 `1.428 mm`，尚未包含装配、公差、晃动和受力变形裕度。

## 延续结构与待处理问题

关节单元 6 和 13 内部的燕尾榫切面、三段打印件、固定根部护罩、半透明六面平板外罩和密封电子仓沿用上一版设计。三段网格高度约 182.95、185.10、199.96 mm，六边形顶盘含安装耳的 XY 包围尺寸为 221.49 × 250.00 mm。

电机检修窗与顶盘面板耳位已按转位后的电机包络避让。静态 CAD 干涉检查通过；电机窗上缘的局部连接条约 3.5 mm 高，其打印强度和紧固可靠性仍需试样确认。外罩与水连通，不是压力壳。

模型只表示线轮切点到孔下口的直线自由段。为使 Ø1.3 mm 拉索代理不穿入线轮芯，实体代理从数学切点向孔方向退后 3.2 mm 才开始；这段卷绕释放过程、孔口圆滑导向及进入臂内腱道的弯曲半径**尚未建成可打印结构**。尤其不能把顶盘孔处直接视作一个可接受的直角转弯。线轮锁轴、绕线容量、真实电机轴端、动态腱线避让及 5 m 淡水/海水密封和供电均待实物验证。

## 文件

- `B32_三段机械臂_六边形包覆总装.step`：总装 CAD。
- `B32_三段机械臂_燕尾榫装配.step`：三段机械臂与锁销代理。
- `B32_电机线轮俯视布局.png`：线轮切点、顶盘孔与腱道入口对位图。
- `B32_三段燕尾榫_六边形包覆预览.png`：半透明包覆总装与拆解预览。
- `B32_线轮到线孔直线路径侧视.png`：第 1 通道自由段径向投影。
- `print_parts/*.stl`：45 件几何候选件。
- `parameters.json`、`generate_modular_arm.py`、`分段与装配几何审计.json`、`SHA256SUMS.csv`：参数、生成代码、静态审计和文件哈希。
