songgagav/spiral_soft_arm/local/spiral-soft-arm/solidworks/electronics_enclosure_v10/SHA256SUMS.csv

relative_path | sha256
B32_三段机械臂_六边形包覆总装.step | ba86331f42e806eff1a1546cdfd0f8fef0479b204dde1a395eac282371b9354c
B32_三段机械臂_燕尾榫装配.step | 20f1997b8bec6361f3d2830a01c81dca3f8c4a0280784383dd5ee5ea079f1097
B32_三段燕尾榫_六边形包覆预览.png | e3f57a3cee342fea1fd2926e5b9704fa4167815aff6e6c5eee3b335cb2c54c7a
B32_燕尾榫接口与六边形顶盘细节.png | 68fd7dbee7d816716bc3de3f068691fe053bba809c784d359d7107618e10a54d
B32_电机线轮俯视布局.png | 7dad3a25d7d66be10498ea8e0187e5378fc2b720653c9f00b3aeae1a2f0c049e
B32_线轮到线孔直线路径侧视.png | 128df9cf709c921bd8a9834a11cedf58d841e68f766582093808c1e6db8d05a6
generate_modular_arm.py | 7fd165e36536361a094028976215736efd2b9c1980f1e9262121e153fb0c2fb7
parameters.json | 7d1be59dc907d2cf557b8980eb4090d06d998039b7918da543064ba632fad9e4
print_parts/arm_section_01.stl | 41abbe6a1ca0b164012030325b98a062333b016b7f24ee400e4dce20d4a2cb98
print_parts/arm_section_02.stl | 4c6c77267c5f46782b40b5249c5760fbd04ee654d955816b08c36a4000753a5c
print_parts/arm_section_03.stl | f492ccc183daf2db4a5aa91075d19c336020b333a06d33659f6f20d212ebc0f5
print_parts/cable_reel_01.stl | de26a92c0c91e3a644fbd2d5a23913da8c73400777d46b81fe0d784f9a219a2f
print_parts/cable_reel_02.stl | 0f6b6e4d0169ca46f6ff05358e8f531bbc8ee1d99fe034f5a6b4d415f52d90f1
print_parts/cable_reel_03.stl | 4eb53c643780a80b84cc1162e66557fbbd707f2cd3e915de31d6ef3e80aa1a92
print_parts/hex_base_plate.stl | ef931ef4ec63213fad5f3a9acb46ac8d78d6525ed185ce8a047ba7d2ed0e3c71
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
print_parts/wet_motor_saddle_06.stl | fce79367eed706cb7badecd627f830a67748b18a1227e43e02d4b0913614e07b
README_径向切线出线与线孔倒角.md | d57efb6a064524144e65116de34d27e17f7b64e30d5591dd372c139d82f719b3
分段与装配几何审计.json | de2b1b4de91ffbf38d842cabac60eefffc3a97c300762fb8433da8c002f201b1
