songgagav/spiral_soft_arm/local/spiral-soft-arm/solidworks/electronics_enclosure_v5/SHA256SUMS.csv

file | sha256 | bytes
.gitattributes | 6d9beacc6e6d29ffd85cedb6bd14efaac34c4041a37a85efa7a7081a02b61944 | 32
B32_中心电子仓_三湿侧电机总装.step | 5cacc709dac297c3dfc6bc61c0c77050039f918e71bc95c35385dd41cb32a5c5 | 20542238
B32_中心电子仓_安装剖面与接线图.png | a48e212e989252c9d0255135c50d0f89414f273a969be66cabfc2d8aea18c534 | 250181
B32_中心电子仓_总装与内部接线预览.png | 90d45b8c84300c47d9322703a945c978519da5d63121adc4d73b61c69bdb9387 | 469556
B32_中心电子仓_拆解与接线.step | 09d1c025c355b869fc5ba1b66b226980712ec773acf828bf76bad7586f965270 | 4869221
B32_包覆结构_总装与拆解预览.png | 22f63f92c29d87075249a852438a29816df3225a0adced7988bda1d5f29751e9 | 94534
generate_centerline_canister.py | 886a4873c1dad91a0902e23b4dd4be37eb98a49f5c55e21eb1610a16f12f1bd1 | 43788
parameters.json | 3fb40c1be5641a698e6efe7ae29307c1a79461fa816b85b195f70de12224827d | 2711
print_panels/lower_panel_000_flat.stl | c51e2960a650878a5701ffc800b34530662b778c1412aa8e6fe936fb80e43582 | 105284
print_panels/lower_panel_060_flat.stl | ae246dcf6834bef6239796baba169dada8ec346f7a253163d88e2cfb4f4ae241 | 110584
print_panels/lower_panel_120_flat.stl | d56a50b4e9bdba1e6035af3a6e827adb7eae46addb87f5e53b5b10e07bdf9d45 | 107584
print_panels/lower_panel_180_flat.stl | ca28139087bdea366a113136d13a501dd49217e08206b95c8afebc3aeb2729ac | 110484
print_panels/lower_panel_240_flat.stl | 5256b378bdedfe4d9880f2bf1051e9dd70650e7d56e174272f1313ee06cc615a | 107884
print_panels/lower_panel_300_flat.stl | 2f714d0929d457ed97d94179de29a0467db28b59b95038a9d1830f6c3c1a1d1b | 110984
print_panels/upper_panel_000_flat.stl | 926ce73919660a697b56dd49b24373af1894c2f075eeb5829f57a73c7e5b1e0f | 114384
print_panels/upper_panel_060_flat.stl | 5eca7513b47a03525f83c44702b8ba0720044a1dff24acfd6d87f371d859bd12 | 103884
print_panels/upper_panel_120_flat.stl | 32d606d891570cc93a6dba94207598307ab4f9ee65470a90227832703a2bdb73 | 104984
print_panels/upper_panel_180_flat.stl | 40fd4a770fd6015f2f63ebd852f73cb44d369d8ee716369cb431abf1272aded0 | 107884
print_panels/upper_panel_240_flat.stl | 708313460be6cad2c040e2dbee1dbf5ca6a8686aee27453375ac5a93dd7bcc3a | 105084
print_panels/upper_panel_300_flat.stl | 12b2d08b2bda222d5753bdd6893e4d9148f53ee8ee3284301f3e46cec4f588cd | 103884
README_平板包覆与观察口.md | 0080475b860105c4c41b7049980f98a18c87fb477e5fc2cfdf9d4f8af35d2574 | 3390
布局与干涉审计.json | 6c59f932f38225d322c71cccc202da5fe869ae07e13d2505f3c2cc5e41c046a8 | 9676
