songgagav/spiral_soft_arm/local/spiral-soft-arm/solidworks/electronics_enclosure_v6/SHA256SUMS.csv

relative_path | sha256
.gitattributes | c48be5eaa0b264d04dbbee97396135a980634be82479fdae2361cb806fa9eeb0
B32_三段机械臂_六边形包覆总装.step | 2ee35298826461c904d6e28f6240b2a6c72d5639da7719a7593276c819f292c3
B32_三段机械臂_燕尾榫装配.step | 28bc3e12b0f631ce4f13355d909a4cb95166170eb9782c55830a0ea72074fe45
B32_三段燕尾榫_六边形包覆预览.png | 7e7a111aee848c7c450990a5ff183dcf33f962d1684d747cc7707b038cde861b
B32_燕尾榫接口与六边形顶盘细节.png | 8e1e771cddcb9c7c351f908c84a02675f069fd525025af0418fb5e9c82c93976
generate_modular_arm.py | b6c7c2f0aaa1081f52fca08d81b5b20ddbdcc731e4a4e0528d4e241bc96c560f
parameters.json | bd263ab40e3d45f7816c44aa4261c750741642f922d42e115cb2e024647e5075
print_parts/arm_section_01.stl | 2e9450924bb1e8889a5460ab99eb012860426a4d9b7abd12af5c275fbd19aa81
print_parts/arm_section_02.stl | 17c57781394a5fbe3d816ed9ba05572a356a9016ddad0b1b58f9646e0efb737c
print_parts/arm_section_03.stl | fab042461c34a8ae80f74d156cb1e81ea5d2cdec41a16aacb5673c7dd9cd6d03
print_parts/hex_base_plate.stl | 7607e7df882e9468b05d7f0f4d43b0579559872bf2b6f179b59c09dd0fff3394
print_parts/lower_panel_000_flat.stl | c51e2960a650878a5701ffc800b34530662b778c1412aa8e6fe936fb80e43582
print_parts/lower_panel_060_flat.stl | ae246dcf6834bef6239796baba169dada8ec346f7a253163d88e2cfb4f4ae241
print_parts/lower_panel_120_flat.stl | d56a50b4e9bdba1e6035af3a6e827adb7eae46addb87f5e53b5b10e07bdf9d45
print_parts/lower_panel_180_flat.stl | ca28139087bdea366a113136d13a501dd49217e08206b95c8afebc3aeb2729ac
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
print_parts/upper_panel_300_flat.stl | e2494a4e333d27cc48c24fa3cafff45c2e1cf401a2377cf2098ee4a327ad45aa
README_三段燕尾榫与六边形包覆.md | 504ec1ffd96e4f2dc405ae2878b3ab03ba042f9d63d867d82ea9479b661a65bd
分段与装配几何审计.json | 08622a0bb508ebcda7cdfd85993830dcda4d7315d0817a1f63448365f972bdde
