songgagav/spiral_soft_arm/local/spiral-soft-arm/solidworks/electronics_enclosure_v7/SHA256SUMS.csv

relative_path | sha256
.gitattributes | c48be5eaa0b264d04dbbee97396135a980634be82479fdae2361cb806fa9eeb0
B32_三段机械臂_六边形包覆总装.step | 68dbde5fb429ebf8e6ed432954c7d252c9b91668a7844e531f4bffbd92b09027
B32_三段机械臂_燕尾榫装配.step | 06eca65f9fe6d0688cf63ece98c86fed2faf91f952b256331a6b189dc984075a
B32_三段燕尾榫_六边形包覆预览.png | 71bba9d7cc06196af2183033908df3ec083a9f0dfeb3abd9b4f4270fb6e37569
B32_燕尾榫接口与六边形顶盘细节.png | 301a2be30171aa626bcd85448264d9c346d35be26cc707df43ef928dcdf8bb2f
B32_电机线轮俯视布局.png | 71edbadf99fec5707a4ec5ec89092532a9456faa3a5d419dd3e424b88c004499
generate_modular_arm.py | eddeb71a1b0cfe256c91b587848324fc95cda3da9551f726a3e8288210941d29
parameters.json | 1d487e6e61989734267dd438ffda3c3d1afd4159975a21ce268383ea623a8e87
print_parts/arm_section_01.stl | b0287a38e73cca0c73d36a69024663ae12aa5f5712d60afa309f156b6c70cb9b
print_parts/arm_section_02.stl | 7d5fb7c58a3b0804340eb0c15afe8b71d4d81b63f061b068aecf2b6b71568b8f
print_parts/arm_section_03.stl | ad0944b14d0b93e8f08cf28692af6fe81054abb50d413d44fa089eeb6599bb89
print_parts/cable_reel_01.stl | 26323fb392d6844330ad74a5ed8a31a7a929c25bce3c46fac2e8b906e20d2213
print_parts/cable_reel_02.stl | ff9ea5e7b8c833e2f11a4249c3cc7b7c9734eb84f8817429dd1daae4f6109115
print_parts/cable_reel_03.stl | 73aa026e4029c092e9f5301850ce5c16c7314579321c29105dcc6aab5500361b
print_parts/hex_base_plate.stl | fc50c04f744dad8dc69eb95f5fbcc8b39cb9d9a3817728a9e204d4d4b3b5e446
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
print_parts/wet_motor_saddle_06.stl | 699ee325d3d95c23f16abe679c799a2d01e3afaf1b04eadae277c9331cac8c32
README_关节内部燕尾榫与紧凑驱动.md | faff41a07b42e6d4b35420a675ba476098d61acc0cdf4b06a091fec4a3b40902
分段与装配几何审计.json | 818448c46eeaf5cbd7d124031c796731b21fe45157e0677f73b6ed98da28c020
