songgagav/spiral_soft_arm/local/spiral-soft-arm/solidworks/electronics_enclosure_v16/SHA256SUMS.csv

file | sha256 | bytes
B32_v16_减速电机直角传动总装.step | ae5f131ef99e47c625284e95f61910ab2aa1bb3f408076756f60fade145985c0 | 19285923
B32_v16_半透明总装预览.png | 59a002b45ebd88bc3b4890e128d56f725fedd0f4080c172ffe2ad50e64475623 | 209039
B32_v16_线盘线孔俯视.png | bb2cc94161962fe20cb00d8bf0a24e3bc1fe494319a37da99800ab745a21bb68 | 244685
README_大陆可采购减速电机与直角传动.md | 8c64ed98c4f24614606ba650731dd2cca33742db9bb8f4541b0c1bf684a6f95b | 6011
generate_gearmotor_drive.py | d5bdd2e0b7b6400ae29527f5a5a6dfe7c5b1b707578bec6f6553d0ee501a5221 | 18804
parameters.json | 583c7b665798fb333d6335d053b6b446df18b99636b5d6a863df3c3d03ac232b | 2779
装配布置审计.json | e94fec3364e930463ed46aefbf0bbac4672db86f18d1829d3ee0bb2fb5d0761a | 3413
