songgagav/spiral_soft_arm/local/spiral-soft-arm/solidworks/electronics_enclosure_v15/SHA256SUMS.csv

file | sha256 | bytes
B32_v15_半透明总装预览.png | f2236ecfc34b80181de0fdc35460417e9d19df1596219826da4a325301c783e5 | 203163
B32_v15_垂直电机水平线盘总装.step | cd8dc21f1311fb015a44668cb25f1a8f3dcadc8af523e0de264ebb15259214e4 | 19750487
B32_v15_线孔双面倒角剖面.png | 156bc1196a557fca6f949cec403e7bc2bd4bfe4ae8cac622dd9d62c2c69f08b3 | 62817
B32_v15_线盘线孔俯视.png | a9cf4fab89bfef98b0e77f20fc4bd114af22c5f2d31e14bf8cdc617f2e32a783 | 221257
README_垂直电机水平线盘.md | 54375493747b9998fb777c1ea20d0039218e2cb9b1527265db642c33230926b5 | 4305
generate_perpendicular_drive.py | 8124beb64dd87fc9f9bc7374a2aa8f0153d47fee12efbc70878a082e981479e6 | 40778
parameters.json | 0f8bca472c677a99a7812be2f96abcfbb29c7fcd0437eb880f52ebf4343423f1 | 1877
装配布置审计.json | 1d99a207a775fbac2cabe782951d7f6084997bd99b156cf40723b45512f8a1a8 | 4923
