songgagav/spiral_soft_arm/local/spiral-soft-arm/solidworks/electronics_enclosure_v14/SHA256SUMS.csv

file | sha256 | bytes
B32_v14_半透明总装预览.png | eed90289d18453cbf6a87eae54ccf3ac0bc70b1854a33cdb213ae6444badf8d6 | 200369
B32_v14_物理装配优化总装.step | 46ac10dc408df282a3d0c3fb9ed3eacead3c382873828e89adf07593855cd97c | 19214990
B32_v14_线孔双面倒角剖面.png | 3fe4502c671c7a8fe42670eadde821e52e32b1f58b71019a1b6559fb946bbef4 | 62744
B32_v14_线盘线孔俯视.png | 0838dbb149147a7c073015d09222f59164212767dfa55f0ac66badd12fe35005 | 219920
README_物理布置优化.md | 800e1973334f44174aadfc366d7f20e8d66d010ff056c9a858d237730c9fa87a | 5201
generate_physical_layout.py | 9cf73370951bc422f91948028972df2df18978c08560772c4357216e59b85817 | 32986
parameters.json | d4cc22ca46a6f6b7e449372c587a7d21e7c5826a0716b817b58c360631802a84 | 1640
装配布置审计.json | 608f9188eeac36a9945f632a643f10a3be8fbc44c1ce3722717c1618f930ec16 | 4339
