songgagav/spiral_soft_arm/local/spiral-soft-arm/solidworks/electronics_enclosure_v13/SHA256SUMS.csv

file | sha256 | bytes
B32_v13_M2006竖装共用干仓总装.step | 44565a631dee3f9ca6c0eca7601b56d0f25081ec1357aa3dd03acbea7ef2b140 | 18298318
B32_v13_紧凑竖装总装预览.png | e5715f6163edb471c3ed026df72677f56f48d94449e0d281217705c34ef1371f | 174439
B32_v13_线孔双面倒角剖面.png | 3c4dc54b283c671d7270904ddbdbc549a5dadc9d10d8f0bca7cd9d66569bada2 | 61628
B32_v13_线盘线孔俯视.png | 9c93a18b1316511f644ca95d3423cf0a246287b9d8435dc84b86221079b0fdcc | 206126
README_紧凑竖装共用干仓.md | 53763af67ff8d95ea3574cdf5ac734d132cb9d8530e55cdf7024e67c6e64c629 | 5151
generate_compact_vertical_drive.py | 15faeb95f94f364a78f0d36253a0a0ee2c3b7af608db5b90d43310cfadeca295 | 22425
parameters.json | 54d88d0445cf781c1ea7d001ed8fdd8331468c00c6a7364f7d767dcdb674af7d | 1426
装配布置审计.json | 3d7aead15aac5f453022aa5019179d58e180ca7cc7a164c4093adaa7e27c9729 | 3400
