songgagav/spiral_soft_arm/local/spiral-soft-arm/solidworks/electronics_enclosure_v12/SHA256SUMS.csv

file | sha256 | bytes
.gitattributes | c48be5eaa0b264d04dbbee97396135a980634be82479fdae2361cb806fa9eeb0 | 150
B32_M2006共用隔水仓_俯视与轴封.png | a18f0ba89296023dbc021e072694206603faa5ce0d3ac58a618a23f53933e5c1 | 204487
B32_M2006共用隔水仓_总装预览.png | d717d4e6158247c462591d0c8420feecc82f1ed279895cbcc940fa508739eefa | 184096
B32_M2006共用隔水仓_湿侧线盘总装.step | 89dfea3abdb2340018b0f50f587a6f1fb9f6517808a392417602707de98fd054 | 23351482
README_共用隔水电机仓.md | 4e3671fc1bfdca6e189446fb7b82f3130ecae6b3ffc2aba68c9b8a054a72af2c | 4407
generate_shared_dry_chamber.py | ee1386601d70aef687db6073888d3cd9f3afcdf2834a36edfa7a3ca087012d35 | 26344
parameters.json | ec2d4d0ffc9a07961afafa08eacdb4f5cfc96aba5131589e52a345c314a368c3 | 4136
装配布置审计.json | 3ba2ce71113e10ba89b6b65eea13ec4aeea72836b27782081a7ee6401e6efc6f | 3833
