songgagav/spiral_soft_arm/local/spiral-soft-arm/solidworks/electronics_enclosure_v11/SHA256SUMS.csv

file | sha256 | bytes
.gitattributes | c48be5eaa0b264d04dbbee97396135a980634be82479fdae2361cb806fa9eeb0 | 150
装配布置审计.json | 217d1a945b7891b29c0e993e86e6c9c69572119edee0cccc763ae6ea5786f66f | 2858
B32_燕尾榫与六边形顶盘细节.png | bd5b93615bcf3b98cbc0777c0e1444d4c9153ea8712d0ed8d392c3fb7172951e | 122492
B32_M2006干式电机_湿侧线盘总装.step | db6e186601309c23de3ca6998390cbc40ab8866e8c4d86dcc74757edff0af2ce | 23243958
B32_M2006干式电机与轴封布局.png | 2ea6bd0c54e553a0ef09b08f778d7349044d3a645f60a68707c77e7752ca7e49 | 201276
B32_M2006干式驱动_总装预览.png | 42b7a5fdba028f8208ca0cc95c0ca46d89348350484235e47401f08ff69d3d03 | 119725
generate_sealed_m2006.py | 584a0e70360792cb05bbe1a30b005e9d85685b045af3e4e1fba6df73e224f264 | 13978
parameters.json | ca40c80a0fe1bea8edb536347678491a8ce701c5b84553836c654c558de66b64 | 3724
README_M2006干式驱动与轴封.md | 92cea59a87ecba612e87ff77c664939055944aa98e183f5db42284d2ebf5c594 | 3818
