songgagav/spiral_soft_arm/local/spiral-soft-arm/solidworks/electronics_enclosure_v3/SHA256SUMS.csv

file | sha256 | bytes
parameters.json | bfa30108918155eb29877d9bd1694969cc81ff80bced11fe91fc2620286521a1 | 2714
generate_centerline_canister.py | 2f59c20d3f77b6283f76fd527ad11b41ca2fbeb15a823f1a7ef9d2d8e5427aa3 | 32259
README_中央电子仓重画.md | 7536d14679b55079f0c131e804b8890a1563cda6e803c2b273ef0c6bde11ce4b | 5260
布局与干涉审计.json | 7c6f7ae3fcc6c407e2ad52ba6ecfcf69e7e603756738395854ef6c9c8f160d52 | 5325
B32_中心电子仓_三湿侧电机总装.step | d02135d778dc762928fee4dece75da4bed74440f68e90dfc6de071585f5ee9bd | 15949269
B32_中心电子仓_拆解与接线.step | 047004f8aaeafb6d90c0a663a5649751b87f951da7ef4d0ec6bb82530476f076 | 1781913
B32_中心电子仓_总装与内部接线预览.png | b01d919939ab7cc1cb884465d53ef1b5fdc6b4cf5d95bd92c0980e31600ecfb4 | 444989
B32_中心电子仓_安装剖面与接线图.png | a48e212e989252c9d0255135c50d0f89414f273a969be66cabfc2d8aea18c534 | 250181
电调硬件候选与STM32接口.md | 64dc545a466073e2d217dc44689e0e3223427676eaddffdd7bcf1fb6078c5d31 | 6386
