songgagav/spiral_soft_arm/local/spiral-soft-arm/solidworks/electronics_enclosure_v4/SHA256SUMS.csv

file | sha256 | bytes
.gitattributes | 6d9beacc6e6d29ffd85cedb6bd14efaac34c4041a37a85efa7a7081a02b61944 | 32
B32_中心电子仓_三湿侧电机总装.step | a29eb250a2f8db692545cef6cf974653eb7497fd823ffe46f5d83b9c0aebbe57 | 21404570
B32_中心电子仓_安装剖面与接线图.png | a48e212e989252c9d0255135c50d0f89414f273a969be66cabfc2d8aea18c534 | 250181
B32_中心电子仓_总装与内部接线预览.png | 0f14fbb7a4b4885c3cf67b2fac8aa39d42c9eb9bee7d33bd5d8836fa89d14628 | 475128
B32_中心电子仓_拆解与接线.step | 285b8bb8a41aa87af2ec599f9e8f0f6cfacdafa7505176e7747f270a8c4286b0 | 5710864
B32_包覆结构_总装与拆解预览.png | 95ec595bded2d9459ab4b6068a6a4ec32f5490d6819052174b5b955d08dbd996 | 245775
generate_centerline_canister.py | 01ce2b0561d5204d69e6ae0e8201d0c5d4ef8db476a3690d2bc0f56cfa7be3e9 | 40228
parameters.json | 49af7b21ae828df5456d607d9ae57095393c7055a76f8183664c3a51cd7ff48b | 2730
README_包覆与圆滑拉索.md | ac11d75deb2db335253108f6108299489a79a63813185672e5c0757a6b2660ac | 3356
布局与干涉审计.json | 654b1aab5456bac53a3b1212d8c6de305c77c3f41d77308db79fe474c6aca87a | 5880
