songgagav/spiral_soft_arm/local/spiral-soft-arm/hardware/硬件供电拓扑图_M3508_C620_2026-10-25.png

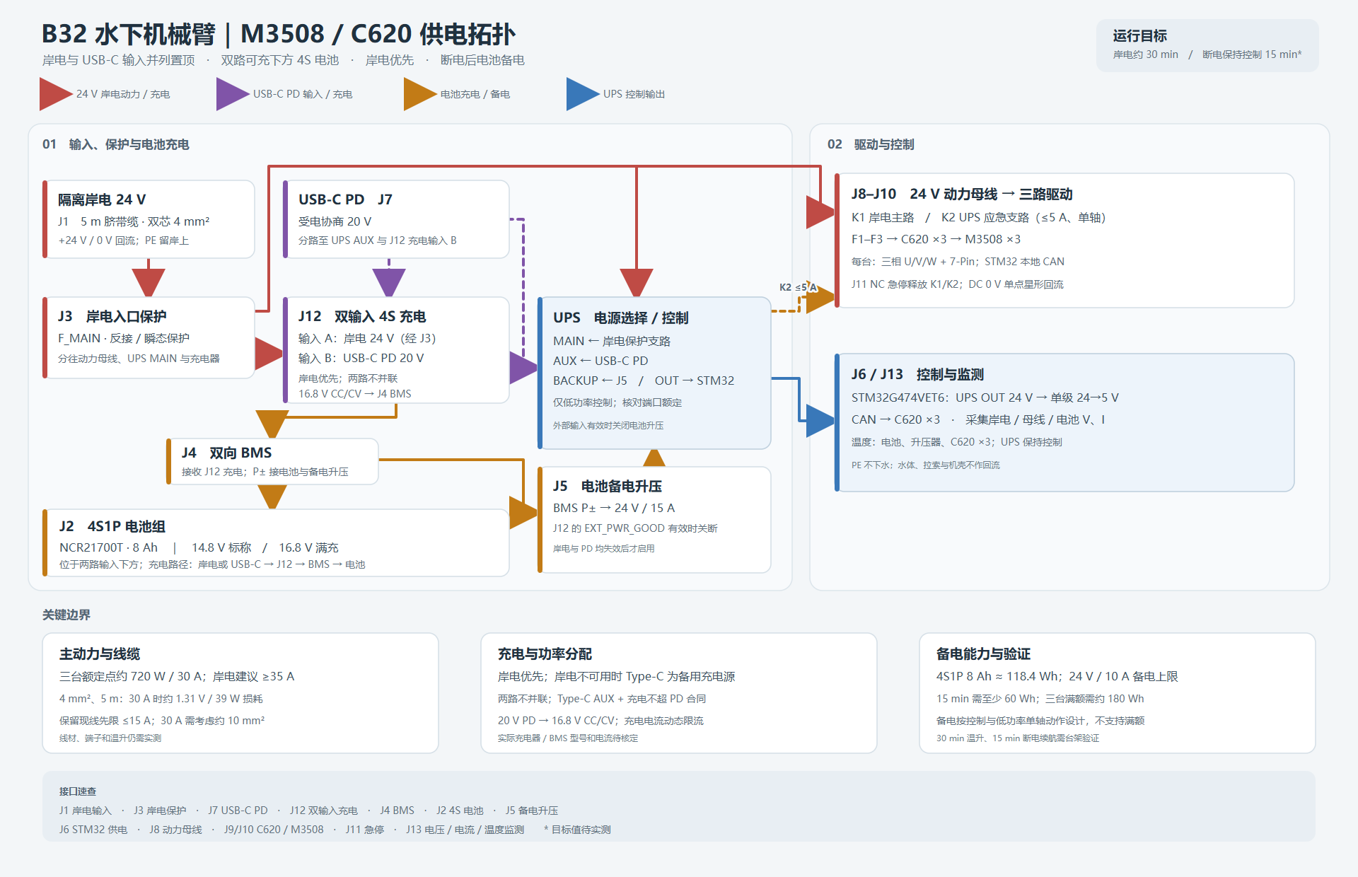
local/spiral-soft-arm/hardware/硬件供电拓扑图_M3508_C620_2026-10-25.png
