songgagav/spiral_soft_arm/local/spiral-soft-arm/solidworks/electronics_enclosure_v21_cnc_shaft_sleeve/M3508_D轴套联轴套_CNC首件图_RevA.png

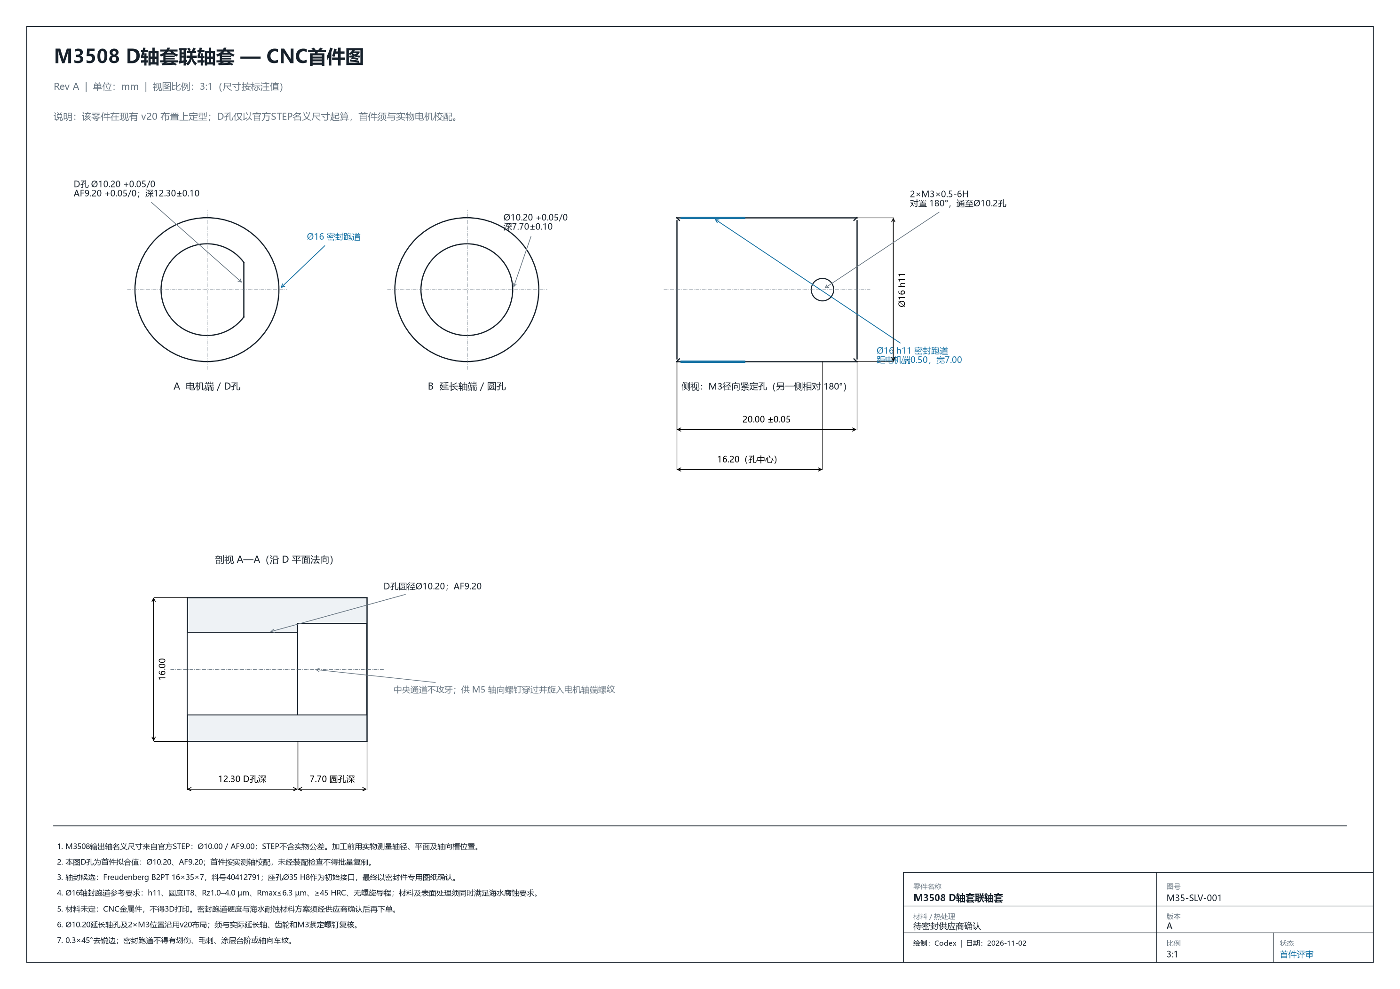
local/spiral-soft-arm/solidworks/electronics_enclosure_v21_cnc_shaft_sleeve/M3508_D轴套联轴套_CNC首件图_RevA.png
