songgagav/spiral_soft_arm/local/spiral-soft-arm/solidworks/electronics_enclosure_v23_cable_and_seal_interfaces/B32_v23_M3508三路总装预览.png

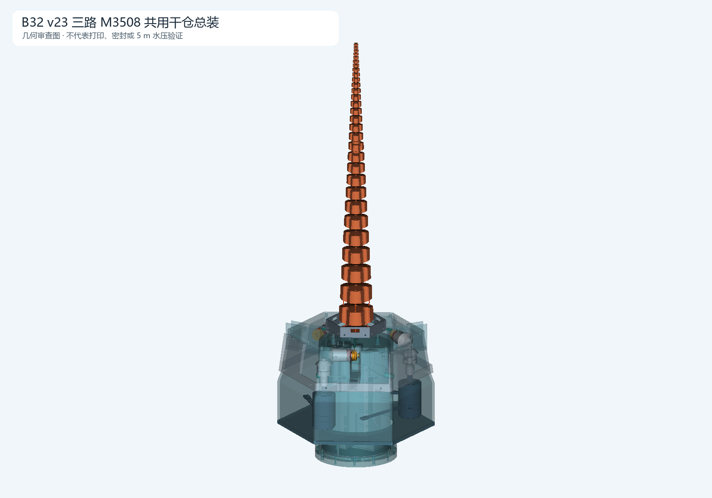
local/spiral-soft-arm/solidworks/electronics_enclosure_v23_cable_and_seal_interfaces/B32_v23_M3508三路总装预览.png
