songgagav/spiral_soft_arm/local/spiral-soft-arm/solidworks/electronics_enclosure_v23_cable_and_seal_interfaces/B32_v23_拉索直线与根部过渡尺寸图.png

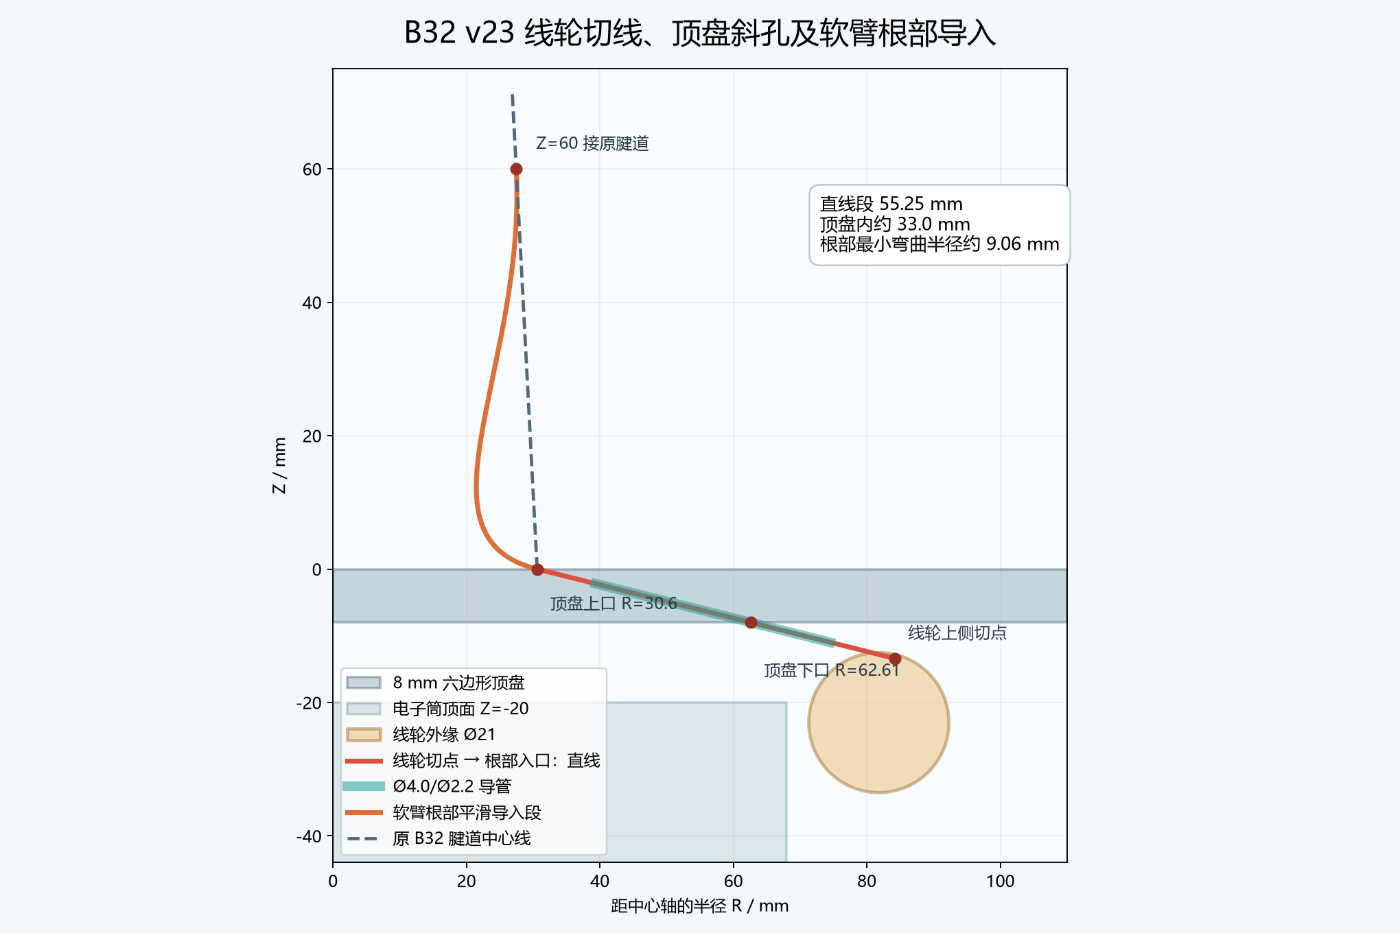
local/spiral-soft-arm/solidworks/electronics_enclosure_v23_cable_and_seal_interfaces/B32_v23_拉索直线与根部过渡尺寸图.png
