songgagav/spiral_soft_arm/local/spiral-soft-arm/solidworks/electronics_enclosure_v23_cable_and_seal_interfaces/B32_v23_轴封与拉索接口剖视.png

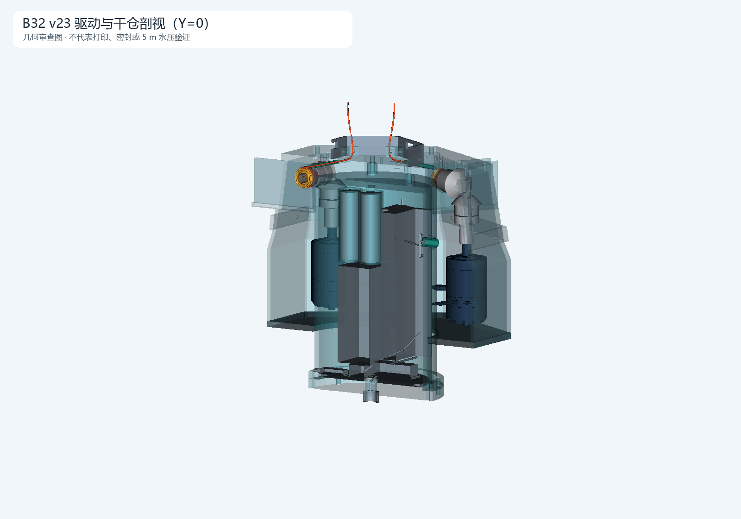
local/spiral-soft-arm/solidworks/electronics_enclosure_v23_cable_and_seal_interfaces/B32_v23_轴封与拉索接口剖视.png
