songgagav/spiral_soft_arm/local/spiral-soft-arm/solidworks/electronics_enclosure_v24_selected_hardware/B32_v24_电子仓分层布局图.png

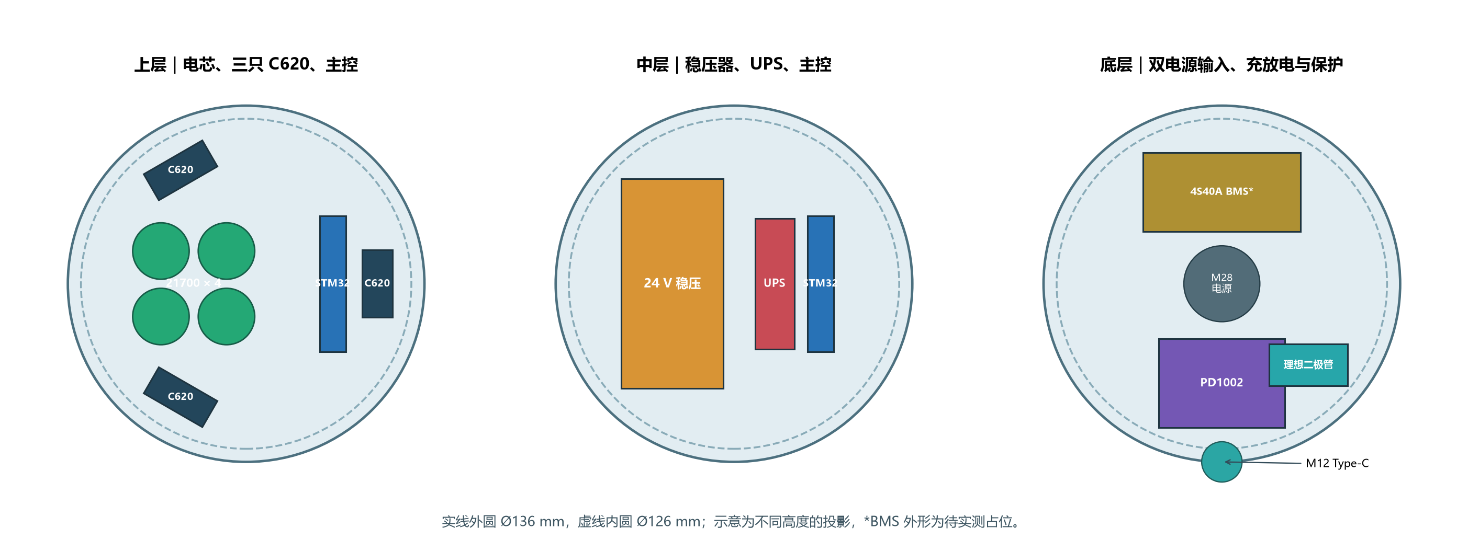
local/spiral-soft-arm/solidworks/electronics_enclosure_v24_selected_hardware/B32_v24_电子仓分层布局图.png
