songgagav/spiral_soft_arm/local/spiral-soft-arm/solidworks/electronics_enclosure_v25_power_input_and_m28/B32_v25_M28沉台与承力环细节.png

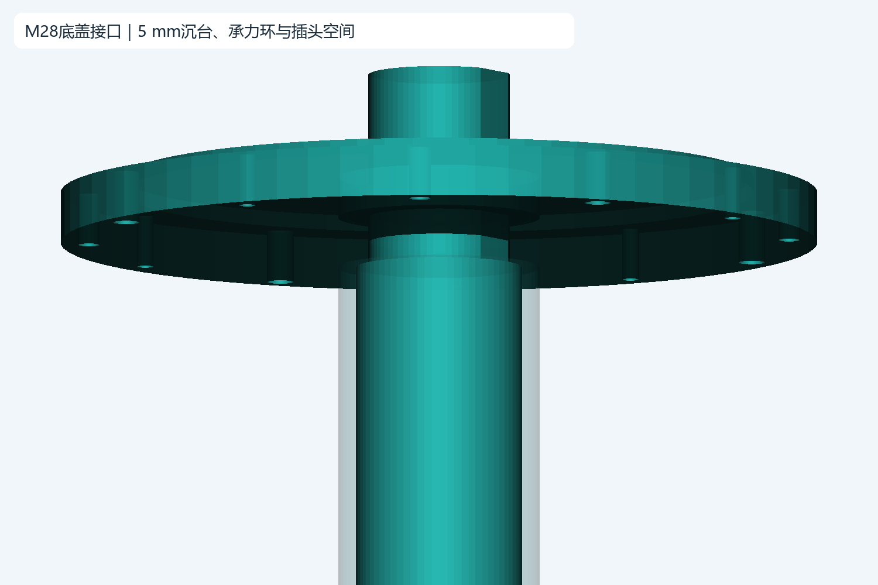
local/spiral-soft-arm/solidworks/electronics_enclosure_v25_power_input_and_m28/B32_v25_M28沉台与承力环细节.png
