songgagav/spiral_soft_arm/local/spiral-soft-arm/solidworks/electronics_enclosure_v25_power_input_and_m28/B32_v25_电子仓分层与电源路径图.png

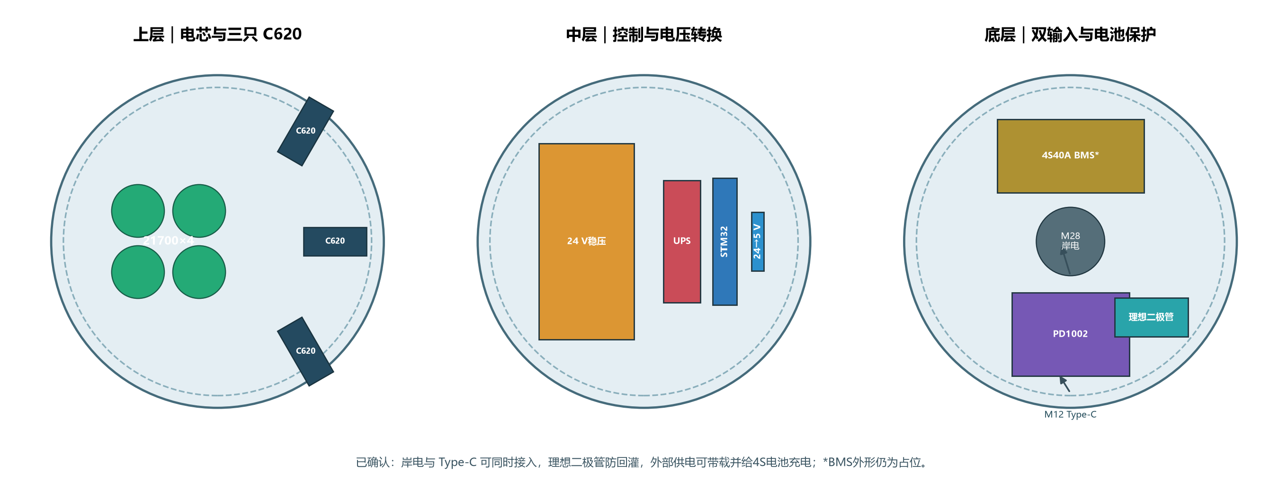
local/spiral-soft-arm/solidworks/electronics_enclosure_v25_power_input_and_m28/B32_v25_电子仓分层与电源路径图.png
