songgagav/spiral_soft_arm/hardware/reference/RoboMaster_C610.STEP

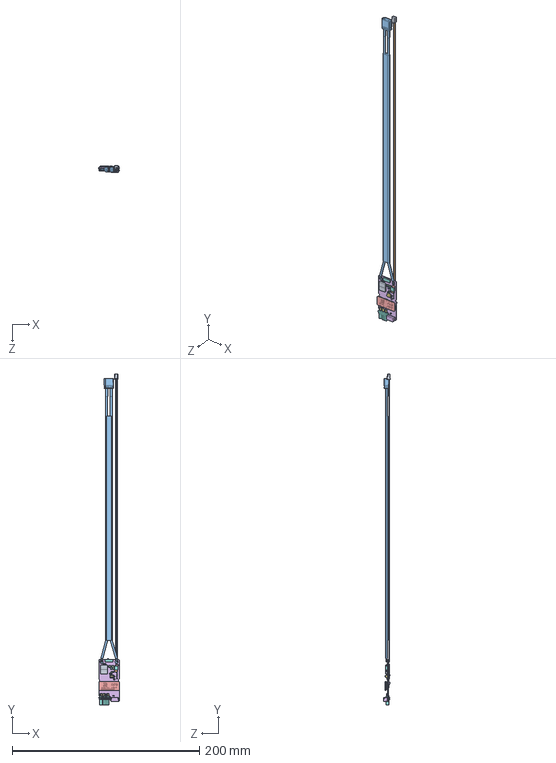
[picture p11: CAD file, 2026-10-21]
hardware/reference/RoboMaster_C610.STEP
22.1 x 353.3 x 7.25 mm
