songgagav/spiral_soft_arm/local/spiral-soft-arm/solidworks/electronics_enclosure_v21_cnc_shaft_sleeve/M3508_D轴套联轴套_CNC首件图_RevA.dxf

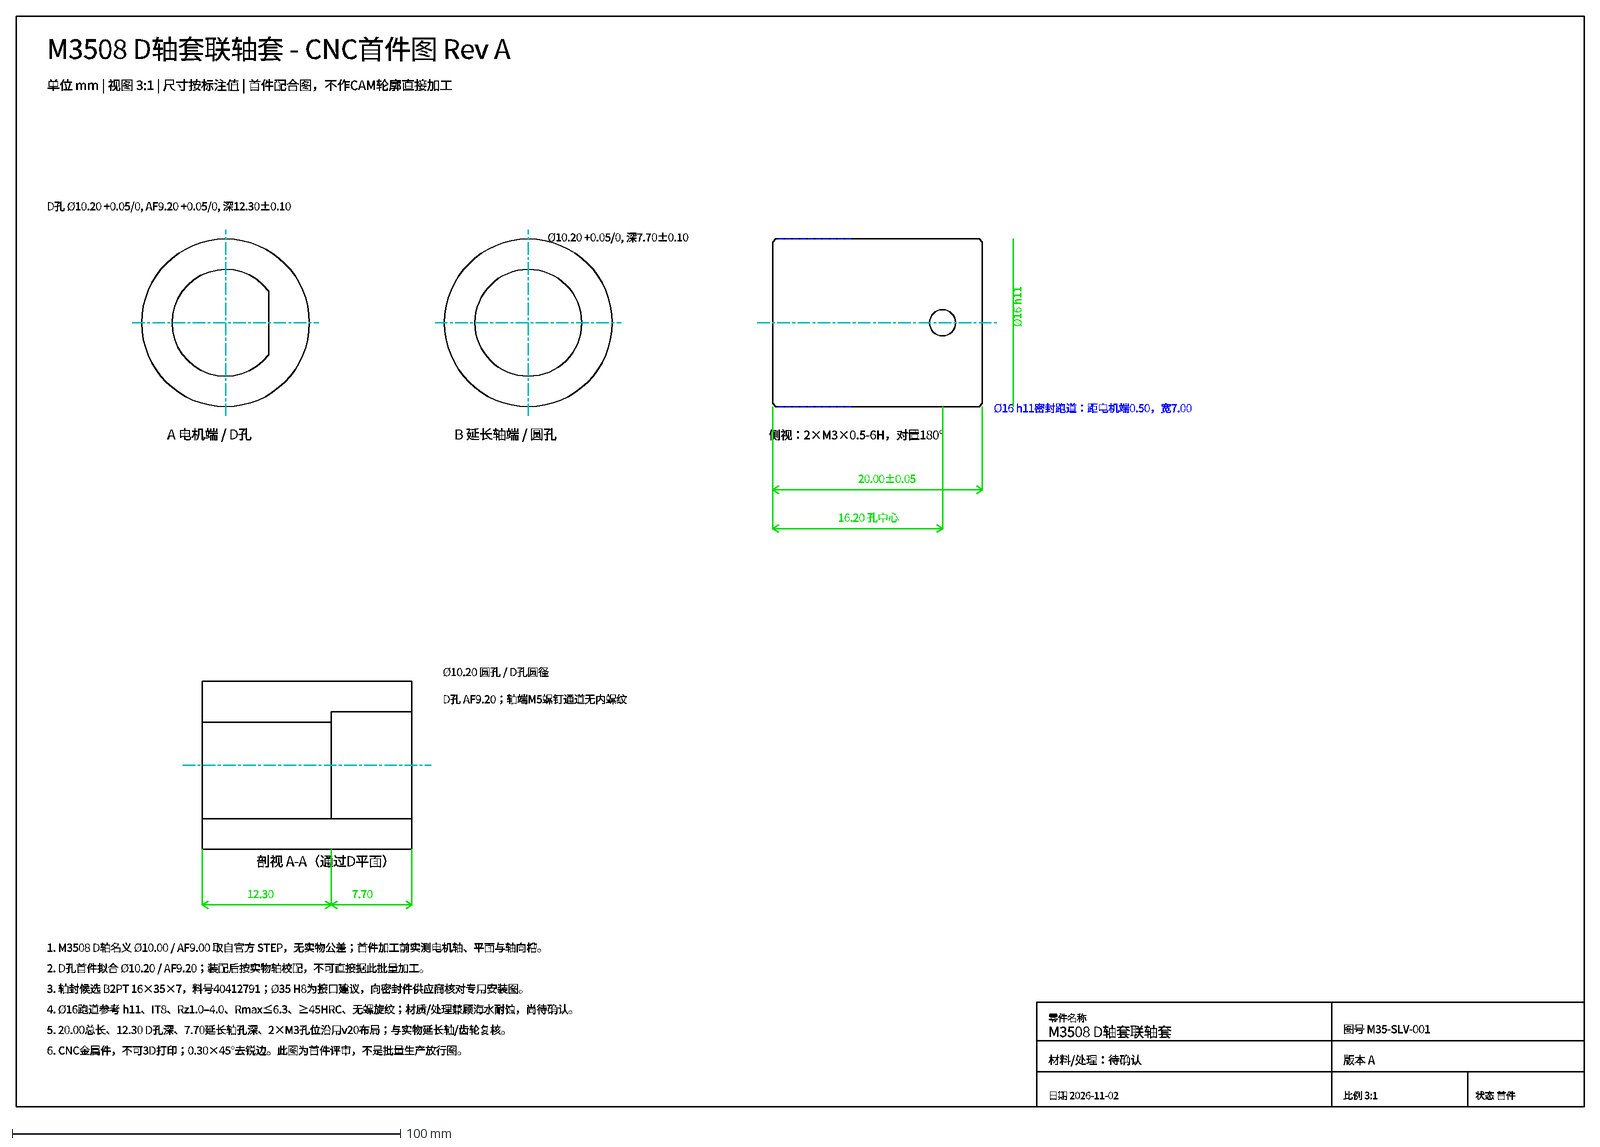
[picture p12: CAD file, 2026-11-05]
local/spiral-soft-arm/solidworks/electronics_enclosure_v21_cnc_shaft_sleeve/M3508_D轴套联轴套_CNC首件图_RevA.dxf
M3508 D轴套联轴套 - CNC首件图 Rev A
单位 mm | 视图 3:1 | 尺寸按标注值 | 首件配合图，不作CAM轮廓直接加工
A 电机端 / D孔
D孔 Ø10.20 +0.05/0, AF9.20 +0.05/0, 深12.30±0.10
B 延长轴端 / 圆孔
Ø10.20 +0.05/0, 深7.70±0.10
侧视：2×M3×0.5-6H，对置180°
Ø16 h11密封跑道：距电机端0.50，宽7.00
20.00±0.05
16.20 孔中心
Ø16 h11
剖视 A-A（通过D平面）
12.30
7.70
Ø10.20 圆孔 / D孔圆径
D孔 AF9.20；轴端M5螺钉通道无内螺纹
1. M3508 D轴名义 Ø10.00 / AF9.00 取自官方 STEP，无实物公差；首件加工前实测电机轴、平面与轴向槽。
2. D孔首件拟合 Ø10.20 / AF9.20；装配后按实物轴校配，不可直接据此批量加工。
3. 轴封候选 B2PT 16×35×7，料号40412791；Ø35 H8为接口建议，向密封件供应商核对专用安装图。
4. Ø16跑道参考 h11、IT8、Rz1.0–4.0、Rmax≤6.3、≥45HRC、无螺旋纹；材质/处理兼顾海水耐蚀，尚待确认。
5. 20.00总长、12.30 D孔深、7.70延长轴孔深、2×M3孔位沿用v20布局；与实物延长轴/齿轮复核。
6. CNC金属件，不可3D打印；0.30×45°去锐边。此图为首件评审，不是批量生产放行图。
零件名称
M3508 D轴套联轴套
图号 M35-SLV-001
材料/处理：待确认
版本 A
日期 2026-11-02
比例 3:1
状态 首件
