songgagav/spiral_soft_arm/hardware/reference/RoboMaster_M2006_P36.STEP

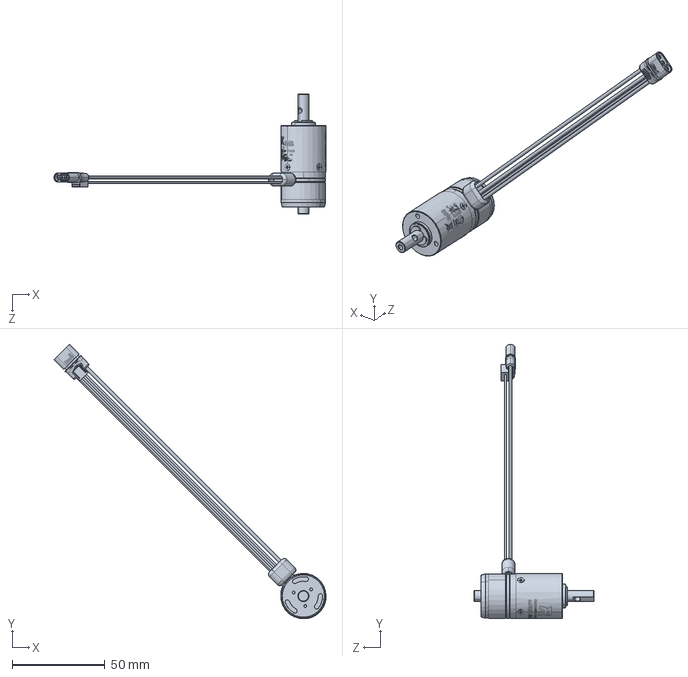
[picture p14: CAD file, 2026-10-21]
hardware/reference/RoboMaster_M2006_P36.STEP
146.4 x 147.7 x 64.8 mm
