songgagav/spiral_soft_arm/local/spiral-soft-arm/solidworks/electronics_enclosure_v21_cnc_shaft_sleeve/M3508_D轴套联轴套_CNC模型_RevA.step

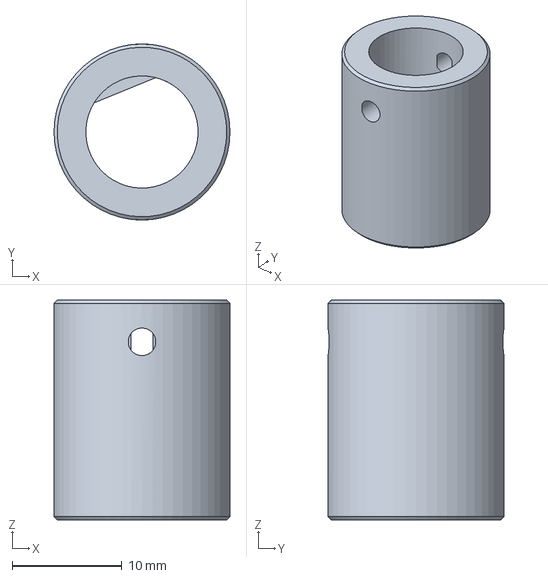
[picture p15: CAD file, 2026-11-05]
local/spiral-soft-arm/solidworks/electronics_enclosure_v21_cnc_shaft_sleeve/M3508_D轴套联轴套_CNC模型_RevA.step
16.0 x 16.0 x 20.0 mm
