songgagav/spiral_soft_arm/local/spiral-soft-arm/solidworks/electronics_enclosure_v24_selected_hardware/B32_v24_选定硬件电子仓.step

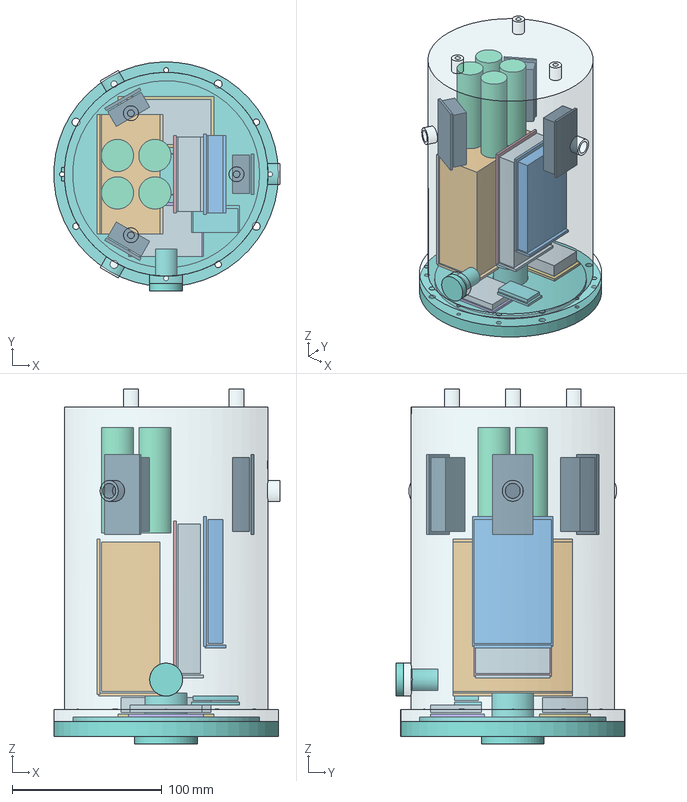
[picture p16: CAD file, 2026-11-06]
local/spiral-soft-arm/solidworks/electronics_enclosure_v24_selected_hardware/B32_v24_选定硬件电子仓.step
150.9 x 153.0 x 237.0 mm
v24_central_electronics_canister
v24_central_bottom_lid_M28_bore
v24_21700_cell_1
v24_21700_cell_2
v24_21700_cell_3
v24_21700_cell_4
v24_4S_cell_carrier
v24_cell_carrier_shelf
v24_controller_envelope
v24_ups_envelope
v24_regulator_envelope
v24_pd1002_envelope
v24_ideal_diode_envelope
v24_bms_envelope
v24_C620_000_envelope
v24_C620_000_backing
v24_C620_120_envelope
v24_C620_120_backing
v24_C620_240_envelope
v24_C620_240_backing
v24_controller_backing
v24_UPS_backing
v24_regulator_backing
v24_controller_lower_rail
v24_ups_lower_rail
v24_regulator_lower_rail
v24_PD1002_shelf
v24_ideal_diode_shelf
v24_BMS_shelf
v24_M28_inside_stem_proxy
v24_M28_outside_flange_proxy
v24_M12_USB_C_inside_stem_proxy
v24_M12_USB_C_outside_flange_proxy
