songgagav/spiral_soft_arm/local/spiral-soft-arm/solidworks/user_3_0/spi_rob_20261012_131147_整体试打.stl

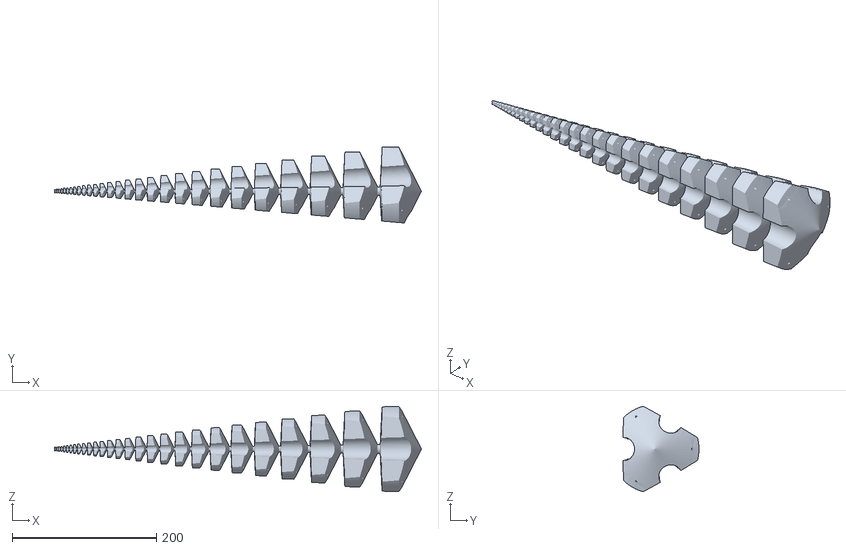
[picture p18: CAD file, 2026-10-21]
local/spiral-soft-arm/solidworks/user_3_0/spi_rob_20261012_131147_整体试打.stl
508.1 x 105.2 x 118.3
