songgagav/spiral_soft_arm/local/spiral-soft-arm/solidworks/electronics_enclosure_v10/B32_三段机械臂_燕尾榫装配.step

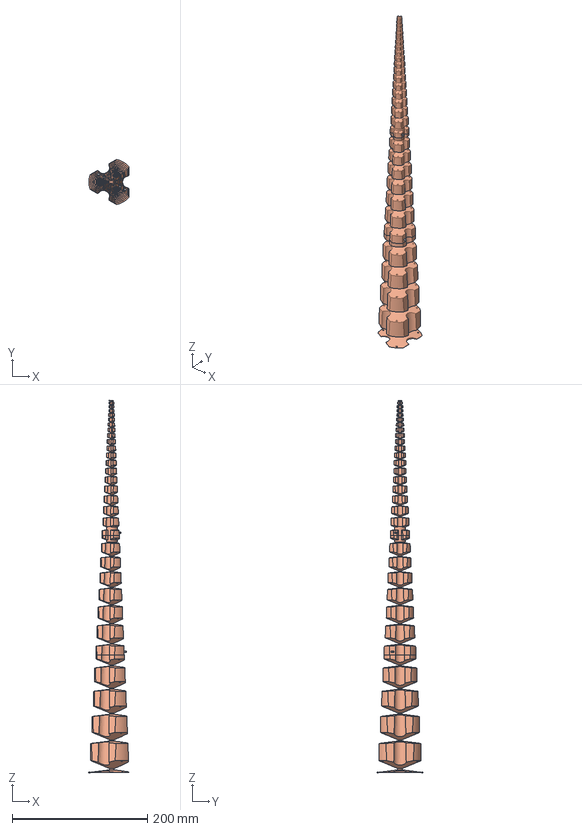
[picture p19: CAD file, 2026-10-22, an earlier design]
local/spiral-soft-arm/solidworks/electronics_enclosure_v10/B32_三段机械臂_燕尾榫装配.step
59.5 x 66.7 x 550.0 mm
arm_section_01
arm_section_02
arm_section_03
cross_pin_01_proxy
cross_pin_02_proxy
