songgagav/spiral_soft_arm/local/spiral-soft-arm/solidworks/electronics_enclosure_v10/print_parts/panel_splice_180_m.stl

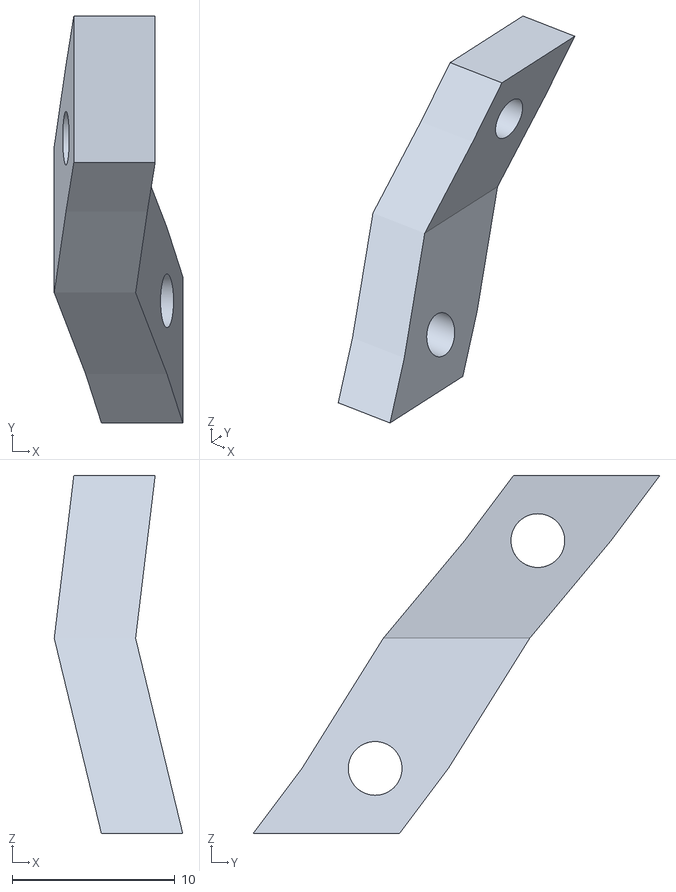
[picture p20: CAD file, 2026-10-22, an earlier design]
local/spiral-soft-arm/solidworks/electronics_enclosure_v10/print_parts/panel_splice_180_m.stl
7.90 x 25.0 x 22.0
