songgagav/spiral_soft_arm/local/spiral-soft-arm/solidworks/electronics_enclosure_v11/B32_M2006干式电机_湿侧线盘总装.step

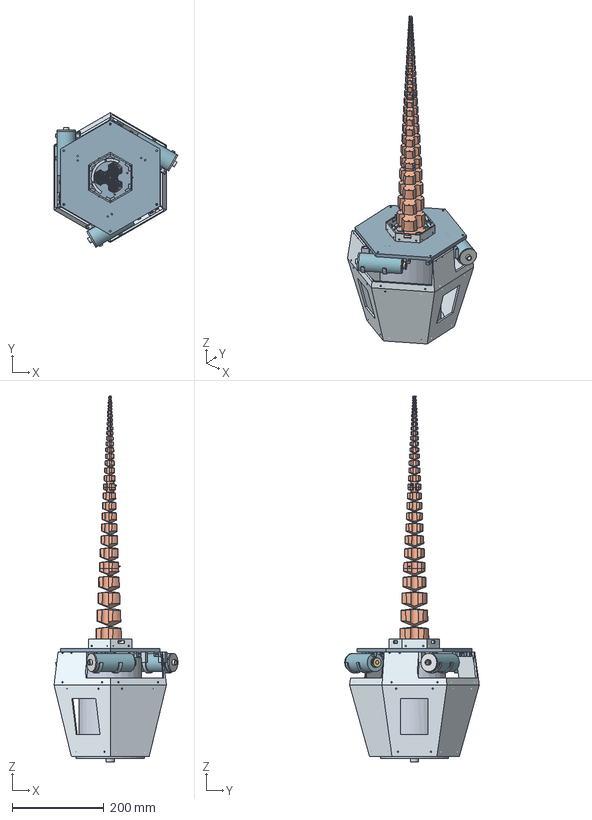
[picture p21: CAD file, 2026-10-23, an earlier design]
local/spiral-soft-arm/solidworks/electronics_enclosure_v11/B32_M2006干式电机_湿侧线盘总装.step
270.1 x 293.7 x 798.0 mm
arm_section_01
arm_section_02
arm_section_03
cross_pin_1_proxy
cross_pin_2_proxy
250mm_hex_plate
root_retainer_1
root_retainer_2
pod_saddle_1
pod_saddle_2
pod_saddle_3
pod_saddle_4
pod_saddle_5
pod_saddle_6
wet_reel_1
wet_reel_2
wet_reel_3
axis_1_pod_proxy
axis_1_rear_cap_proxy
axis_1_motor_proxy
axis_1_d_output_proxy
axis_1_shaft_proxy
axis_1_coupling_proxy
axis_1_bearing_proxy
axis_1_oil_seal_proxy
axis_1_fixed_labyrinth_proxy
axis_1_rotating_labyrinth_proxy
axis_2_pod_proxy
axis_2_rear_cap_proxy
axis_2_motor_proxy
axis_2_d_output_proxy
axis_2_shaft_proxy
axis_2_coupling_proxy
axis_2_bearing_proxy
axis_2_oil_seal_proxy
axis_2_fixed_labyrinth_proxy
axis_2_rotating_labyrinth_proxy
axis_3_pod_proxy
axis_3_rear_cap_proxy
axis_3_motor_proxy
axis_3_d_output_proxy
axis_3_shaft_proxy
axis_3_coupling_proxy
axis_3_bearing_proxy
axis_3_oil_seal_proxy
axis_3_fixed_labyrinth_proxy
axis_3_rotating_labyrinth_proxy
existing_center_dry_canister
center_canister_lid
shore_tether_gland_proxy
upper_panel_000
lower_panel_000
upper_panel_060
lower_panel_060
upper_panel_120
lower_panel_120
upper_panel_180
lower_panel_180
upper_panel_240
lower_panel_240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
