songgagav/spiral_soft_arm/local/spiral-soft-arm/solidworks/electronics_enclosure_v13/B32_v13_M2006竖装共用干仓总装.step

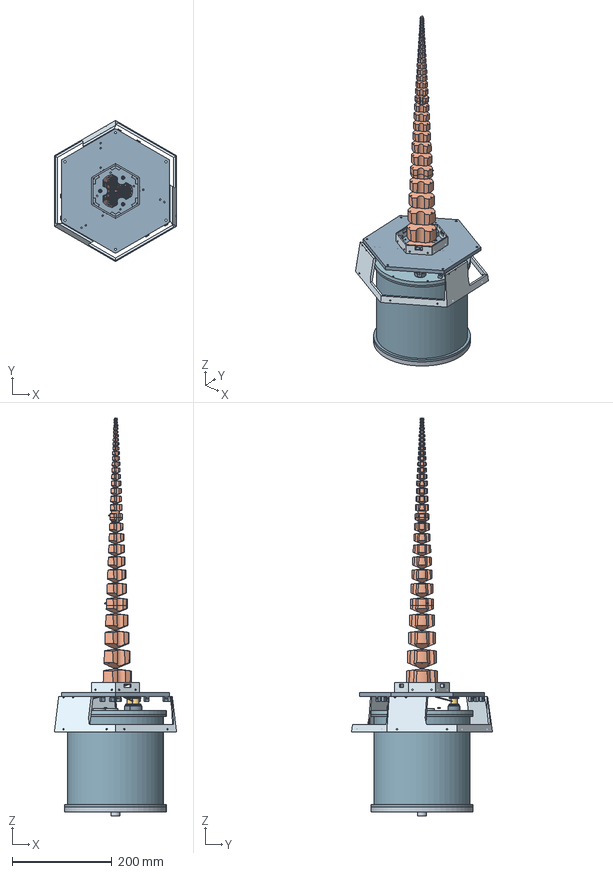
[picture p23: CAD file, 2026-10-25, an earlier design]
local/spiral-soft-arm/solidworks/electronics_enclosure_v13/B32_v13_M2006竖装共用干仓总装.step
245.1 x 283.0 x 798.0 mm
arm_section_1
arm_section_2
arm_section_3
cross_pin_1_proxy
cross_pin_2_proxy
hex_plate_250mm
single_dry_hull_tube
removable_roof_with_gasket_seat
bottom_service_lid
shore_cable_gland_proxy
drive_1_motor
drive_1_motor_adapter
drive_1_output_shaft
drive_1_independent_shaft
drive_1_coupling
drive_1_bearing
drive_1_oil_seal
drive_1_seal_holder
drive_1_fixed_labyrinth
drive_1_rotating_labyrinth
drive_1_wet_reel
drive_2_motor
drive_2_motor_adapter
drive_2_output_shaft
drive_2_independent_shaft
drive_2_coupling
drive_2_bearing
drive_2_oil_seal
drive_2_seal_holder
drive_2_fixed_labyrinth
drive_2_rotating_labyrinth
drive_2_wet_reel
drive_3_motor
drive_3_motor_adapter
drive_3_output_shaft
drive_3_independent_shaft
drive_3_coupling
drive_3_bearing
drive_3_oil_seal
drive_3_seal_holder
drive_3_fixed_labyrinth
drive_3_rotating_labyrinth
drive_3_wet_reel
tendon_1_straight_exit_proxy
tendon_2_straight_exit_proxy
tendon_3_straight_exit_proxy
tendon_1_through_plate_into_arm_root_proxy
tendon_2_through_plate_into_arm_root_proxy
tendon_3_through_plate_into_arm_root_proxy
STM32_controller_envelope
voltage_regulator_envelope
UPS_module_envelope
BMS_envelope
USB_C_PD_input_envelope
USB_C_receptacle_proxy
boost_24V_envelope
STM32_M3_M4_M5_mount_rail_low
STM32_M3_M4_M5_mount_rail_high
regulator_M3_M4_M5_mount_rail_low
regulator_M3_M4_M5_mount_rail_high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
