songgagav/spiral_soft_arm/(list of files, cad)

Other CAD files:
local/spiral-soft-arm/solidworks/electronics_enclosure_v23_cable_and_seal_interfaces/B32_v23_M3508三路拉索与轴封接口总装.step
local/spiral-soft-arm/solidworks/electronics_enclosure_v24_selected_hardware/B32_v24_三路M3508与选定电子仓总装.step
local/spiral-soft-arm/solidworks/electronics_enclosure_v25_power_input_and_m28/B32_v25_三路M3508与电源接口总装.step
local/spiral-soft-arm/solidworks/integrated_assembly_v26_arm_and_v25_electronics/B32_v26_原机械臂与V25电子仓整合总装.step
local/spiral-soft-arm/solidworks/user_3_0/spi_rob_20261012_131147_整体融合.step
local/spiral-soft-arm/solidworks/electronics_enclosure_v10/B32_三段机械臂_六边形包覆总装.step
local/spiral-soft-arm/solidworks/electronics_enclosure_v10/print_parts/arm_section_01.stl
local/spiral-soft-arm/solidworks/electronics_enclosure_v10/print_parts/arm_section_03.stl
local/spiral-soft-arm/solidworks/electronics_enclosure_v10/print_parts/cable_reel_01.stl
local/spiral-soft-arm/solidworks/electronics_enclosure_v10/print_parts/cable_reel_02.stl
local/spiral-soft-arm/solidworks/electronics_enclosure_v10/print_parts/cable_reel_03.stl
local/spiral-soft-arm/solidworks/electronics_enclosure_v10/print_parts/hex_base_plate.stl
local/spiral-soft-arm/solidworks/electronics_enclosure_v10/print_parts/lower_panel_000_flat.stl
local/spiral-soft-arm/solidworks/electronics_enclosure_v10/print_parts/lower_panel_060_flat.stl
local/spiral-soft-arm/solidworks/electronics_enclosure_v10/print_parts/lower_panel_120_flat.stl
local/spiral-soft-arm/solidworks/electronics_enclosure_v10/print_parts/lower_panel_180_flat.stl
local/spiral-soft-arm/solidworks/electronics_enclosure_v10/print_parts/lower_panel_240_flat.stl
local/spiral-soft-arm/solidworks/electronics_enclosure_v10/print_parts/lower_panel_300_flat.stl
local/spiral-soft-arm/solidworks/electronics_enclosure_v10/print_parts/panel_splice_000_m.stl
local/spiral-soft-arm/solidworks/electronics_enclosure_v10/print_parts/panel_splice_060_p.stl
local/spiral-soft-arm/solidworks/electronics_enclosure_v10/print_parts/upper_panel_000_flat.stl
local/spiral-soft-arm/solidworks/electronics_enclosure_v10/print_parts/upper_panel_060_flat.stl
local/spiral-soft-arm/solidworks/electronics_enclosure_v10/print_parts/upper_panel_120_flat.stl
local/spiral-soft-arm/solidworks/electronics_enclosure_v10/print_parts/upper_panel_180_flat.stl
local/spiral-soft-arm/solidworks/electronics_enclosure_v10/print_parts/upper_panel_240_flat.stl
local/spiral-soft-arm/solidworks/electronics_enclosure_v10/print_parts/upper_panel_300_flat.stl
local/spiral-soft-arm/solidworks/electronics_enclosure_v10/print_parts/wet_motor_saddle_01.stl
local/spiral-soft-arm/solidworks/electronics_enclosure_v10/print_parts/wet_motor_saddle_02.stl
local/spiral-soft-arm/solidworks/electronics_enclosure_v10/print_parts/wet_motor_saddle_03.stl
local/spiral-soft-arm/solidworks/electronics_enclosure_v10/print_parts/wet_motor_saddle_04.stl
local/spiral-soft-arm/solidworks/electronics_enclosure_v10/print_parts/wet_motor_saddle_05.stl
local/spiral-soft-arm/solidworks/electronics_enclosure_v10/print_parts/wet_motor_saddle_06.stl
local/spiral-soft-arm/solidworks/electronics_enclosure_v14/B32_v14_物理装配优化总装.step
local/spiral-soft-arm/solidworks/electronics_enclosure_v15/B32_v15_垂直电机水平线盘总装.step
local/spiral-soft-arm/solidworks/electronics_enclosure_v16/B32_v16_减速电机直角传动总装.step
local/spiral-soft-arm/solidworks/electronics_enclosure_v18/references/official/DJI_M3508_P19_official.stp
local/spiral-soft-arm/solidworks/electronics_enclosure_v3/B32_中心电子仓_三湿侧电机总装.step
local/spiral-soft-arm/solidworks/electronics_enclosure_v3/B32_中心电子仓_拆解与接线.step
local/spiral-soft-arm/solidworks/electronics_enclosure_v4/B32_中心电子仓_三湿侧电机总装.step
local/spiral-soft-arm/solidworks/electronics_enclosure_v4/B32_中心电子仓_拆解与接线.step
local/spiral-soft-arm/solidworks/electronics_enclosure_v5/B32_中心电子仓_三湿侧电机总装.step
local/spiral-soft-arm/solidworks/electronics_enclosure_v5/B32_中心电子仓_拆解与接线.step
local/spiral-soft-arm/solidworks/electronics_enclosure_v5/print_panels/lower_panel_180_flat.stl
local/spiral-soft-arm/solidworks/electronics_enclosure_v5/print_panels/lower_panel_240_flat.stl
local/spiral-soft-arm/solidworks/electronics_enclosure_v5/print_panels/upper_panel_000_flat.stl
local/spiral-soft-arm/solidworks/electronics_enclosure_v5/print_panels/upper_panel_060_flat.stl
local/spiral-soft-arm/solidworks/electronics_enclosure_v5/print_panels/upper_panel_120_flat.stl
local/spiral-soft-arm/solidworks/electronics_enclosure_v5/print_panels/upper_panel_180_flat.stl
local/spiral-soft-arm/solidworks/electronics_enclosure_v5/print_panels/upper_panel_240_flat.stl
local/spiral-soft-arm/solidworks/electronics_enclosure_v5/print_panels/upper_panel_300_flat.stl
local/spiral-soft-arm/solidworks/electronics_enclosure_v6/B32_三段机械臂_六边形包覆总装.step
local/spiral-soft-arm/solidworks/electronics_enclosure_v6/B32_三段机械臂_燕尾榫装配.step
local/spiral-soft-arm/solidworks/electronics_enclosure_v6/print_parts/arm_section_01.stl
local/spiral-soft-arm/solidworks/electronics_enclosure_v6/print_parts/arm_section_02.stl
local/spiral-soft-arm/solidworks/electronics_enclosure_v6/print_parts/arm_section_03.stl
local/spiral-soft-arm/solidworks/electronics_enclosure_v6/print_parts/hex_base_plate.stl
local/spiral-soft-arm/solidworks/electronics_enclosure_v6/print_parts/lower_panel_000_flat.stl
local/spiral-soft-arm/solidworks/electronics_enclosure_v6/print_parts/lower_panel_060_flat.stl
local/spiral-soft-arm/solidworks/electronics_enclosure_v6/print_parts/lower_panel_120_flat.stl
local/spiral-soft-arm/solidworks/electronics_enclosure_v6/print_parts/lower_panel_300_flat.stl
local/spiral-soft-arm/solidworks/electronics_enclosure_v6/print_parts/panel_splice_000_m.stl
local/spiral-soft-arm/solidworks/electronics_enclosure_v6/print_parts/panel_splice_000_p.stl
local/spiral-soft-arm/solidworks/electronics_enclosure_v6/print_parts/panel_splice_060_m.stl
local/spiral-soft-arm/solidworks/electronics_enclosure_v6/print_parts/panel_splice_060_p.stl
local/spiral-soft-arm/solidworks/electronics_enclosure_v6/print_parts/panel_splice_120_m.stl
local/spiral-soft-arm/solidworks/electronics_enclosure_v6/print_parts/panel_splice_120_p.stl
local/spiral-soft-arm/solidworks/electronics_enclosure_v6/print_parts/panel_splice_180_m.stl
local/spiral-soft-arm/solidworks/electronics_enclosure_v6/print_parts/panel_splice_180_p.stl
local/spiral-soft-arm/solidworks/electronics_enclosure_v6/print_parts/panel_splice_240_m.stl
local/spiral-soft-arm/solidworks/electronics_enclosure_v6/print_parts/panel_splice_240_p.stl
local/spiral-soft-arm/solidworks/electronics_enclosure_v6/print_parts/panel_splice_300_m.stl
local/spiral-soft-arm/solidworks/electronics_enclosure_v6/print_parts/panel_splice_300_p.stl
local/spiral-soft-arm/solidworks/electronics_enclosure_v6/print_parts/root_guard_180_flat.stl
local/spiral-soft-arm/solidworks/electronics_enclosure_v6/print_parts/root_guard_240_flat.stl
local/spiral-soft-arm/solidworks/electronics_enclosure_v6/print_parts/upper_panel_000_flat.stl
local/spiral-soft-arm/solidworks/electronics_enclosure_v6/print_parts/upper_panel_060_flat.stl
local/spiral-soft-arm/solidworks/electronics_enclosure_v6/print_parts/upper_panel_120_flat.stl
local/spiral-soft-arm/solidworks/electronics_enclosure_v6/print_parts/upper_panel_180_flat.stl
local/spiral-soft-arm/solidworks/electronics_enclosure_v6/print_parts/upper_panel_240_flat.stl
local/spiral-soft-arm/solidworks/electronics_enclosure_v6/print_parts/upper_panel_300_flat.stl
local/spiral-soft-arm/solidworks/electronics_enclosure_v7/B32_三段机械臂_六边形包覆总装.step
local/spiral-soft-arm/solidworks/electronics_enclosure_v7/B32_三段机械臂_燕尾榫装配.step
local/spiral-soft-arm/solidworks/electronics_enclosure_v7/print_parts/arm_section_02.stl
local/spiral-soft-arm/solidworks/electronics_enclosure_v7/print_parts/arm_section_03.stl
local/spiral-soft-arm/solidworks/electronics_enclosure_v7/print_parts/cable_reel_01.stl
local/spiral-soft-arm/solidworks/electronics_enclosure_v7/print_parts/cable_reel_02.stl
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
