songgagav/spiral_soft_arm/local/spiral-soft-arm/solidworks/electronics_enclosure_v23_cable_and_seal_interfaces/README_装配冲突审查.md

# v23 装配审查

审查结果由 `audit_shared_chamber_fit.py` 重新生成并写入本文件夹的 `装配冲突审查.json` 与 `装配审查.json`。当前执行前的旧 v22 报告副本不能作为 v23 证据；最终报告会在 v23 STEP 重导后覆盖。

请同时查看 [`README_拉索过渡与轴封接口.md`](README_拉索过渡与轴封接口.md) 了解轴封尺寸、材料与压力验证限制。
