songgagav/spiral_soft_arm/local/spiral-soft-arm/solidworks/electronics_enclosure_v24_selected_hardware/B32_v24_电子仓半透明装配预览.png

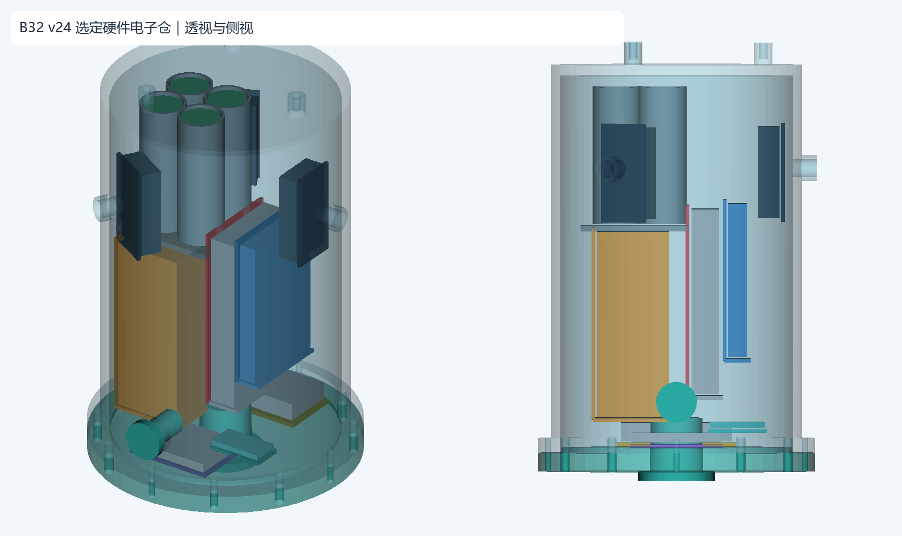
local/spiral-soft-arm/solidworks/electronics_enclosure_v24_selected_hardware/B32_v24_电子仓半透明装配预览.png
