songgagav/spiral_soft_arm/local/spiral-soft-arm/solidworks/integrated_assembly_v26_arm_and_v25_electronics/B32_v26_根部与电子仓接口近景.png

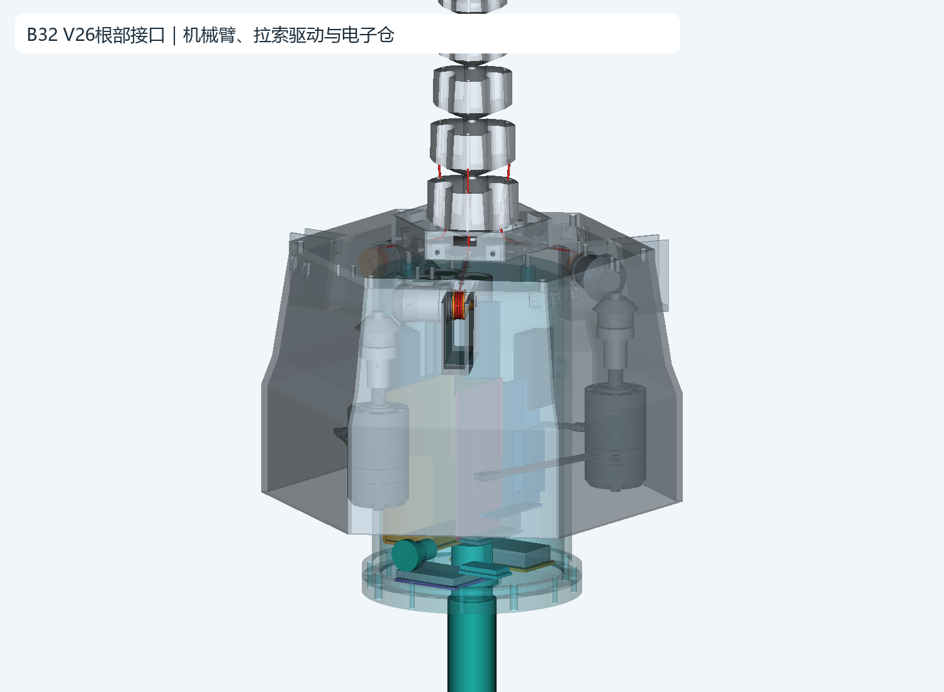
local/spiral-soft-arm/solidworks/integrated_assembly_v26_arm_and_v25_electronics/B32_v26_根部与电子仓接口近景.png
