songgagav/spiral_soft_arm/local/spiral-soft-arm/solidworks/electronics_enclosure_v21_cnc_shaft_sleeve/M3508_D轴套联轴套_CNC首件图_RevA.pdf

# M3508 D轴套联轴套 — CNC首件图

## Rev A | 单位：mm | 视图比例：3:1（尺寸按标注值）

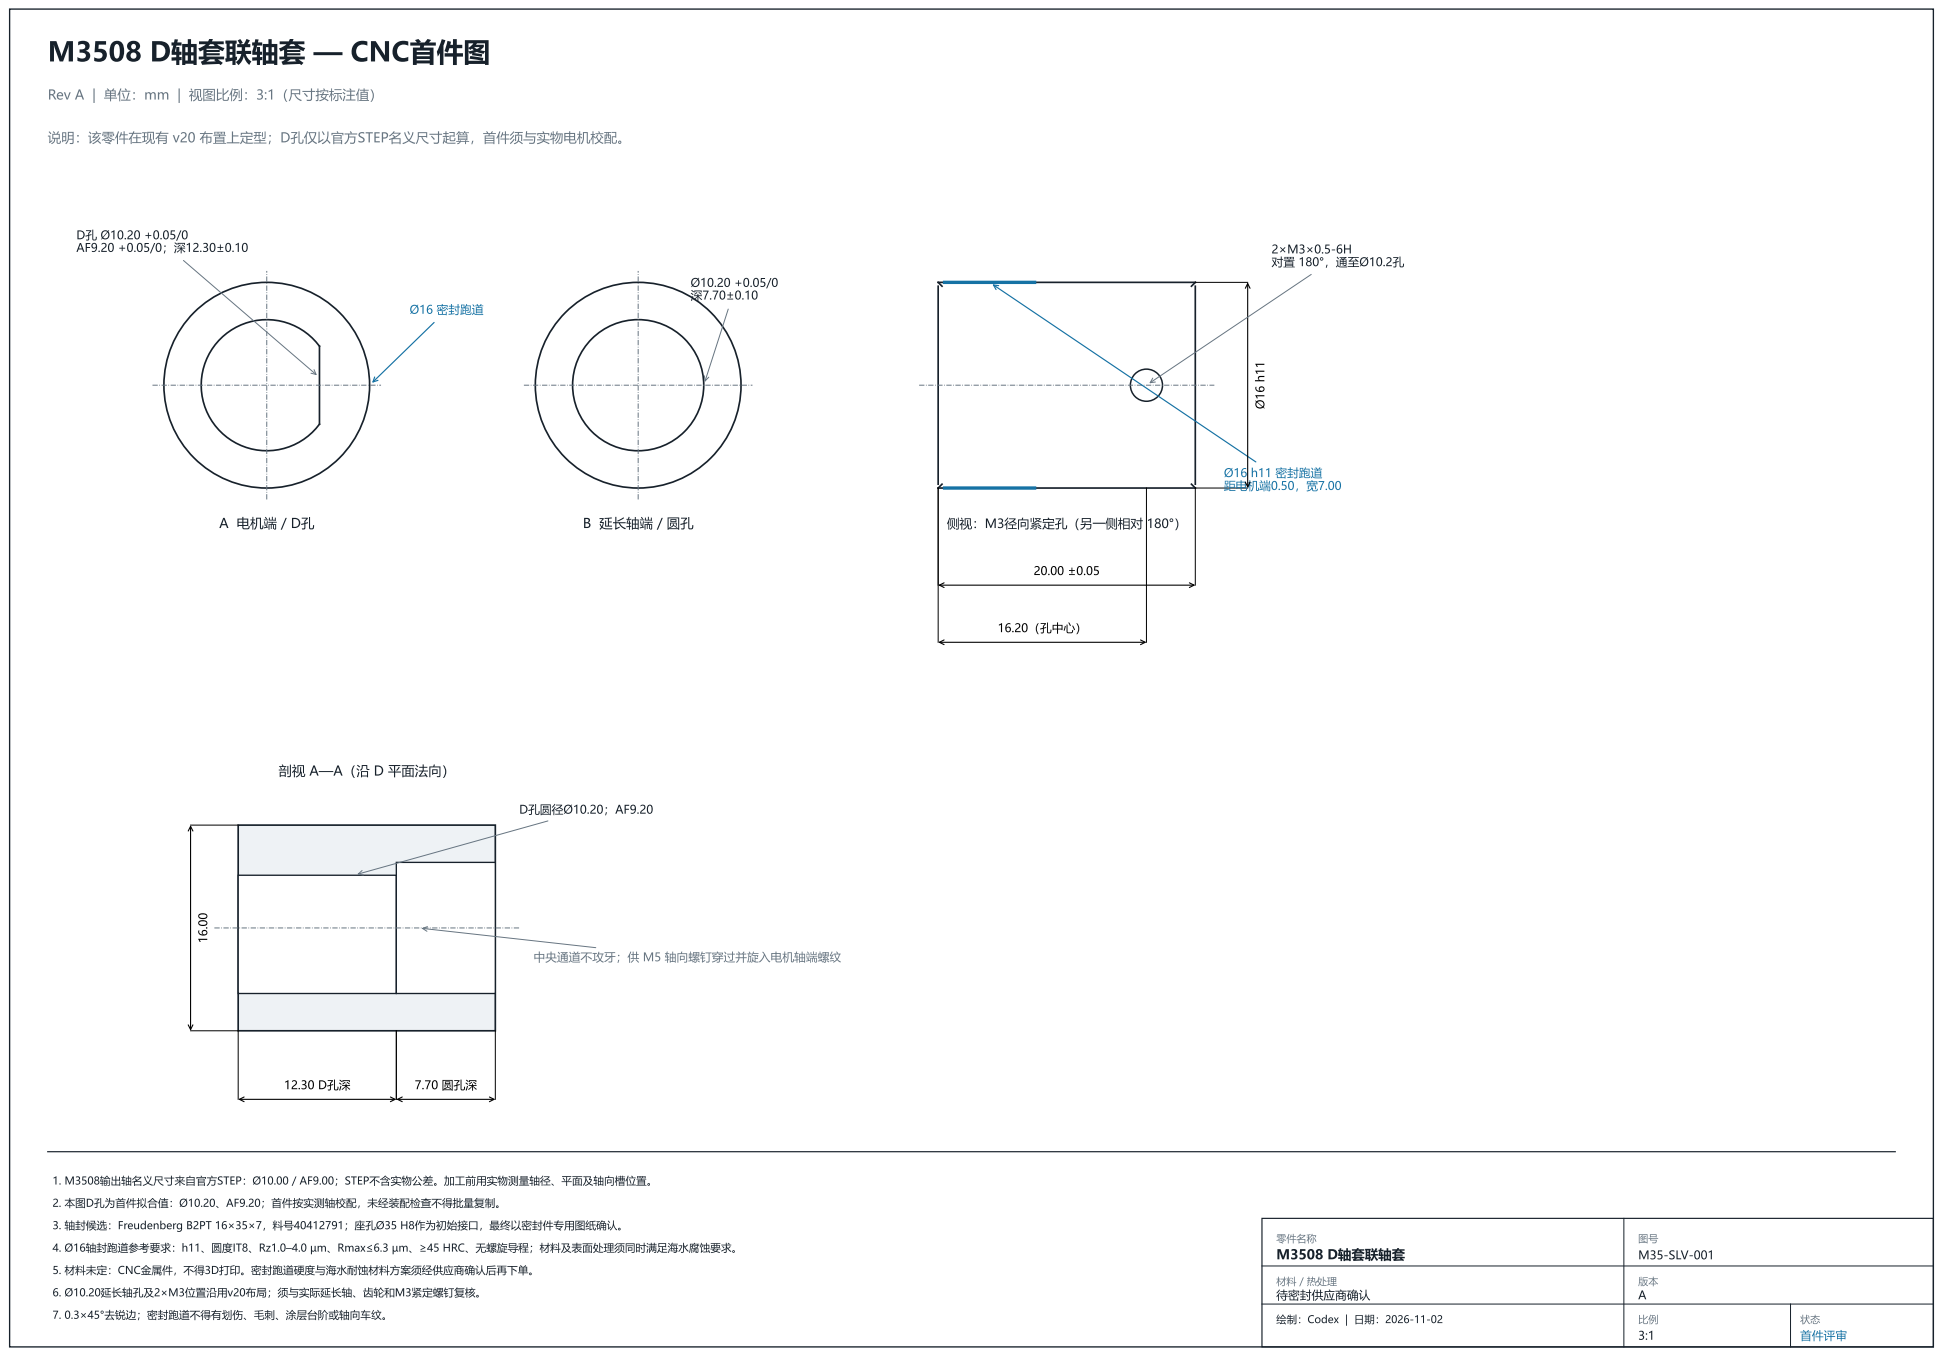
[picture p28: page 1]
A 电机端 / D孔; Ø16 密封跑道; B 延长轴端 / 圆孔; 侧视：M3径向紧定孔（另一侧相对; Ø16 h11 密封跑道 距电机端0.50，宽7.00; 16.20（孔中心）; 2×M3×0.5-6H 对置 180°，通至Ø10.2孔; 剖视 A—A（沿 D 平面法向）; 12.30 D孔深; 7.70 圆孔深; D孔圆径Ø10.20；AF9.20; 中央通道不攻牙；供 M5 轴向螺钉穿过并旋入电机轴端螺纹; 6. Ø10.20延长轴孔及2×M3位置沿用v20布局；须与实际延长轴、齿轮和M3紧定螺钉复核。; 零件名称 M3508 D轴套联轴套; 图号 M35-SLV-001; 材料 / 热处理 待密封供应商确认; 绘制：Codex | 日期：2026-11-02; 状态 首件评审

说明：该零件在现有 v20 布置上定型；D孔仅以官方STEP名义尺寸起算，首件须与实物电机校配。

1. M3508输出轴名义尺寸来自官方STEP：Ø10.00 / AF9.00；STEP不含实物公差。加工前用实物测量轴径、平面及轴向槽位置。

2. 本图D孔为首件拟合值：Ø10.20、AF9.20；首件按实测轴校配，未经装配检查不得批量复制。

3. 轴封候选：Freudenberg B2PT 16×35×7，料号40412791；座孔Ø35 H8作为初始接口，最终以密封件专用图纸确认。

4. Ø16轴封跑道参考要求：h11、圆度IT8、Rz1.0–4.0 µm、Rmax≤6.3 µm、≥45 HRC、无螺旋导程；材料及表面处理须同时满足海水腐蚀要求。

5. 材料未定：CNC金属件，不得3D打印。密封跑道硬度与海水耐蚀材料方案须经供应商确认后再下单。

7. 0.3×45°去锐边；密封跑道不得有划伤、毛刺、涂层台阶或轴向车纹。
