songgagav/spiral_soft_arm/(commit log)

2026-10-21 Initial public spiral soft arm project
2026-10-22 docs: clarify hardware topology wiring
2026-10-22 cad: align reel exits and chamfer tendon holes in v10
2026-10-23 cad: add dry M2006 drive and wet reel v11 candidate
2026-10-23 cad: move M2006 motors into shared dry chamber
2026-10-23 cad: simplify M2006 shared dry chamber with vertical motors
2026-10-25 cad: align reel tangents with actual arm root channels
2026-10-25 cad: add chamfers to three tendon ports
2026-10-25 cad: physically arrange shared dry chamber v14
2026-10-25 cad: orient reel shafts perpendicular to vertical motors
2026-10-25 Model mainland-sourced M3508 geared drive and dry miter transmission
2026-10-25 Redesign M3508 power and UPS topology
2026-10-25 Add shore charging and low-loss power routing
2026-10-25 Add USB-C battery charging path
2026-10-25 Simplify power topology diagram
2026-10-25 Clarify dual-input battery charging path
2026-11-05 Add B32 v23 cable path and shaft seal candidate
2026-11-06 Add B32 v24 selected electronics chamber layout
2026-11-06 Define B32 v25 power and M28 interfaces
2026-11-06 Model B32 v25 M28 mount and controller buck
2026-11-06 Complete B32 v25 power interface candidate
2026-11-06 Define B32 V26 integrated assembly
2026-11-07 Add B32 V26 integrated arm assembly
